AtchariyaM/LoRa-Technology-for-Environmental/us/image/15.jpg

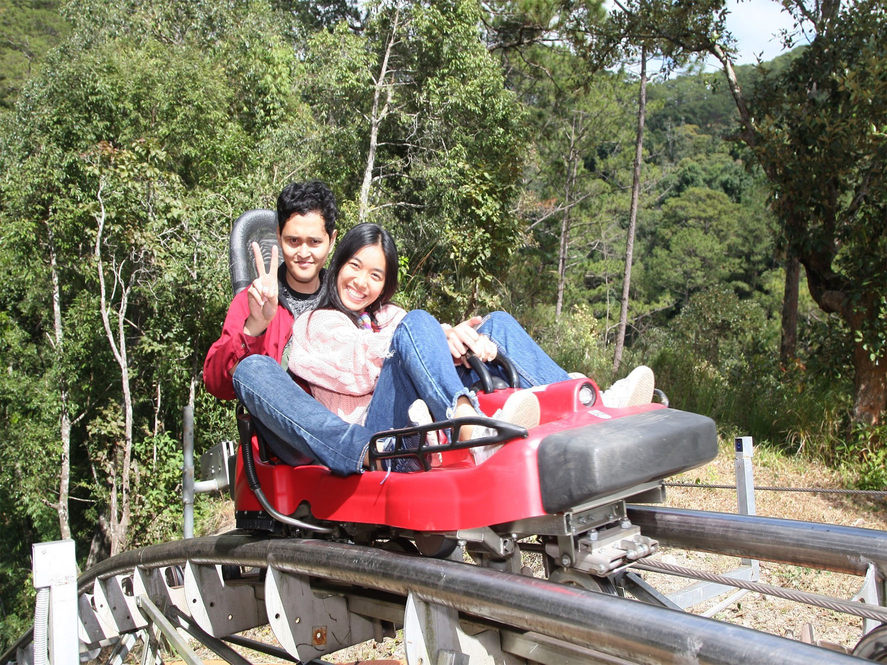
us/image/15.jpg
