AtchariyaM/LoRa-Technology-for-Environmental/us/image/17.jpg

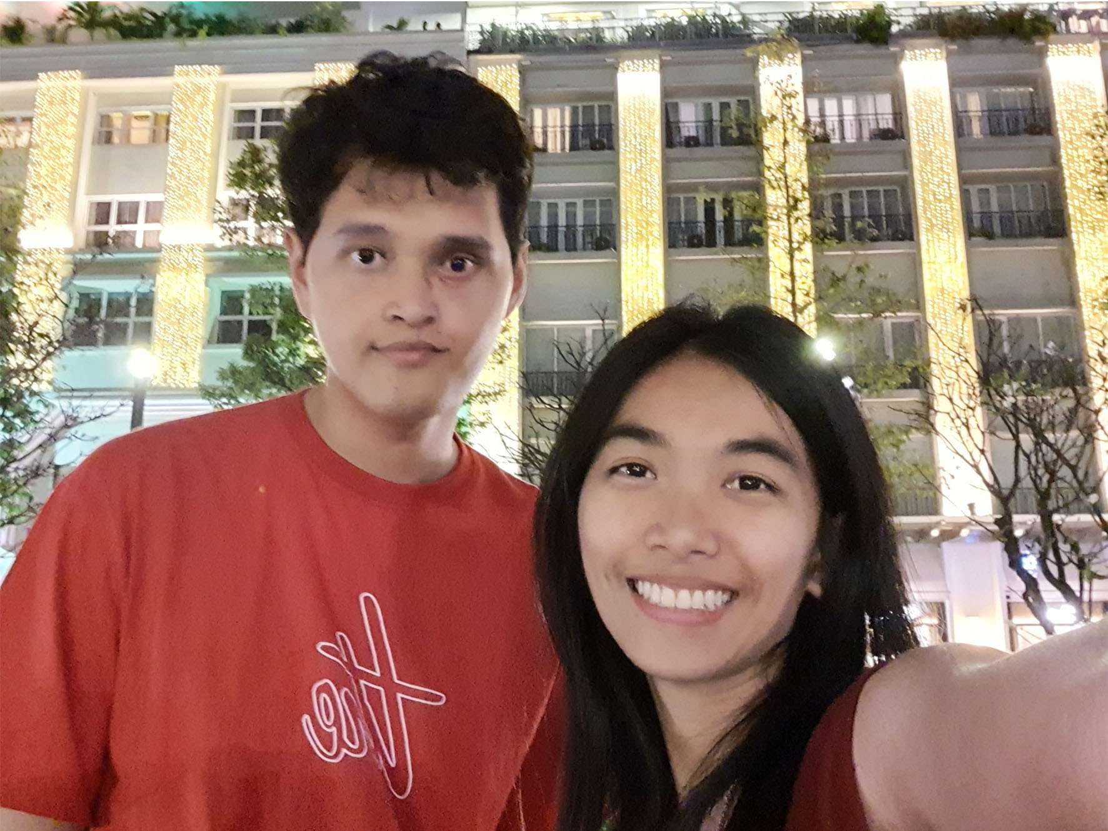
us/image/17.jpg
