AtchariyaM/LoRa-Technology-for-Environmental/lora/project-EE601-20/project-EE601-20.pdf

ระบบเซนเซอร์ทางด้านสิ่งแวดล้อมโดยใช้เทคโนโลยีลอร่าเพื่อการติดตามคุณภาพน ้า ENVIRONMENTAL SENSOR SYSTEM USING LORA TECHNOLOGY FOR WATER QUALITY MONITORING

อัจฉริยา | มะธิมะตา
พัสวี | มีสีผ่อง
รินทร์นภา | ฤทธิรงค์

ปริญญานิพนธ์นี เป็นส่วนหนึ่งของการศึกษาตามหลักสูตรวิศวกรรมศาสตรบัณฑิต ภาควิชาวิศวกรรมไฟฟ้า คณะวิศวกรรมศาสตร์ มหาวิทยาลัยบูรพา
ปีการศึกษา 2561

ระบบเซนเซอร์ทางด้านสิ่งแวดล้อมโดยใช้เทคโนโลยีลอร่าเพื่อการติดตามคุณภาพน ้า ENVIRONMENTAL SENSOR SYSTEM USING LORA TECHNOLOGY FOR WATER QUALITY MONITORING

อัจฉริยา | มะธิมะตา
พัสวี | มีสีผ่อง
รินทร์นภา | ฤทธิรงค์

ปริญญานิพนธ์นี เป็นส่วนหนึ่งของการศึกษาตามหลักสูตรวิศวกรรมศาสตรบัณฑิต ภาควิชาวิศวกรรมไฟฟ้า คณะวิศวกรรมศาสตร์ มหาวิทยาลัยบูรพา
ปีการศึกษา 2561

ENVIRONMENTAL SENSOR SYSTEM USING LORA TECHNOLOGY FOR WATER QUALITY MONITORING

ATCHARIYA MATIMATA
PASSAWEE MEESEEPONG
RINNAPA RITTHIRONG

A PROJECT SUBMITTED IN PARTIAL FULFILLMENT OF THE REQUIREMENTS FOR THE DEGREE OF BACHELOR OF ENGINEERING DEPARTMENT OF ELECTRICAL ENGINEERING BURAPHA UNIVERSITY 2018

ปริญญานิพนธ์ | ระบบเซนเซอร์ทางด้านสิ่งแวดล้อมโดยใช้เทคโนโลยีลอร่าเพื่อการติดตาม
| คุณภาพน ้า
โดย | นางสาวอัจฉริยา มะธิมะตา
| นางสาวพัสวี มีสีผ่อง
| นางสาวรินทร์นภา ฤทธิรงค์
อาจารย์ที่ปรึกษา | ดร.สัญชัย เอียดปราบ
จ้านวนหน้า | 81 หน้า
ปีการศึกษา | 2561

ภาควิชาวิศวกรรมไฟฟ้า คณะวิศวกรรมศาสตร์ มหาวิทยาลัยบูรพา อนุมัติปริญญานิพนธ์นี เป็นส่วน หนึ่งของการศึกษาตามหลักสูตรปริญญาวิศวกรรมศาสตรบัณฑิต สาขาวิชาวิศวกรรมไฟฟ้า

| ประธานกรรมการสอบปริญญานิพนธ์
(ดร.ภาณุวัฒน์ ด่านกลาง)
| กรรมการสอบปริญญานิพนธ์
(ผู้ช่วยศาสตราจารย์ดร.จันทนา ปัญญาวราภรณ์)
| กรรมการสอบปริญญานิพนธ์
(รองศาสตราจารย์วิรุฬห์ ศรีบริรักษ์)
| อาจารย์ที่ปรึกษา
(ดร.สัญชัย เอียดปราบ)
| หัวหน้าภาควิชาวิศวกรรมไฟฟ้า
(ดร.ณัฐพันธ์ ถนอมสัตย์)

บทคัดย่อ

การวัดคุณภาพน ้าโดยทั่วไปแล้วจะต้องท้าการวัดค่า ณ จุดที่ต้องการทดสอบ หากพื นที่ที่ต้องการวัด ทดสอบมีขนาดใหญ่ก็จะต้องเพิ่มจุดทดสอบหลายจุด และถ้าเป็นการวัดซ ้า ๆ เพื่อติดตามคุณภาพน ้าด้วยแล้ว ยิ่งท้าให้เกิดความยุ่งยาก และใช้เวลานาน โครงงานนี จึงเล็งเห็นความส้าคัญของปัญหาดังกล่าวข้างต้น จึงได้ ออกแบบระบบเซนเซอร์ทางด้านสิ่งแวดล้อมโดยใช้เทคโนโลยีลอร่าเฝ้าติดตามคุณภาพน ้า เป็นการวัดและเก็บ ข้อมูลคุณภาพน ้าตามพื นที่ที่ต้องการซ ้า ๆ ตามเวลาที่ก้าหนด ซึ่งค่าที่ท้าการวัดนั น ได้แก่ อุณหภูมิความเป็น กรดเป็นด่าง ปริมาณออกซิเจนที่ละลายน ้า และความสามารถในการออกซิไดซ์หลักการท้างานของระบบ เซนเซอร์คือ ข้อมูลจากเซนเซอร์จะส่งข้อมูลผ่านเทคโนโลยีลอร่าโดยมีการใช้โปรโตคอลลอร่าที่ออกแบบ แพ็กแก็ตส้าหรับในการส่งข้อมูลไปยังเกตเวย์ลอร่า ใช้เครือข่ายอินเทอร์เน็ตเป็นตัวกลางในการส่งข้อมูลมาที่ ฐานข้อมูล Firebase และแสดงผลผ่านเว็บไซต์โดยใช้ภาษา HTML JavaScript และ CSS ในการทดสอบใช้ งานพบว่าในพื นที่ที่มีสิ่งกีดขวางเทคโนโลยีลอร่าสามารถรับส่งข้อมูลถึงกันในระยะ 0-4.47 กิโลเมตร มีระดับ ความไวในการรับส่งสัญญาณอยู่ที่ -8 dBm ถึง -119 dBm เมื่อระยะทางไกลขึ นสัญญาณการรับส่งผ่าน เทคโนโลยีลอร่าเริ่มอ่อนลง คือมีระดับความไวในการรับสัญญาณอยู่ที่ -120 dBm เนื่องจากมุมอับสัญญาณ และค่าความถูกต้องของการวัดค่าคุณภาพน ้าขึ นอยู่กับค่าความคลาดเคลื่อนของอุปกรณ์เซนเซอร์ และเมื่อใช้ งานไประยะหนึ่งพบว่าอุปกรณ์บางตัวท้างานไม่เต็มประสิทธิภาพ อันเนื่องมาจากการเก็บรักษาหัววัดเป็นสิ่ง ส้าคัญ

ค้าส้าคัญ: การวัดคุณภาพน ้า ระบบเซนเซอร์ทางด้านสิ่งแวดล้อม เทคโนโลยีลอร่า

ii

Abstract

In general, the water quality measurements must be measured at the point of testing. If the area that needs to be tested is very large, there will need to add several test points. If there are repeated measurements to track the water quality, it will be complicated and it will take a long time. This project give precedence to the above problems and design the environmental sensors using LoRa technology to track the water quality. It is a measurement and data collection of water quality according to the area that requires repeated testing at the specified time. The values for the measurement are temperature, Potential of Hydrogen ion, Dissolved Oxygen and Oxidation Reduction Potential. The working principle of the sensor system is that the data from the sensor will be sent via the LoRa technology, using the LoRa protocol that designed a package for sending data to the LoRa gateway. The internet network is the medium for sending data to the Firebase database and is displayed via the website using HTML, JavaScript and CSS. In the test of usage, it was found that the areas with LoRa technological obstacles can receive and send data at a distance of 0-4.47 kilometers. The level of received signal strength indicator is will be at -8 dBm to -119 dBm. If the distance is longer, the signal of transmitting through the Laura technology will begin to weaken. The received signal strength indicator will be at -120 dBm because the airless and accuracy of the water quality measurement depends on the tolerance of the sensor device. When used for a while, it was found that some devices do not work efficiently because keeping the measure is important.

Keywords: Water quality measurement, Environmental sensor system, LoRa technology

iii

กิตติกรรมประกาศ

ปริญญานิพนธ์ฉบับนี ส้าเร็จลุล่วงไปได้ด้วยดี ด้วยความช่วยเหลืออย่างดียิ่งจาก อาจารย์ ดร. สัญชัย เอียดปราบ อาจารย์ที่ปรึกษาปริญญานิพนธ์ ที่ได้ให้ความอนุเคราะห์ คอยให้แนวคิด ค้าปรึกษาค้าแนะน้าและ ข้อคิดเห็นต่าง ๆ ในการท้าปริญญานิพนธ์มาโดยตลอด ขอขอบพระคุณคณะกรรมการสอบปริญญานิพนธ์ทุก ท่านที่กรุณาให้ค้าแนะน้าต่าง ๆ ที่เป็นประโยชน์ตลอดจนคณาจารย์ทุกท่านที่ไม่ได้กล่าวนามไว้ ณ ที่นี ผู้ด้าเนินโครงงาน ขอขอบคุณภาควิชาวิศวกรรมไฟฟ้า ที่ได้เอื อเฟื้อสถานที่ท้าการทดลอง เครื่องมือและอุปกรณ์ ในการด้าเนินโครงงาน อีกทั งขอขอบพระคุณที่สนับสนุนโครงงานในครั งนี ซึ่งท้าให้โครงงานในครั งนี ส้าเร็จลุล่วง ไปด้วยดีขอบคุณสมาชิกในกลุ่มทุกคนที่ให้ความช่วยเหลือ ตลอดจนค้าแนะน้าที่เป็นประโยชน์ในการท้า ปริญญานิพนธ์นี ท้ายที่สุด ขอกราบขอบพระคุณ คุณพ่อและคุณแม่ ผู้ปกครอง ที่ให้ค้าปรึกษาในเรื่องต่าง ๆ ให้ ความสะดวกสบาย รวมทั งเป็นผู้ให้ก้าลังใจ และให้โอกาสการศึกษาอันมีค่ายิ่ง ผู้ด้าเนินโครงงานขอขอบพระคุณ ทุกท่านอย่างสูงที่ให้ การสนับสนุน เอื อเฟื้อและให้ความอนุเคราะห์ช่วยเหลือ จนกระทั่งปริญญานิพนธ์ฉบับนี ส้าเร็จลุล่วงไปด้วยดี

iv

สารบัญ
หน้า

v

vi

vii

สารบัญรูปภาพ
หน้า

viii

สารบัญรูปภาพ (ต่อ)
หน้า

ix

สารบัญรูปภาพ (ต่อ)
หน้า

x

สารบัญตาราง
หน้า

บทที่ 1
บทน้า

### 1.1 บทน้า

การเฝ้าติดตามคุณภาพน ้าเป็นการวัด และเก็บข้อมูลคุณภาพน ้าตามพื นที่ที่ต้องการซ ้า ๆ ตามเวลาที่ ก้าหนด โดยอาจจะท้าการวัดทุกหนึ่งนาทีหรือทุกหนึ่งชั่วโมง ขึ นอยู่กับความละเอียดของข้อมูลที่น้าไปใช้ในการ วิเคราะห์ ซึ่งค่าที่ท้าการวัดนั น ได้แก่ อุณหภูมิ (Temperature) ความเป็นกรดเป็นด่าง (Potential of Hydrogen ion: pH) ปริมาณออกซิเจนที่ละลายน ้า (Dissolved Oxygen: DO) และความสามารถในการ ออกซิไดซ์ (Oxidation Reduction Potential: ORP) เพื่อน้าข้อมูลที่ได้มาวิเคราะห์สถานภาพของน ้าหรือ คาดการณ์ปัญหาที่จะเกิดขึ น และสามารถหาทางแก้ไขได้ทันเวลา แต่การวัดคุณภาพน ้าโดยทั่วไปแล้วจะได้ค่าที่ บริเวณที่ท้าการวัดเท่านั น หากพื นที่ที่ต้องการวัดทดสอบมีขนาดใหญ่ก็จะต้องเพิ่มจุดทดสอบหลายจุด และถ้า เป็นการวัดซ ้า ๆ เพื่อติดตามคุณภาพน ้าด้วยแล้วยิ่งท้าให้เกิดความยุ่งยาก และใช้เวลานาน จึงจ้าเป็นต้องใช้ ระบบเครือข่ายในการรับ-ส่ง และเก็บข้อมูลของอุปกรณ์วัดคุณภาพน ้าทั งหมด
เทคโนโลยีลอร่า (LoRa) เป็นเทคโนโลยีการส่งข้อมูลแบบไร้สายในระยะไกล ใช้พลังงานต่้า มีย่าน ความถี่ที่สามารถใช้งานได้ในย่านความถี่ 923 MHz โดยที่ไม่ต้องขออนุญาต โดยโครงงานนี ใช้อุปกรณ์พื นฐาน เป็นบอร์ด TTGO T-Beam ESP32 LoRa 923 MHz 2 ตัว เพื่อท้าหน้าที่เป็นตัวรับ-ส่งข้อมูลแบบไร้สาย ดังนั น โครงงานนี จึงน้าเสนอการน้าเทคโนโลยีลอร่ามาประยุกต์ใช้กับการเฝ้าติดตามคุณภาพน ้า โดยจะสร้างระบบ เซนเซอร์ทางด้านสิ่งแวดล้อม ทั งหมด 4 ตัว เซนเซอร์แต่ละตัวจะสามารถวัดค่าอุณหภูมิ ความเป็นกรดเป็น ด่าง ปริมาณออกซิเจนที่ละลายน ้า และความสามารถในการออกซิไดซ์ โดยระบบเซนเซอร์ที่น้ามาใช้ในการวัด คุณภาพน ้า จะถูกติดตั งไว้ที่บอร์ดฝั่งส่งข้อมูล เพื่อส่งข้อมูลไปยังฝั่งรับ แล้วท้าการรวบรวมข้อมูลที่วัดได้ส่ง ต่อไปเก็บไว้ในฐานข้อมูล เพื่อแสดงผลคุณภาพน ้าและท้าการวิเคราะห์คุณภาพน ้าแบบเวลาจริงต่อไป

### 1.2 วัตถุประสงค์

1) เพื่อศึกษาเกี่ยวกับการวัดคุณภาพน ้าโดยใช้เซนเซอร์ทางด้านสิ่งแวดล้อมทั งหมด 4 ตัว ได้แก่ เซนเซอร์วัดค่าอุณหภูมิ เซนเซอร์วัดความเป็นกรดเป็นด่าง เซนเซอร์วัดออกปริมาณออกซิเจนที่ ละลายน ้า และเซนเซอร์วัดความสามารถในการออกซิไดซ์
2) เพื่อศึกษาเกี่ยวกับการสร้างระบบเซนเซอร์ทางด้านสิ่งแวดล้อมโดยใช้เทคโนโลยีลอร่า และการ เลือกใช้โปรโตคอลในการรับ–ส่งข้อมูลให้เหมาะสม
3) เพื่อศึกษาเกี่ยวกับการระบุต้าแหน่งอุปกรณ์โดยใช้หลักการการระบุต้าแหน่งบนพื นโลก (GPS)
4) เพื่อออกแบบและสร้างระบบเซนเซอร์ทางด้านสิ่งแวดล้อมโดยใช้เทคโนโลยีลอร่า
5) เพื่อท้าการวิเคราะห์คุณภาพน ้าและแสดงผลข้อมูลแบบเวลาจริง

### 1.3 ขอบเขตการท้าโครงงาน

1) ออกแบบ และสร้างระบบเซนเซอร์ทางด้านสิ่งแวดล้อมโดยใช้เทคโนโลยีลอร่า โดยสามารถวัดค่า อุณหภูมิ ความเป็นกรดเป็นด่าง ปริมาณออกซิเจนละลายน ้า และความสามารถในการออกซิไดซ์ โดยใช้แบตเตอรี่ที่ชาร์จพลังงาน
2) ใช้บอร์ด TTGO T-Beam ESP32 LoRa 923 MHz เป็นตัวควบคุมเซนเซอร์ และส่งข้อมูลผ่าน เทคโนโลยีลอร่า
3) สร้างฐานข้อมูลโดยใช้ Firebase Realtime Database
4) สร้างหน้าเว็บส้าหรับวิเคราะห์คุณภาพน ้าและแสดงผลข้อมูลแบบเวลาจริงโดยใช้ภาษา HTML JavaScript และ CSS
5) พื นที่ในการทดสอบคือแหล่งน ้าสวนนันทนาการ มหาวิทยาลัยบูรพา

### 1.4 แผนการด้าเนินการ

1) จัดท้า และเสนอหัวข้อโครงงาน
2) ศึกษารูปแบบ และหลักการท้างานของเซนเซอร์เซนเซอร์ทางด้านสิ่งแวดล้อม
3) ศึกษาหลักการท้างานของระบบเซนเซอร์ทางด้านสิ่งแวดล้อม
4) ออกแบบ และสร้างระบบเซนเซอร์ทางด้านสิ่งแวดล้อมโดยใช้เทคโนโลยีลอร่า
5) ศึกษาการเลือกใช้โปรโตคอลในการรับ–ส่งข้อมูล
6) วิเคราะห์ปัญหา และออกแบบวิธีการแก้ปัญหา
7) ทดสอบระบบเซนเซอร์ทางด้านสิ่งแวดล้อมโดยใช้เทคโนโลยีลอร่า
8) ออกแบบ และสร้างฐานข้อมูลส้าหรับเก็บข้อมูลคุณภาพน ้า
9) ออกแบบ และสร้างหน้าเว็บไซต์ส้าหรับวิเคราะห์และแสดงผลคุณภาพน ้า
10) ประเมินผลการทดสอบและปรับปรุงแก้ไขข้อบกพร่อง
11) จัดท้าเอกสารโครงงานฉบับสมบูรณ์

ตารางที่ 1.1 แผนการด้าเนินงานของโครงงาน
ขั นตอนที่ | โครงงานวิศวกรรม 1 | โครงงานวิศวกรรม 2
ส.ค. | ก.ย. | ต.ค. | พ.ย. | ธ.ค. | ม.ค. | ก.พ. | มี.ค. | เม.ย. | พ.ค.
1 | 2 | 3 | 4 | 1 | 2 | 3 | 4 | 1 | 2 | 3 | 4 | 1 | 2 | 3 | 4 | 1 | 2 | 3 | 4 | 1 | 2 | 3 | 4 | 1 | 2 | 3 | 4 | 1 | 2 | 3 | 4 | 1 | 2 | 3 | 4 | 1 | 2 | 3 | 4
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
### 1.5 ประโยชน์ที่คาดว่าจะได้รับ

1) ได้ความรู้เกี่ยวกับการวัดคุณภาพน ้าโดยใช้เซนเซอร์
2) ได้ความรู้เกี่ยวกับการสร้างระบบเซนเซอร์ทางด้านสิ่งแวดล้อมโดยใช้เทคโนโลยีลอร่า และการ เลือกใช้โปรโตคอลในการรับ-ส่งข้อมูลให้เหมาะสม
3) สามารถออกแบบ และสร้างระบบเซนเซอร์ทางด้านสิ่งแวดล้อมโดยใช้เทคโนโลยีลอร่า
4) สามารถน้าระบบเซนเซอร์ทางด้านสิ่งแวดล้อมโดยใช้เทคโนโลยีลอร่าไปประยุกต์ใช้จริง

บทที่ 2
ทฤษฎีและงานวิจัยที่เกี่ยวข้อง

ในการท้าโครงงานสร้างระบบเซนเซอร์ทางด้านสิ่งแวดล้อมโดยใช้เทคโนโลยีลอร่า เพื่อการติดตาม คุณภาพน ้านี จ้าเป็นต้องศึกษาความรู้ทางด้านทฤษฎีที่มีความเกี่ยวข้อง โดยการศึกษาค้นคว้าจากแหล่งต่างๆ สามารถสรุปสาระส้าคัญได้ ดังนี

### 2.1 ตัวชี วัดคุณภาพน ้า

ตัวชี วัดคุณภาพน ้า เป็นตัวชี วัดบอกว่าคุณภาพน ้าดีหรือ ไม่ดีโดยขึ นอยู่กับปริมาณความเข้มข้นของ สารที่สนใจวัดค่า การวัดประเมินค่าคุณภาพนั นจะมีการเปรียบเทียบความเข้มข้นของสารที่เกิดขึ น กับสภาพ ตามธรรมชาติ สภาพอ้างอิง หรือสภาพเดิม ตามเงื่อนไขที่จะปกป้องสุขภาพของมนุษย์ หรือนิเวศวิทยาเป็นหลัก ตัวชี วัดที่มีการน้ามาใช้ในการวัดคุณภาพน ้าที่น้ามาใช้ ได้แก่
1) อุณหภูมิ(Temperature)
2) ค่าความเป็นกรดเป็นด่างด่าง (Potential of Hydrogen ion: pH)
3) ปริมาณออกซิเจนที่ละลายน ้า (Dissolved Oxygen: DO)
4) ค่าความสามารถในการออกซิไดซ์(Oxidation Reduction Potential: ORP)

### 2.1.1 อุณหภูมิ

อุณหภูมิคือการวัดค่าเฉลี่ยของพลังงานจลน์ของอนุภาค ในสสารใด ๆ เกิดขึ นจากอะตอมแต่ละตัว หรือแต่ละโมเลกุลของสสาร เมื่อใส่พลังงานความร้อนให้กับสสาร อะตอมของสสารจะเคลื่อนที่เร็วขึ น ท้าให้ อุณหภูมิสูงขึ น แต่เมื่อท้าการลดพลังงานความร้อน อะตอมของสสารจะเคลื่อนที่ช้าลง ท้าให้อุณหภูมิลดต่้าลง ซึ่งหากต้มน ้าด้วยถ้วยและหม้อบนเตาเดียวกัน จะเห็นได้ว่าน ้าในถ้วยจะมีอุณหภูมิสูงกว่า แต่จะมีพลังงานความ ร้อนน้อยกว่าในหม้อ เนื่องจากปริมาณความร้อนขึ นอยู่กับมวลทั งหมดของสสาร แต่อุณหภูมิเป็นเพียงค่าเฉลี่ย ของพลังงานในแต่ละอะตอม ซึ่งสอดคล้องกับความร้อนหรือเย็นของสสารนั น ในการศึกษาฟิสิกส์เชิงสถิติ สามารถตีความค้านิยามอุณหภูมิในอุณหพลศาสตร์ว่า เป็นการวัดพลังงานเฉลี่ยของอนุภาคในแต่ละองศาอิสระ ในระบบอุณหพลศาสตร์ โดยที่อุณหภูมินั นสามารถมองเป็นคุณสมบัติเชิงสถิติ(วิกิพีเดีย สารานุกรมเสรี, 2561) ความสัมพันธ์ของค่าความเป็นกรดเป็นด่างกับอุณหภูมิ ส้าหรับตัวเลขที่แสดงค่าความเป็นกรดเป็นด่าง ถ้าพิจารณาอย่างง่ายที่อุณหภูมิห้อง ค่าความเป็นกรดเป็นด่างของสารที่อุณหภูมิห้องเท่ากับ 7 แสดงว่าสารนั น เป็นกลางไม่มีฤทธิ์เป็นกรดหรือด่าง เช่น น ้าบริสุทธิ์ ถ้ามีค่าน้อยกว่า 7 แสดงว่าเป็นกรด และถ้ามากกว่า 7 แสดง ว่าเป็นด่าง (Chananchida Phoking, (https://www.blogger.com/profile/02398964853763434921) 2553)
ความสัมพันธ์ของปริมาณการละลายของออกซิเจนในน ้ากับอุณหภูมิ เป็นเครื่องบ่งบอกการชี บอก คุณภาพของน ้าในแหล่งนั น ถ้าหากปริมาณการละลายของออกซิเจนในน ้าน้อยผิดปกติ แสดงว่าน ้าเสีย ท้าให้ สิ่งมีชีวิตต่าง ๆ อยู่ไม่ได้ ออกซิเจนที่ละลายอยู่ในน ้า มาจากอากาศเป็นแหล่งส้าคัญ ปริมาณการละลายของ

ออกซิเจนในน ้าขึ นอยู่กับอุณหภูมิและความดันอากาศ หากอุณหภูมิของน ้าต่้า ท้าให้กาซออกซิเจนใน บรรยากาศจะสามารถละลายลงไปในน ้าได้มากขึ น ท้าให้ปริมาณการละลายของออกซิเจนในน ้ามีค่ามาก และ ในทางกลับกัน หากอุณหภูมิของน ้าสูงขึ น ท้าให้กาซออกซิเจนในบรรยากาศจะสามารถละลายลงไปในน ้าได้ น้อยลง ท้าให้ปริมาณการละลายของออกซิเจนในน ้ามีค่าน้อย แต่ถ้าความดันอากาศสูงขึ นจะละลายได้มากขึ น อยู่ที่ปริมาณธาตุอาหารมากน้อยในแหล่งน ้านั นด้วย น ้าโสโครกจากชุมชนท้าให้น ้าในแหล่งน ้าเน่าเสียเพราะสิ่ง โสโครกมักมีสารอินทรีย์ซึ่งจะมีการย่อยสลายโดยแบคทีเรียจุลชีพเหล่านั นต้องการออกซิเจนในการย่อยสลาย สารอินทรีย์ที่ปะปนอยู่ในน ้าท้าให้ปริมาณออกซิเจนลดลง มลพิษทางน ้าอาจเกิดจากน ้าทิ งของโรงงาน อุตสาหกรรม และน ้าจากเกษตรกรรมด้วย ปลาหายใจในน ้า เนื่องจากปลารับออกซิเจนจากน ้า ไม่ใช่จากอากาศ น ้าผ่านช่องปาก แล้วผ่านต่อไปเข้าช่องเหงือกเหงือกจะรับเอาออกซิเจนไว้ แล้วถ่ายคาร์บอนไดออกไซด์ให้กับ น ้าที่ผ่านเข้าไป (กฤษณา ชุติมา, 2541)
ส้าหรับการวัดอุณหภูมิของน ้านั นจะหมายถึงการวัดปริมาณพลังงานแสงอาทิตย์ที่น ้ารับไว้ รวมทั งดิน และอากาศที่อยู่บริเวณโดยรอบด้วย ถ้าน ้ารับพลังงานความร้อนจากแสงอาทิตย์ได้มากก็จะท้าให้อุณหภูมิของ น ้าสูงขึ นด้วย นอกจากนี น ้าจากโรงงานก็อาจท้าให้อุณหภูมิของแหล่งน ้าสูงขึ นได้อีกทางหนึ่ง การระเหยของน ้า ที่ผิวโลกสามารถช่วยลดอุณหภูมิของน ้าในบริเวณผิวหน้าน ้าที่ไม่ลึกนัก การวัดอุณหภูมิของน ้าท้าให้เข้าใจถึง รูปแบบของการเปลี่ยนแปลงที่เกิดขึ นในรอบปี ทั งนี เพราะอุณหภูมิของน ้าในแหล่งน ้าจะมีอิทธิพลสูงต่อปริมาณ และความหลากหลายของสิ่งมีชีวิตในแหล่งน ้านั น (สถาบันส่งเสริมการสอนวิทยาศาสตร์และเทคโนโลยี, 2561)

### 2.1.2 ความเป็นกรดเป็นด่าง

ความเป็นกรดเป็นด่าง เป็นตัววัดปริมาณไอออนไฮโดรเจนในสารละลาย หากค่าความเป็นกรดเป็นด่าง ต่้าจะมีไอออนไฮโดรเจนอิสระอยู่ในน ้าจ้านวนมากในขณะที่ ค่าความเป็นกรดเป็นด่างสูงมีไอออนไฮโดรเจน อิสระอยู่ในน ้าเพียงเล็กน้อย ในทางเทคนิคค่าความเป็นกรดเป็นด่างเป็นลอการิทึมเชิงลบของไฮโดรเจนอิสระใน สารละลาย และยังสามารถอธิบายความเป็นกรดหรือความเป็นด่างของสารละลาย หากค่ามีต่้า แสดงถึงสภาวะ ความเป็นกรดและหากมีค่าสูงแสดงถึงสภาวะความเป็นด่าง ดังนั น ความเป็นกรดเป็นด่างจึงมีความส้าคัญเป็น อย่างมากและใช้ในการตรวจสอบความปลอดภัยของสภาพน ้า สัตว์หลายชนิดไม่สามารถอาศัยอยู่ในน ้าที่มีค่า ความเป็นกรดเป็นด่าง ต่้ากว่า 5 หรือสูงกว่า 9 การเพิ่มขึ นหรือลดลงของค่าความเป็นกรดเป็นด่าง อาจบ่งบอก ถึงมลภาวะทางน ้าที่มีการปนเปื้อนของสารเคมีหรือฝนกรด
ค่าความเป็นกรดเป็นด่าง สามารถวัดได้โดยถูกวัดออกมาเป็นปริมาณค่าโดยมีค่าจาก 0 ถึง 14 โดย หากมีค่าเป็น 7 คือ ค่าที่เป็นกลาง ค่าที่ต่้ากว่า 7 เป็นกรด ค่าที่มากกว่า 7 เป็นด่าง ดังแสดงในรูปที่ 2.1 ส้าหรับ ค่าความเป็นกรดเป็นด่างที่น้อยกว่าแสดงถึงจ้านวนไอออนไฮโดรเจนที่มากกว่า และค่าความเป็นกรดเป็นด่าง แต่ละหน่วยแสดงถึงการเปลี่ยนแปลงความเข้มข้นของไอออนไฮโดรเจน 10 เท่าและปริมาณความเป็นกรด ตัวอย่างเช่น ความเป็นกรดเป็นด่าง 6 มีไอออนไฮโดรเจนอิสระมากกว่า ความเป็นกรดเป็นด่าง 7 จ้านวน 10 เท่า และมีไอออนไฮโดรเจนอิสระมากกว่า ความเป็นกรดเป็นด่าง 8 จ้านวน 100 เท่า (บริษัท จัสท์ คอนเน็ก จ้ากัด, 2561)

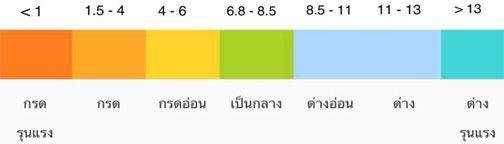
[picture p3: figure]

รูปที่ 2.1 สถานะค่าความเป็นกรดเป็นด่าง ที่มา: Warunya (2561)

### 2.1.3 ปริมาณออกซิเจนที่ละลายน ้า

สิ่งมีชีวิตชนิดต่าง ๆ ที่อาศัยอยู่ในน ้าต้องการปริมาณออกซิเจนแตกต่างกัน แต่โดยทั่วไปแล้วสิ่งมีชีวิต ในน ้าต้องการออกซิเจนที่ละลายอยู่ในน ้าอย่างน้อยที่สุด 6 mg/l เพื่อการเติบโตและการพัฒนาการของชีวิต อุณหภูมิของน ้าและระดับความสูงของพื นที่มีอิทธิพลต่อปริมาณออกซิเจนที่สามารถละลายได้ในน ้า หรือ เรียกว่า ค่าสมดุล บ่งบอกการชี บอกคุณภาพของน ้าในแหล่งนั น ถ้าหากปริมาณออกซิเจนน้อยผิดปกติ แสดงว่า น ้าเสีย ท้าให้สิ่งมีชีวิตต่าง ๆ อยู่ไม่ได้ ออกซิเจนที่ละลายอยู่ในน ้า โดยทั่วไปแล้วพบว่าน ้าที่อุ่นกว่าไม่สามารถดึง หรือละลายออกซิเจนไว้ได้มากเท่ากับน ้าที่เย็นกว่า ในท้านองเดียวกันน ้าที่พบในระดับที่มีความสูงกว่าไม่ สามารถดึงหรือละลายออกซิเจนไว้ได้มากเท่ากับน ้าที่พบในพื นที่ระดับที่ต่้ากว่า ในส่วนของปริมาณของ ออกซิเจนที่ละลายน ้าที่ตรวจวัดได้นั น อาจจะสูงกว่าหรือต่้ากว่าค่าสมดุลได้ เนื่องจากแบคทีเรียในแหล่งน ้าจะ ใช้ออกซิเจนในขณะที่ก้าลังย่อยสลายเศษซากพืช ซากสัตว์ในแหล่งน ้านั น ซึ่งอาจท้าให้ระดับของออกซิเจนที่ ละลายน ้าในแหล่งน ้านั นลดลง ในทางกลับกันพบว่าสาหร่ายในน ้าจะสร้างออกซิเจนในขณะที่ท้าการสังเคราะห์ แสง ซึ่งท้าให้ในบางครั งพบว่า ในช่วงฤดูร้อน ระดับของออกซิเจนที่ละลายน ้าจะสูงกว่าในฤดูอื่น ในการตรวจวัด ออกซิเจนละลายน ้าสามารถท้าได้โดยวิธีการไตเตรต ซึ่งอาจเก็บน ้าตัวอย่างมาตรวจวัดทันทีในห้องปฏิบัติการ หรืออาจตรวจวัดในภาคสนามโดยชุดตรวจวัดออกซิเจนที่ละลายน ้า ซึ่งจะมีคู่มือแสดงขั นตอนการตรวจวัดอย่าง ชัดเจน (สถาบันส่งเสริมการสอนวิทยาศาสตร์และเทคโนโลยี, 2561)

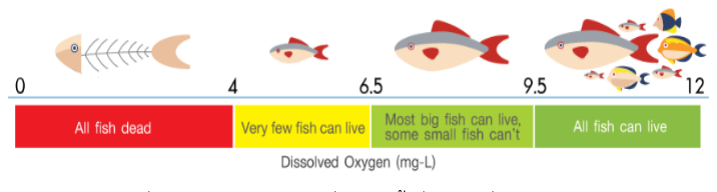
[picture p4: figure]

รูปที่ 2.2 ปริมาณออกซิเจนที่ละลายน ้าที่มีผลต่อสิ่งแวดล้อม ที่มา: บริษัท เลกะ คอร์ปอเรชั่น จ้ากัด (2559)

### 2.1.4 ความสามารถในการออกซิไดซ์

ความสามารถในการเกิดออกซิเดชัน และการเกิดรีดักชัน หากความสามารถในการรีดักชันมีค่าสูง จะ ให้ค่า ความสามารถในการออกซิไดซ์ลดลง (เป็นลบ) แต่หากความสามารถในการออกซิเดชันมีค่าสูง จะให้ค่า ความสามารถในการออกซิไดซ์สูงขึ น (เป็นบวก) โดยทั่วไปแล้ว ความสามารถในการออกซิไดซ์จะวัดในหน่วย mV ตัวชี วัดค่าความสามารถในการออกซิไดซ์จะมีความสัมพันธ์เกี่ยวข้องกับค่าความเป็นกรดเป็นด่างแสดงให้ เห็นถึงคุณภาพน ้า เช่น น ้าที่มีประจุบวก เหมาะส้าหรับฆ่าเชื อโรค (ความสามารถในการออกซิไดซ์เป็นบวก ความเป็นกรดเป็นด่างมีค่าต่้ากว่า7) น ้าดื่มที่มีอิเล็กตรอนประจุลบเหมาะส้าหรับบริโภค (ความสามารถในการ ออกซิไดซ์เป็นลบ ความเป็นกรดเป็นด่างมีค่ามากกว่า 7)
น ้าโดยทั่วไปเช่นน ้าประปา น ้าบาดาล น ้าพุ และน ้ารีเวอร์สออสโมซิส ต่างก็มีค่า ความสามารถในการ ออกซิไดซ์ที่สูงถึง 300 มิลลิโวลต์สามารถเห็นจากแผนภูมิได้ว่า น ้าประปาโดยทั่วไปแล้วจะมีค่า ความสามารถ ในการออกซิไดซ์สูงสุดที่ 354 มิลลิโวลต์เมื่อเทียบกับข้อมูลนี แล้ว อวัยวะแต่ละอวัยวะในระบบย่อยอาหาร มี ระดับค่าความสามารถในการออกซิไดซ์ที่เฉพาะเจาะจงตั งแต่ -10 มิลลิโวลต์ ถึง -250 มิลลิโวลต์และส้าหรับ น ้าดื่มควรมีค่า ความสามารถในการออกซิไดซ์เป็นลบเพื่อสุขภาพของตน แต่หากค่าความสามารถในการ ออกซิไดซ์เป็นบวกนั นเท่ากับว่าในน ้ามีตัวออกซิไดซ์อยู่เป็นจ้านวนมาก และเมื่อกล่าวถึงตัวออกซิไดซ์ตัว ออกซิไดซ์หมายถึงสาร เช่นคลอรีน ไฮโดรเจนเปอร์ออกไซด์ และโบรมีน ซึ่งเรียกสารเหล่านี ว่าสิ่งปนเปื้อน ดังนั น การดื่มน ้าที่มีค่า ความสามารถในการออกซิไดซ์เป็นลบ จึงเป็นสิ่งที่จ้าเป็นส้าหรับร่างกาย (บริษัท เลกะ คอร์ปอเรชั่น จ้ากัด)

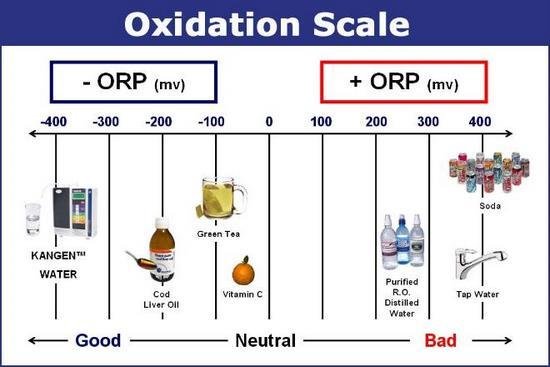
[picture p5: figure]

รูปที่ 2.3 แนวโน้มของชนิดสารเคมีเพื่อรับอิเล็กตรอนและให้อิเล็กตรอน ที่มีผลต่อสิ่งแวดล้อม ที่มา: Kangenwater (2561)

### 2.2 เทคโนโลยีลอร่า

เทคโนโลยีลอร่า คือชื่อเรียกของเทคโนโลยีการมอดูเลชั่น เพื่อเข้ารหัสข้อมูลกับสัญญาณทางไฟฟ้า ส่งออกในรูปแบบของคลื่นความถี่วิทยุค้าว่า LoRa เป็นชื่อที่เรียกย่อมาจาก Long Range Low Power Wireless Platform โดยน้าสองตัวอักษรด้านหน้าของสองค้าแรกมาใช้เป็นชื่อที่ใช้เรียกอุปกรณ์ที่มีการสื่อสาร แบบลอร่า ซึ่งสามารถสร้างการสื่อสารแบบนี ได้โดยใช้ชิฟ Semtech LoRa Chip และเทคนิคการมอดูเลชัน แบบเชิร์ปสเปรดสเปกตรัม (Chirp Spread Spectrum Modulation) โดยใช้สัญญาณเชิร์ปความชันคงที่ (Constant Ramp Chirp Signal) ในการเพิ่มประสิทธิภาพการรับสัญญาณให้มีค่าความไว ที่ดีขึ นกว่า กระบวนการมอดูเลตชนิดอื่น ๆ โดยความแตกต่างของความถี่ระหว่างตัวรับและตัวส่งของสัญญาณเชิร์ปความ ชันคงที่มีลักษณะคล้ายกับ ความแตกต่างของเวลา ซึ่งง่ายต่อการจัดการ และส่งผลให้วงจรรับและวงจรส่ง สามารถใช้อุปกรณ์ก้าเนิดความถี่ที่มีราคาไม่สูงได้ ไม่จ้าเป็นต้องใช้อุปกรณ์ก้าเนิดความถี่ที่มีความแม่นย้าสูง (Ausustin, 2559) ซึ่งค่าความถี่ที่แตกต่างกันของตัวรับและตัวส่งอาจมีความแตกต่างมากถึงร้อยละ 20 โดยค่า ความไวของการรับจาการมอดูเลตชนิดนี สามารถท้าให้รับได้ที่ระดับสัญญาณต่้ากว่า -140 dBm ซึ่งถือว่าต่้า มากเมื่อเทียบกับการมอดูเลตชนิดอื่นๆ ที่ใช้อยู่ในชิกบีและไวไฟ ที่อยู่ในระดับ -100 dBm ถึง -110 dBm เท่านั น อีกหนึ่งประสิทธิภาพที่โดดเด่นของลอร่าคือ ความสามารถในการดีมอดูเลตหลายสัญญาณที่ถูกส่งมา พร้อมกันที่ความถี่เดียวกันได้ โดยสัญญาณที่ถูกส่งมาพร้อมกันจะต้องมีอัตราเซิร์ปที่แตกต่างกันโดยใช้ค่า สเปรดแฟกเตอร์ที่แตกต่างกัน ผลของการดีมอดูเลตหลายสัญญาณพร้อมกันที่ความถี่เดียว ท้าให้ลอร่าสามารถ รองรับจ้านวนอุปกรณ์ไอโอทีได้จ้านวนมาก
จากที่กล่าวมา ลอร่าเป็นกระบวนการในชั นกายภาพ และมีการจัดเฟรมข้อมูลด้วยรูปแบบเฉพาะใน ชั นเส้นทางเชื่อมโยงข้อมูล การน้าลอร่ามาใช้งานไอโอทีจ้าเป็นต้องส่งต่อข้อมูลจากอุปกรณ์ลอร่าเข้าสู่ อินเทอร์เน็ตผ่านลอร่าเกตเวย์ไปยัง LoRa-Wan ซึ่งมีโพรโทคอลในการส่งผ่านข้อมูลเข้าสู่อินเทอร์เน็ตได้ ช่วย ให้สามารถสื่อสารข้อมูลในปริมาณน้อยหรือแบนด์วิธต่้า ได้ในระยะไกล มีความสามารถในการป้องกันสัญญาณ รบกวน และใช้พลังงานต่้า (ปรีชา ก่อเจริญ, 2560)

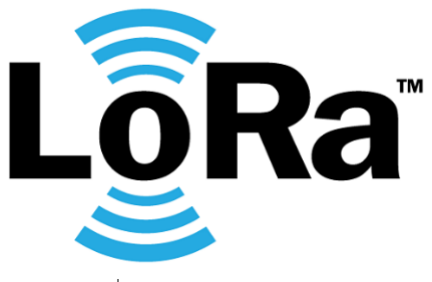
[picture p6: figure]

รูปที่ 2.4 สัญลักษณ์เทคโนโลยีลอร่า ที่มา: Maker.io (2559)

### 2.2.1 ความถี่ของลอร่า

เทคโนโลยีลอร่าใช้ความถี่ที่ไม่มีลิขสิทธิ์ ซึ่งแต่ละที่จะมีช่องความถี่ที่อนุญาตไทย ล่าสุด กสทช. ได้ อนุญาตให้ใช้งานลอร่า ในช่วงความถี่ 920-925 MHz ก้าลังส่งสูงสุดถึง 4 วัตต์(ปรีชา ก่อเจริญ, 2560) ให้ใช้ งาน แตกต่างกันออกไป 868 MHz ส้าหรับยุโรป 923 MHz ส้าหรับอเมริกาเหนือ 433 MHz ส้าหรับเอเชีย ส้าหรับในประเทศไทยสามารถใช้ได้ในช่วง 433 MHz และ 923 MHz โดยเอกสารข้อก้าหนด IoT ในประเทศ

### 2.2.2 ลอร่ากับสถาปัตยกรรมเครือข่าย

ในส่วนของลอร่าบนชั นอินเทอร์เน็ตจะอยู่ในสถาปัตยกรรมเครือข่ายแบบ LoRa-Wan (LoRa Aliance, 2558) ที่ใช้ทอพอลอจีแบบสตาร์ มีการใช้งานเกตเวย์ในการรีเลย์ข้อมูลระหว่างอุปกรณ์ไอโอทีลอร่า ปลายทางมายังเชิร์ฟเวอร์ในเครือข่ายอินเทอร์เน็ต อุปกรณ์ลอร่ามีการส่งคลื่นที่แถบความถี่และตัวประกอบการ แพร่กระจายที่แตกต่างกันได้ ลอร่าเกตเวย์จ้าเป็นต้องรองรับการส่งสัญญาณในลักษณะดังกล่าว และจากการที่ ใช้ค่าตัวประกอบการแพร่กระจายที่แตกต่างกัน ท้าให้สามารถมีปริมาณจ้านวนอุปกรณ์ไอโอทีในเครือข่ายลอร่า ได้จ้านวนมากบนความเร็วของการสื่อสารที่แตกต่างกันระหว่าง 0.3-50 kbps แปรผันตามค่าตัวประกอบการ แพร่กระจายที่ใช้ในการมอดูเลต LoRa-Wan มีกระบวนการในการจัดการพลังงานของอุปกรณ์ลอร่าแต่ละตัวให้ มีระยะเวลาการใช้งานได้นานที่สุดด้วยการปรับค่าอัตราความเร็วของการสื่อสารและค่าก้าลังส่งแบบอัตโนมัติ (ปรีชา ก่อเจริญ, 2560)
ประกอบด้วย 4 ส่วนคือ
1) Device: อุปกรณ์หรือเซนเซอร์ส่งสัญญาณแบบลอร่า
2) Gateways: อุปกรณ์รับข้อมูลแบบลอร่า
3) Network server: ส้าหรับส่งข้อมูลขึ นบน เซิร์ฟเวอร์
4) Application: ส้าหรับประมวลผลหรือแสดงผลข้อมูล

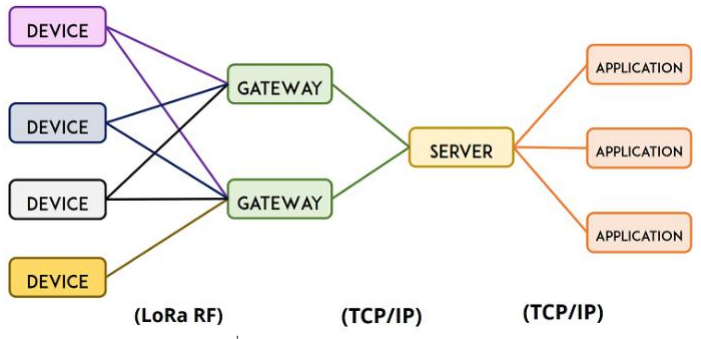
[picture p7: figure]

รูปที่ 2.5 องค์ประกอบของเครือข่ายลอร่า ที่มา: Arduinoall (2562)

### 2.2.3 ลักษณะของการสื่อสารระหว่าง LoRa-Wan และอุปกรณ์ลอร่า

ประเภทของอุปกรณ์มี 3 ประเภท โดยอุปกรณ์ทั งหมดต้องด้าเนินการอยู่บน Class A เป็นพื นฐาน ในขณะที่ Class B และ Class C เป็นส่วนขยายส้าหรับข้อก้าหนดของอุปกรณ์ Class A
- Uplink Message คือ ข้อความจากอุปกรณ์ไปที่แอปพลิเคชัน
- downlink Message คือ ข้อความจากแอปพลิเคชัน ไปที่อุปกรณ์

### 2.2.3.1 Class A (all)

ตัวอุปกรณ์จะรองรับการสื่อสารแบบสองทิศทางระหว่างอุปกรณ์กับเกตเวย์การส่งข้อความ จาก อุปกรณ์ไปที่เซิร์ฟเวอร์สามารถท้าได้ตลอดเวลาแบบสุ่ม โดยตัว อุปกรณ์จะท้าการเปิด 2 หน้าต่างรับ ข้อมูล ในเวลาที่ก้าหนด อุปกรณ์จะอยู่ในโหมดสลีป และแบตเตอรี่จะถูกเก็บไว้หมายความว่าเครือข่ายไม่ สามารถส่ง downlink ได้จนกว่าอุปกรณ์จะปลุก หลังจากส่งข้อความไปแล้ว ถ้าเซิร์ฟเวอร์ไม่มีการตอบสนอง ต่อหน้าต่างรับข้อมูลทั งสองของอุปกรณ์โอกาสต่อไปที่เซิร์ฟเวอร์จะท้าการ downlink message ลงมาได้คือ เมื่อเสร็จสิ นการส่งข้อความจากอุปกรณ์ไปที่เซิร์ฟเวอร์ครั งต่อไป เซิร์ฟเวอร์สามารถตอบสนองได้ทั งหน้าต่างรับ ข้อมูลตัวที่ 1 หรือหน้าต่างรับข้อมูลตัวที่ 2 แต่ไม่ควรใช้ทั งสองหน้าต่าง

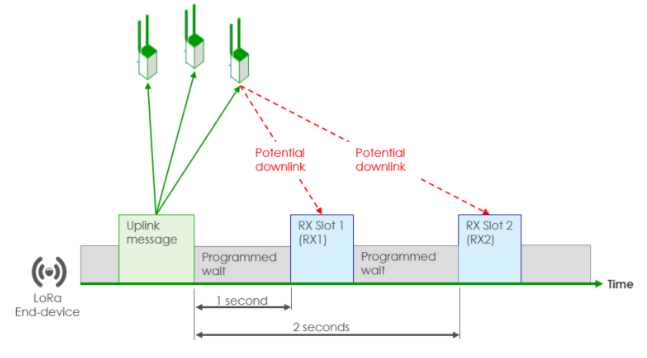
[picture p8: figure]

รูปที่ 2.6 การสื่อสารของอุปกรณ์ลอร่า Class A ที่มา: Lennart Nordin (2562)

### 2.2.3.2 Class B (beacon)

อุปกรณ์ของ Class B เป็นอุปกรณ์ที่ต้องมีการรับส่งข้อมูลเป็นเวลาจะขยายเพิ่มเติมจาก Class A ตรงจะมีหน้าต่างรับข้อมูลที่ถูกก้าหนดไว้แล้วเพิ่มขึ นมาจาก Class A เพื่อรับข้อความจากเซิร์ฟเวอร์มี รูปแบบการส่งแบบ beacons ซึ่งให้จังหวะเวลาทั งสองทางที่ติดต่อกันจากเกตเวย์และตัวอุปกรณ์จะท้าการ เปิดหน้าต่างรับข้อมูลเป็นระยะ

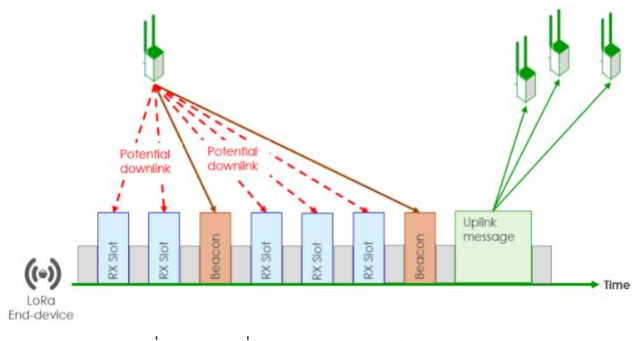
[picture p9: figure]

รูปที่ 2.7 การสื่อสารของอุปกรณ์ลอร่า Class B ที่มา: Lennart Nordin (2562)

### 2.2.3.3 Class C (continuous)

อุปกรณ์ Class C เป็นอุปกรณ์ที่ต้องมีการรับส่งข้อมูลแบบเวลาจริง จะเพิ่มเติมจาก Class A ตรงที่หน้าต่างรับข้อมูล จะเปิดค้างไว้จนกว่าตัว อุปกรณ์จะท้าการส่งข้อมูลอีกครั ง ซึ่งช่วยท้าให้การสื่อสารมี ความหน่วงต่้า แต่จะใช้พลังงานมากกว่าอุปกรณ์ Class A โดยการสื่อสารของอุปกรณ์ลอร่าท้างานใน Class C เนื่องจากอุปกรณ์ Class C เป็นอุปกรณ์ที่ต้องมีการรับส่งข้อมูลแบบเวลาจริง จะเพิ่มเติมจาก Class A ตรงที่ หน้าต่างรับ จะเปิดค้างไว้จนกว่าตัว อุปกรณ์จะท้าการส่งข้อมูลอีกครั ง ซึ่งช่วยท้าให้การสื่อสารมีความหน่วงต่้า แต่จะใช้พลังงานมากกว่า อุปกรณ์Class A โดยมีความสัมพันธ์กันกับ QOS คือ การจัดการบริหารแบนด์วิธ หรือช่องทางของระบบเครือข่าย ระบบ QOS มีวัตถุประสงค์ส้าหรับการจัดสรรเส้นทางแบนด์วิธในระบบ เครือข่ายที่มีอยู่อย่างจ้ากัด การตั งค่า QOS จึงได้เข้ามามีบทบาทในเรื่องของการลดความเร็วของผู้ที่ใช้งาน หรือ จะปิดกั นการใช้งานในช่องทางที่ถูกก้าหนดไว้โดยในการตั งค่าระบบ QoS จะสามารถก้าหนดช่วงของไอพี ของเครื่องคอมพิวเตอร์ที่มีการจ้ากัดตัว QoS โดยจะมีการตั งค่าความเร็วในการดาวน์โหลด และอัพโหลดข้อมูล (Micro4you, (http://www.micro4you.com/) 2560)

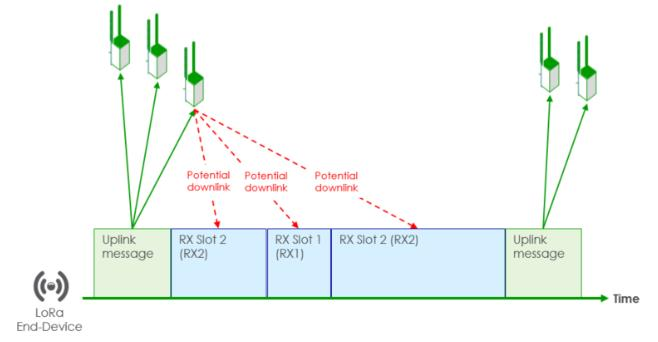
[picture p10: figure]

รูปที่ 2.8 การสื่อสารของอุปกรณ์ลอร่า Class C ที่มา: Lennart Nordin (2562)

### 2.2.4 ค่าความไวในการรับสัญญาณ

ค่าความไวในการรับสัญญาณ หรือ RSSI ยอมาจาก Receive Signal Strength Indicator เป็นคาที่ ใชบอกความแรงของสัญญาณวิทยุที่ได้รับในเทอมของพลังงาน โดยคา RSSI จะแปรผันกับความแรงของ สัญญาณ นั่นคือถ้าค่า RSSI มีค่ามากแสดงว่าสัญญาณที่ได้รับมีความแรงสูง นั่นคือตัวสง และตัวรับอยู่ใกลกัน และในทางกลับกันหากคา RSSI มีค่าน้อยแสดงวาสัญญาณที่ได้รับ มีความแรงต่้า ตัวส่งและตัวรับอยู่ไกลกัน (วารสารวิทยาศาสตร์ประยุกต์, 2558) โดยที่ระดับความแรงของสัญญาณวิทยุจะมีหน่วยที่ใช้กันส่วนใหญ่คือ dBm แต่ใช้งานอ้างอิงกันที่ระดับ มิลลิวัตต์ตัวอย่างเช่น 0 dBm จะมีค่าเท่ากับ 1 มิลลิวัตต์ซึ่งค้านวณได้จาก สูตรดังสมการที่ 2.1 และ 2.2 (Krok, 2561)

=

P
x 10log10
1mW

(2.1)

= •

x
10 P 1mW 10
(2.2)

โดยที่ x คือระดับ RSSI มีหน่วยเป็น dBm และ P คือก้าลัง มีหน่วยเป็นวัตต์

### 2.2.5 ข้อดีของเทคโนโลยีลอร่า

ข้อดีของเทคโนโลยีลอร่า โดยทั่วไปแล้วแอพพลิเคชันไอโอทีประกอบด้วย ต้นทุนโหนด ต้นทุนของ เครือข่าย ระยะเวลาการใช้งานแบตเตอร์รี่อัตราการรับส่งข้อมูล เวลาแฝง การเคลื่อนที่ได้ง่าย ระยะทางในการ สื่อสาร การครอบคลุม และรูปแบบการน้าไปใช้งาน ยังไม่มีเทคโนโลยีอันไหนที่จะสามารถแก้ปัญหาตัวประกอบ ทั งหมดตามที่กล่าวมาได้ในเวลาเดียวกัน ทั งนี เทคโนโลยีลอร่ามีคุณสมบัติด้านเทคนิคและด้านธุรกิจที่ต่างกัน ที่ จะให้บริการเช่นเดียวกับ Wi-Fi กับบลูทูธ ลอร่าใช้ความถี่ที่ไม่ต้องมีใบอนุญาตที่ย่านความถี่ต่้ากว่า 1 GHz และ ในประเทศไทยใช้ย่านความถี่ 920-925 MHz ในขณะที่ NB-IoT และการสื่อสารเซลลูล่าร์ใช้ย่านความถี่ที่ต้องมี ใบอนุญาต ในย่านความถี่ที่ต่้ากว่า 1 GHz เพราะฉะนั นในแถบความถี่ที่ต่้ากว่า 1 GHz ระหว่าง 500 MHz ถึง 1 GHz เหมาะสมส้าหรับการสื่อสารระยะไกล และมีประสิทธิภาพด้านเทคนิคสายอากาศ และ LoRa-Wan ใช้ สเปคตรัมแบบที่ไม่ต้องขออนุญาตและใช้โปรโตคอลเป็นแบบอะซิงโครนัส ซึ่งเหมาะสมที่สุดในด้านระยะเวลา การใช้งานแบตเตอร์รี่ และด้านต้นทุน โปรโตคอลของลอร่าและ LoRa-Wan ถูกออกแบบให้รองรับการใช้งานที่ มีการซ้อนทับของคลื่น การทับซ้อนของเครือข่าย และมีความสามารถในการเพิ่มลดได้ในปริมาณที่สูงมาก ซึ่ง จากการที่มี QoS และมีต้นทุน สเปคตรัมที่สูง แอพพลิเคชันที่มีค่าสูงที่ต้องการรับประกันในเรื่อง QoS จึง เหมาะกับเซลลูลาร์ในขณะที่หากต้องการต้นทุนต่้าจะเหมาะกับลอร่า (อดิศร ขาวสังข์, 2559)

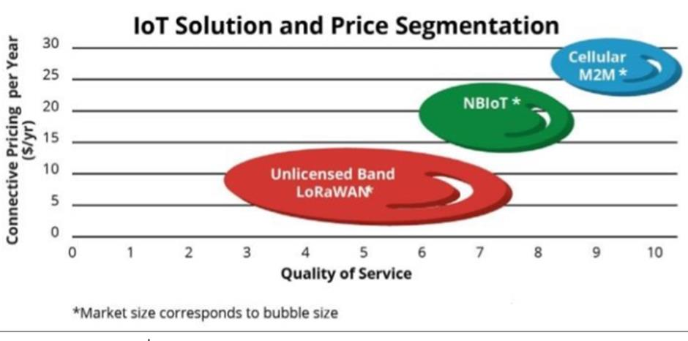
[picture p11: figure]

รูปที่ 2.9 IoT Pricing Vs. Quality of Service (QoS) ที่มา: อดิศร ขาวสังข์(2559)

สองลักษณะที่ส้าคัญในการพิจารณาเรื่องของระยะเวลาการใช้งานแบตเตอร์รี่คือ การใช้กระแสของ end-device และการช่วยเหลือของโปรโตคอลโดยลอร่าแวน เป็นอะซิงโครนัสที่ใช้โปรโตคอล ALOHA-based ซึ่งมีวิธีการที่ end-device สามารถพักในระยะเวลาสั นหรือยาวได้ตามความต้องการ ในขณะที่ระบบที่เป็น อะซิงโครนัสที่ใช้โปรโตคอล cellular-based เป็นอุปกรณ์ end-device จะต้องมีการซิงโครนัสกับเครือข่ายทุก ช่วงเวลา ซึ่งโทรศัพท์มือถือปัจจุบันนี เฉลี่ยแล้วจะมีการซิงโครนัสกับเครือข่ายทุกๆ 1.5 วินาที การซิงโครนัสของ ระบบ NB-IoT เกิดขึ นไม่บ่อยนักแต่ก็มีเป็นประจ้า ท้าให้ยังต้องใช้พลังงานจากแบตเตอรี่อยู่ ในส่วนของการ มอดูเลชั่นที่ระบบเซลลูลาร์ใช้นั น มีประสิทธิภาพที่สุดต่อการใช้สเปคตรัม แต่ไม่มีประสิทธิภาพในมุมมองจาก end-device โดยการมอดูเลชันในระบบเซลลูลาร์ที่เป็น OFDM หรือ FDMA ต้องการเครื่องส่งแบบ linear ใน การสร้างมอดูเลชัน ซึ่งเครื่องส่งแบบ linear ต้องการขนาดของกระแสสูงสุดมากกว่าการมอดูเลชันแบบ non-linear ที่ LoRa ใช้กระแสสูงสุดดังกล่าวนี ไหลออกจากแบตเตอรี่เร็วกว่าและต้องสิ นเปลืองแบบเตอรี่ที่ ต้องมาสนับสนุน ดังนั นแอปพลิเคชันที่ต้องการในเรื่องของระยะเวลาการใช้งานแบตเตอร์รี่ ลอร่าถือเป็น ทางเลือกที่ดีกว่า (อดิศร ขาวสังข์, 2559)
โดยรวมแล้วลอร่าเป็นมาตรฐานการสื่อสารสารแบบไร้สายแบบหนึ่ง โดยการสื่อสารแบบ LoRa-Wan สามารถที่จะท้าให้อุปกรณ์ในระบบของ NB-IoT สามารถที่จะสื่อสารกันได้ด้วยระยะทางไกลและใช้พลังงาน ไฟฟ้าน้อย และมีคุณสมบัติพื นฐานดังนี (kaebmoo, 2561)
1) ใช้ได้ระยะทางไกล (> 5 กิโลเมตร, > 10 กิโลเมตร, > 80 กิโลเมตร)
2) ประหยัดพลังงาน (แบตเตอรี่ อาจใช้ได้มากถึง 1 ปีหรือมากกว่า)
3) ราคาไม่สูง
4) อัตราการส่งข้อมูลต่้า (< 50 กิโลบิตต่อวินาที)
5) ใช้ย่านความถี่ ที่ไม่ต้องขออนุญาต
6) ส่งและรับข้อมูลได้

ข้อเสียของเทคโนโลยีลอร่า
1) ไม่เหมาะส้าหรับความต้องการส่งข้อมูลจ้านวนมาก
2) มีการส่งข้อมูลบ่อย ๆ
3) เชื่อมต่อกับเครือข่ายสื่อสารจ้านวนมาก

### 2.2.6 รูปแบบการใช้งานเทคโนโลยีลอร่า

การสื่อสารแบบเครือข่ายลอร่าจะใช้ LoRa-Wan เป็นโปรโตคอลที่มีข้อก้าหนดด้านเครือข่ายพลังงาน ต่้าที่ได้จากเทคโนโลยีลอร่าที่ได้รับการรับรองโดย LoRa Alliance แต่หากส้าหรับการสื่อสารแบบระหว่างจุด ของเทคโนโลยีลอร่านั นดังแสดงในรูปที่ 2.9 จะสามารถส่งข้อมูลได้ไกลกว่า Wi-Fi หรือ บลูทูธ การส่งข้อมูลผ่าน Wi-Fi โดยทั่วไปได้ระยะประมาณ 100-200 เมตร ในขณะที่ลอร่าสามารถส่งข้อมูลได้มากกว่า 30 กิโลเมตร ดัง แสดงในรูปที่ 2.10

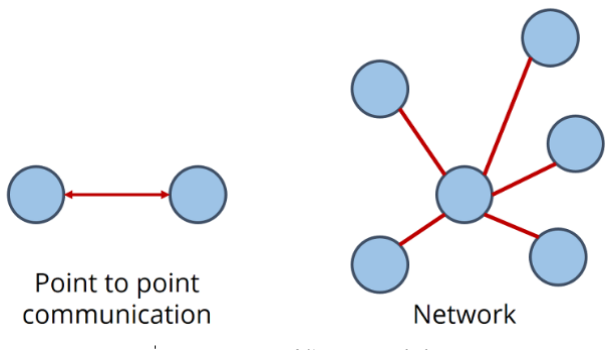
[picture p12: figure]

รูปที่ 2.10 รูปแบบการใช้งานของเทคโนโลยีลอร่า ที่มา: Arduinoall (2562)

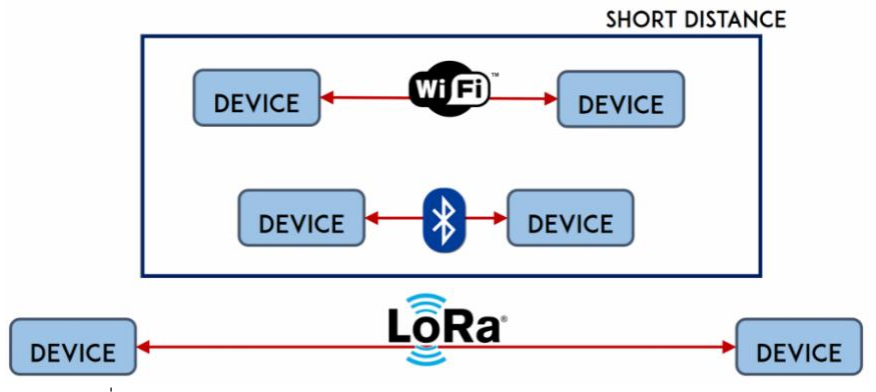
[picture p13: figure]

รูปที่ 2.11 เปรียบเทียบการส่งข้อมูลของ WiFi บลูทูธ และลอร่า แบบระหว่างจุด ที่มา: Arduinoall (2562)

### 2.3 เทคโนโลยีการระบุต้าแหน่ง

เทคโนโลยีการระบุต้าแหน่ง หรือ GPS คือระบบระบุต้าแหน่งบนพื นโลก ย่อมาจากค้าว่า Global Positioning System ซึ่งระบบ GPS ประกอบไปด้วย 3 ส่วนหลัก คือ
1) ส่วนอวกาศ ประกอบด้วยเครือข่ายดาวเทียมหลัก 3 ค่าย คือ อเมริกา รัสเซีย ยุโรป
2) ส่วนควบคุม ประกอบด้วยสถานีภาคพื นดิน สถานีใหญ่อยู่ที่ Falcon Air Force Base ประเทศ อเมริกา และศูนย์ควบคุมย่อยอีก 5 จุด กระจายไปยังภูมิภาคต่าง ๆ ทั่วโลก
3) ส่วนผู้ใช้งาน ส่วนผู้ใช้งาน ผู้ใช้งานต้องมีเครื่องรับสัญญาณที่สามารถรับคลื่นและแปรรหัสจาก ดาวเทียมเพื่อน้ามาประมวลผลให้เหมาะสมกับการใช้งานในรูปแบบต่าง ๆ (Global5 Co., Ltd., 2561)

### 2.3.1 การท้างานของ GPS

ดาวเทียม GPS ประกอบด้วยดาวเทียม 24 ดวง โดยแบ่งเป็น 6 รอบวงโคจร การจรจะเอียงท้ามุม เอียง 55 องศากับเส้นศูนย์สูตร ในลักษณะสานกันคล้าย ลูกตะกร้อแต่ละวงโคจรมีดาวเทียม 4 ดวง รัศมี วงโคจรจากพื นโลก 20,162.81 กิโลเมตร หรือ 12,600 ไมล์ ดาวเทียมแต่ละดวงใช้ เวลาในการโคจรรอบโลก 12 ชั่วโมง GPS ท้างานโดยการรับสัญญาณจากดาวเทียมแต่ละดวง โดยสัญญาณดาวเทียมนี ประกอบไปด้วย ข้อมูลที่ระบุต้าแหน่งและเวลาขณะส่งสัญญาณ ตัวเครื่องรับสัญญาณ GPS จะต้องประมวลผลความแตกต่าง ของเวลาในการรับสัญญาณเทียบกับเวลาจริง ณ ปัจจุบันเพื่อแปรเป็นระยะทางระหว่างเครื่องรับสัญญาณกับ ดาวเทียมแต่ละดวง ซึ่งได้ระบุมีต้าแหน่งของมันมากับสัญญาณดังกล่าวข้างต้น เพื่อให้เกิดความแม่นย้าในการ ค้นหาต้าแหน่งด้วยดาวเทียม ต้องมีดาวเทียมอย่างน้อย 4 ดวง เพื่อบอกต้าแหน่งบนผิวโลก ซึ่งระยะห่างจาก ดาวเทียมทั ง 3 กับเครื่อง GPS (ที่จุดสีแดง) จะสามารถระบุต้าแหน่งบนผิวโลกได้ หากพื นโลกอยู่ในแนวระนาบ แต่ในความเป็นจริงพื นโลกมีความโค้งเนื่องจากสัณฐานของโลกมีลักษณะกลม ดังนั นดาวเทียมดวงที่ 4 จะท้าให้ สามารถค้านวณเรื่องความสูงเพื่อท้าให้ได้ต้าแหน่งที่ถูกต้องมากขึ น นอกจากนี ความแม่นย้าของการระบุ ต้าแหน่งนั นขึ นอยู่กับต้าแหน่งของดาวเทียมแต่ละดวง กล่าวคือถ้าระยะห่างระหว่างดาวเทียมที่ใช้งานอยู่ห่าง กันย่อมให้ค่าที่แม่นย้ากว่าที่อยู่ใกล้กัน และยิ่งมีจ้านวนดาวเทียมที่รับสัญญาณได้มากก็ยิ่งให้ความแม่นย้ามาก ขึ น ความแปรปรวนของชั นบรรยากาศชั นบรรยากาศประกอบด้วยประจุไฟฟ้า ความชื น อุณหภูมิ และความ หนาแน่นที่แปรปรวนตลอดเวลา เมื่อคลื่นตกกระทบกับวัตถุต่าง ๆ จะเกิดการหักเหท้าให้สัญญาณที่ได้อ่อนลง และสิ่งแวดล้อมในบริเวณรับสัญญาณ จะมีผลต่อค่าความถูกต้องของความแม่นย้า เนื่องจากถ้าสัญญาณจาก ดาวเทียมมีการหักเหก็จะท้าให้ค่าที่ค้านวณได้จากเครื่องรับสัญญาณเพี ยนไป สุดท้ายก็คือประสิทธิภาพของ เครื่องรับสัญญาณว่ามีความไวในการรับสัญญาณแค่ไหน และความเร็วในการประมวลผลด้วย องค์ประกอบ สุดท้ายก็คือต้าแหน่งของดาวเทียมแต่ละดวงในขณะที่ส่งสัญญาณมาว่าอยู่ที่ใด มายังเครื่องรับ GPS โดยวงโคจร ของดาวเทียมได้ถูกก้าหนดไว้ล่วงหน้าแล้วเมื่อถูกส่งขึ นสู่อวกาศ สถานีควบคุมจะคอยตรวจสอบการโคจรของ ดาวเทียมอยู่ตลอดเวลาเพื่อทวนสอบความถูกต้อง (Global5 Co., Ltd., 2561)

### 2.4 พื นฐาน ESP32

ESP32 เป็นชื่อของไอซีไมโครคอนโทรลเลอร์ที่รองรับการเชื่อมต่อ WiFi และ บลูทูธ 4.2 BLE ในตัว ผลิตโดยบริษัท Espressif จากประเทศจีน โดยตัวไอซีESP32 มีสเปคโดยละเอียด ดังนี (IOXhop, 2561)
1) ซีพียูใช้สถาปัตยกรรม Tensilica LX6 แบบ 2 แกนสมอง สัญญาณนาฬิกา 240 MHz มีแรม ในตัว 512 KB
2) รองรับการเชื่อมต่อรอมภายนอกสูงสุด 16 MB
3) มี WiFi มาตรฐาน 802.11 b/g/n รองรับการใช้งานทั งในโหมด Station softAP และ Wi-Fi direct
4) มีบลูทูธในตัว รองรับการใช้งานในโหมด 2.0 และโหมด 4.0 BLE
5) ใช้แรงดันไฟฟ้าในการท้างาน 2.6 โวลต์ถึง 3 โวลต์
6) ท้างานได้ที่อุณหภูมิ -40 องเซลเซียส ถึง 125 องเซลเซียส นอกจากนี ESP32 ยังมีเซนเซอร์ต่าง ๆ ดังนี
1) วงจรกรองสัญญาณรบกวนในวงจรขยายสัญญาณ
2) เซนเซอร์แม่เหล็ก
3) เซนเซอร์สัมผัส (Capacitive touch) รองรับ 10 ช่อง
4) รองรับการเชื่อมต่อคลิสตอล 32.768 kHz ส้าหรับใช้กับส่วนวงจรนับเวลาโดยเฉพาะ
5) ขาใช้งานต่าง ๆ ของ ESP32 โดยมีGPIO จ้านวน 32 ช่อง รองรับการเชื่อมต่อบัสต่าง ๆ ดังนี
- รองรับ UART จ้านวน 3 ช่อง
- รองรับ SPI จ้านวน 3 ช่อง
- รองรับ I2C จ้านวน 2 ช่อง
- รองรับ ADC จ้านวน 12 ช่อง
- รองรับ DAC จ้านวน 2 ช่อง
- รองรับ I2S จ้านวน 2 ช่อง
- รองรับ PWM / Timer ทุกช่อง
- รองรับการเชื่อมต่อกับ SD-Card
นอกจากนี ESP32 ยังรองรับฟังก์ชันเกี่ยวกับความปลอดภัยต่าง ๆ ดังนี
1) รองรับการเข้ารหัส WiFi แบบ WEP และ WPA/WPA2 PSK/Enterprise
2) มีวงจรเข้ารหัส AES/SHA2/Elliptical Curve Cryptograph/RSA-4096 ในด้านประสิทธิ์ภาพการใช้งาน ตัว ESP32 สามารถท้างานได้ดีโดย
1) รับ – ส่ง ข้อมูลได้ความเร็วสูงสุดที่ 150 Mbps เมื่อเชื่อมต่อแบบ 11n HT40 ได้ความเร็วสูงสุด 72 Mbps เมื่อเชื่อมต่อแบบ 11n HT20 ได้ความเร็วสูงสุดที่ 54 Mbps เมื่อเชื่อมต่อแบบ 11g และได้ความเร็วสูงสุดที่ 11Mbps เมื่อเชื่อมต่อแบบ 11b
2) เมื่อใช้การเชื่อมต่อผ่านโปรโตคอล UDP จะสามารถรับ – ส่งข้อมูลได้ที่ความเร็ว 135 Mbps

3) ในโหมด Sleep ใช้กระแสไฟฟ้าเพียง 2.5 uA

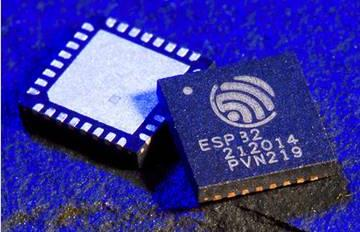
[picture p14: figure]

รูปที่ 2.12 ชิปไอซี ESP32 ในรูปตัวถัง QFN-32 ที่มา: IOXhop (2561)

### 2.4.1 บอร์ดพัฒนา ESP32 จากค่าย TTGO 2.4.1.1 TTGO V8

TTGO V8 มีจุดเด่น คืออ่าน SD Card ได้ ท้าให้สามารถจะอ่านเขียนไฟล์ใหญ่ๆ ได้มี เสาอากาศแบบ 3D มีวงจรชาร์จในตัว และต่อเสานอกได้

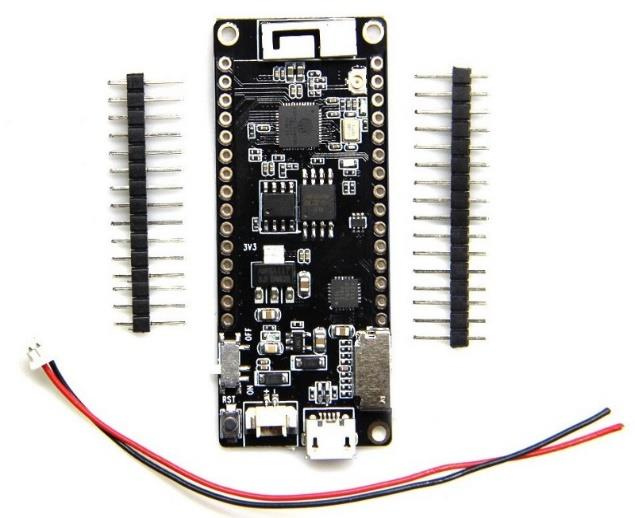
[picture p15: figure]

รูปที่ 2.13 บอร์ด TTGO V8
ที่มา: IOXhop (2561)

### 2.4.1.2 TTGO T-Beam

TTGO T-Beam มีคุณสมบัติ คือมี PSRAM เพิ่มมาให้อีก 4 MB มีเสาอากาศแบบ 3D มี ลอร่า มาให้ในตัว พร้อมเสา (มีให้เลือกความถี่ได้ 433, 868, 923 แต่ละบอร์ด) มี GPS มีเสาแบบเซรามิกแยก อีกตัวนึงและใส่ถ่าน 18650 ได้ข้างหลัง

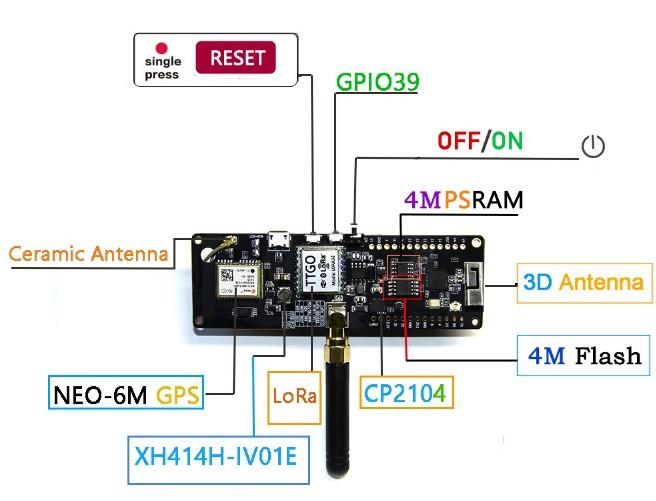
[picture p16: figure]

รูปที่ 2.14 บอร์ดTTGO T-Beam ที่มา: IOXhop (2561)

### 2.4.1.3 TTGO WiFi

TTGO WiFi มีคุณสมบัติพิเศษ คือมี PSRAM เพิ่มมาให้อีก 4 MB มีเสาอากาศแบบ 3D ต่อ SD Card ได้มีปุ่มให้ใช้งาน มี OLED ในตัว และมีถ่าน 18650 ด้านหลัง

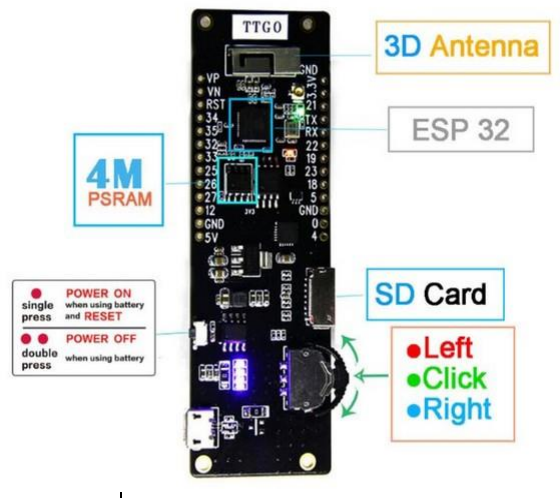
[picture p17: figure]

รูปที่ 2.15 บอร์ด TTGO WiFi ที่มา: IOXhop (2561)

### 2.4.2 การเลือกใช้ชุดซอฟแวร์พัฒนา

การเลือกใช้ แนะน้าให้เลือกใช้ชุดพัฒนา Arduino core ส้าหรับ ESP32 WiFi chip จะดีกว่า เนื่องจากการเขียนโปรแกรมแบบ Arduino มีฟังก์ชันการใช้งานต่าง ๆ ที่ค่อนข้างง่าย และมีเว็บ arduino.cc เป็นเว็บรวมตัวอย่างโค้ดต่าง ๆ และเอกสารการใช้งานแต่ละฟังก์ชันอยู่มาก รวมทั งเว็บไซต์ส่วน

ใหญ่ที่รวมวิธีการประยุกต์ใช้ESP32 ยังนิยมใช้โค้ดโปรแกรมส้าหรับชุดพัฒนา Arduino core ส้าหรับ ESP32 WiFi chip อีกด้วย (IOXhop, 2561)

### 2.5 ฐานข้อมูล

ฐานข้อมูล คือ กลุ่มของข้อมูลที่ถูกเก็บรวบรวมไว้ โดยมีความสัมพันธ์ซึ่งกันและกัน โดยไม่ได้บังคับว่า ข้อมูลทั งหมดนี จะต้องเก็บไว้ในแฟ้มข้อมูลเดียวกันหรือแยกเก็บหลาย ๆ แฟ้มข้อมูล ระบบฐานข้อมูล คือ ระบบ ที่รวบรวมข้อมูลต่าง ๆ ที่เกี่ยวข้องกันเข้าไว้ด้วยกันอย่างมีระบบมีความสัมพันธ์ระหว่างข้อมูลต่าง ๆ ที่ชัดเจน ในระบบฐานข้อมูลจะประกอบด้วยแฟ้มข้อมูลหลายแฟ้มที่มีข้อมูล เกี่ยวข้องสัมพันธ์กันเข้าไว้ด้วยกันอย่างเป็น ระบบและเปิดโอกาสให้ผู้ใช้สามารถใช้งานและดูแลรักษาป้องกันข้อมูลเหล่านี ได้อย่างมีประสิทธิภาพ โดยมี ซอฟต์แวร์ที่เปรียบเสมือนสื่อกลางระหว่างผู้ใช้และโปรแกรมต่าง ๆ ที่เกี่ยวข้องกับการใช้ฐานข้อมูล เรียกว่า ระบบจัดการฐานข้อมูล หรือ DBMS (Data Base Management System) มีหน้าที่ช่วยให้ผู้ใช้เข้าถึงข้อมูลได้ ง่ายสะดวกและมีประสิทธิภาพ การเข้าถึงข้อมูลของผู้ใช้อาจเป็นการสร้างฐานข้อมูล การแก้ไขฐานข้อมูล หรือ การตั งค้าถามเพื่อให้ได้ข้อมูลมา โดยผู้ใช้ไม่จ้าเป็นต้องรับรู้เกี่ยวกับรายละเอียดภายในโครงสร้างของฐานข้อมูล (วรินดา นวนกัน, 2561)

### 2.5.1 พื นฐาน Google Firebase

Firebase คือ บริการ backend และแพลตฟอร์ม ครบวงจร Firebase เป็นฐานข้อมูลเวลาจริงซึ่งมี API ที่ช่วยให้นักพัฒนาในการจัดเก็บ และซิงค์ข้อมูล โดย Google Firebase 2.0 มีการพัฒนาให้สามารถ จาก บริการ backend เก็บข้อมูลอย่างเดียว มาเป็น แพลตฟอร์ม ครบวงจรส้าหรับนักพัฒนา รองรับบริการแทบทุก อย่างที่ต้องการใช้งาน

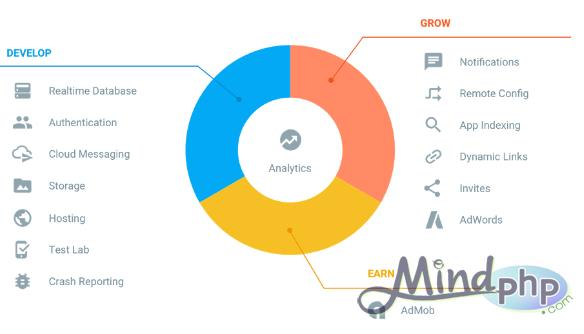
[picture p18: figure]

รูปที่ 2.16 การพัฒนามาเป็น Google Firebase 2.0 ที่มา: Firebase คืออะไร (2560)

### 2.5.2 การให้บริการ

1) Firebase Analytics บริการวิเคราะห์ข้อมูล ดึงเทคโนโลยีมาจาก Google Analytics แถมยัง เปิดให้ใช้ฟรีแบบไม่จ้ากัดปริมาณข้อมูลใด ๆ
2) ระบบส่งข้อความแจ้งเตือน Google Cloud Messaging (GCM) เปลี่ยนชื่อมาเป็น Firebase Cloud Messaging (FCM) ใช้งานฟรีไม่จ้ากัดปริมาณข้อความ ตอนนี FCM ให้บริการข้อความ แจ้งเตือน 1.7 แสนล้านข้อความต่อวัน
3) Firebase Storage บริการพื นที่เก็บข้อมูล เอาไว้เก็บภาพ วิดีโอ หรือไฟล์ขนาดใหญ่จากแอพของ ผู้ใช้ สร้างอยู่บน Google Cloud Storage
4) Firebase Remote Config ตัวช่วยอัพเดตการแก้ไขของแอพ ส้าหรับปรับแต่งค่าต่าง ๆ ใน แอพจากระยะไกล เช่น เกมที่อยากปรับสมดุลของเกมตลอดเวลา สามารถใช้ร่วมกับ Firebase Analytics เพื่อก้าหนดผู้ใช้งานแยกเป็นกลุ่ม ๆ ได้
5) Firebase Crash Reporting ตัวรายงานการแครชของแอพ รองรับทั ง iOS และ Android บริการทดสอบแอพบนฮาร์ดแวร์จริง Cloud Test Lab เปลี่ยนชื่อมาเป็น Firebase Test Lab for Android
6) Firebase Notifications เป็นคอนโซลส้าหรับนักพัฒนา เพื่อยิงข้อความผ่าน FCM ไปยังผู้ใช้ ส้าหรับโปรโมทหรือกระตุ้นให้ผู้ใช้กลับมาใช้งาน
7) Firebase Dynamic Links บริการ URL กลางที่สามารถชี ทางไปยังเพจต่าง ๆ แปรผันตาม อุปกรณ์หรือคุณสมบัติของผู้ใช้
8) Firebase Invites ระบบเชิญเพื่อนมาใช้แอพ มีฟีเจอร์ referral คนชวนได้สิทธิประโยชน์
9) Firebase App Indexing เปลี่ยนชื่อมาจาก Google App Indexing ที่ช่วยให้ Google Search ค้นเจอเนื อหาภายในแอพ (Firebase, 2560)

### 2.6 เว็บเพจ

เว็บเพจ (Web page) หมายถึง เอกสารที่สร้างขึ นโดยในรูปแบบของ HTML หรือโปรแกรมการสร้าง เว็บโดยเฉพาะ จะแสดงผลได้เฉพาะโปรแกรมบราวเซอร์ และต้องติดตั งในเว็บเซอร์เวอร์เพื่อเข้าไปอ่านข้อมูลได้ โดยผ่านระบบอินเทอร์เน็ต เว็บเพจจะมี 2 ลักษณะใหญ่คือ
1) เว็บเพจแบบหน้าเดียว (Single page) หรือแบบสั น (Short page) หมายถึง เว็บเพจที่แสดงผล ข้อมูลหรือเนื อหาเพียงหน้าเดียวมีขนาดเท่ากับหน้าจอคอมพิวเตอร์พอดี หรือมีแถบเลื่อนลงมา ด้านล่างสั น ๆ หรือมีรูปแบบเป็นกรอบพอดีหน้าจอภาพ
2) เว็บเพจแบบแถบเลื่อน (Scroll page) หรือแบบยาว (Long page) หมายถึง เว็บเพจที่แสดงผล ข้อมูลหรือเนื อหาเป็นแนวยาวจากด้านบนลงมายังด้านล่างของหน้าจอภาพ โดยมีแถบเลื่อนอยู่ ด้านข้างส้าหรับเลื่อนหน้าจอภาพ เพื่อดูข้อมูลที่แสดงผลหน้าจอภาพ (จิรัฎฐ์ พงษ์ทองเมือง, 2552)

### 2.6.1 ภาษาที่ใช้ในการสร้างเว็บ 2.6.1.1 HTML (ย่อมาจาก Hyper Text Markup Language)

เป็นภาษาที่ใช้ส้าหรับสร้างเว็บเพจ มีโครงสร้างประกอบไปด้วย tag และ attribute ต่าง ๆ ที่ใช้ในการควบคุมการแสดงผลของข้อความ รูปภาพ หรือวัตถุอื่น ๆ ภาษา HTML นั นเป็นภาษาประเภท Markup ไม่จัดเป็นภาษาประเภท Programming สามารถที่จะเรียนรู้ได้ง่าย โดยโครงสร้างพื นฐานของ HTML จะประกอบไปด้วยส่วนของค้าสั่ง 2 ส่วน คือ ส่วนที่เป็น ส่วนหัว (Head) และส่วนที่เป็นเนื อหา (Body) โดยมี รูปแบบค้าสั่งดังแสดงในรูปที่ 2.17

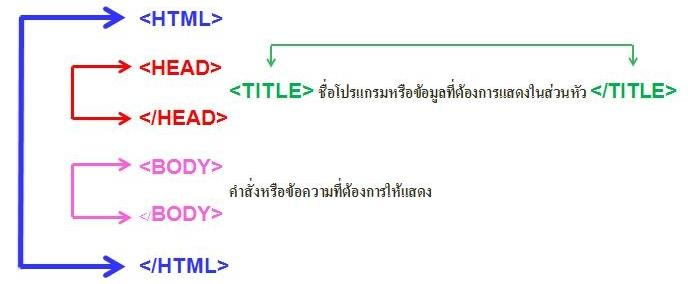
[picture p19: figure]

รูปที่ 2.17 โครงสร้างภาษา HTML ที่มา: อนงค์ หลอดแก้ว (2561)

การจัดโครงสร้างแฟ้มเอกสารในความง่ายของภาษา HTML นั นเพราะภาษานี ไม่มีโครงสร้าง ใด ๆ มาก้าหนดนอก จากโครงสร้างพื นฐานเท่านั น หรือ แม้แต่จะไม่มีโครงสร้าง พื นฐานอยู่ โปรแกรมที่เขียน ขึ นมานั นก็สามารถท้างานได้เสมือนมี โครงสร้างทั่งนี เป็นเพราะ ว่าตัวโปรแกรม เว็บเบราว์เซอร์จะมองเห็นทุก สิ่งทุกอย่างในโปรแกรม HTML เป็นส่วนเนื อหาทั งสิ น ยกเว้นใน ส่วนหัว ที่ต้อง มีการก้าหนด แยกออกไปให้ เห็นชัดเท่านั น จะเขียน ค้าสั่ง หรือ ข้อความที่ ต้องการ ให้แสดง อย่างไรก็ได้ เป็นเสมือนพิมพ์งานเอกสารทั่ว ๆ ไป เพียงแต่ท้าต้าแหน่งใดมีการท้าต้าแหน่งพิเศษขึ นมา เว็บเบราว์เซอร์ถึงจะแสดงผลออกมาตามที่ถูกก้าหนด โดยใช้ค้าสั่งให้ตรงกับ รหัสที่ก้าหนดเท่านั น หลังจากมีการพิมพ์โปรแกรมนี เสร็จเรียบร้อยแล้ว ให้บันทึกเป็น ไฟล์ที่มีนามสกุล .htm หรือ .html จากนั นให้เรียกโปรแกรมเว็บเบราว์เซอร์ขึ นมาท้าการทดสอบ ข้อมูลที่สร้าง จะถูก น้ามาที่ออกมาแสดงที่จอภาพ ถ้าไม่เขียนอะไรผิด บนจอภาพก็จะแสดงผลตามนั น ถ้ามีการปรับปรุง แก้ไขข้อมูลในโปรแกรมเดิม ให้อยู่ในรูปของ โปรแกรมใหม่ ก็จ้า เป็นต้องโหลดโปรแกรมขึ นมาใหม่ เพียงแต่ เลื่อนเมาส์ไปคลิกที่ปุ่ม Refresh โปรแกรมก็จะท้าการ ประมวลผลและแสดงผลออกมาใหม่ ในค้าสั่ง HTML ส่วนใหญ่ใช้ตัวเปิด เป็นเครื่องหมายน้อยกว่า ตามด้วยค้าสั่ง และปิดท้ายด้วยเครื่องหมายมากกว่า และมีตัวปิด ที่มีรูปแบบเหมือนตัวเปิดเสมอ เพียงแต่จะมีเครื่อง หมาย / อยู่หน้าค้าสั่งนั น ๆ เมื่อใดที่ผู้เขียนลืมหรือพิมพ์ ค้าสั่งผิด จะส่งผลให้การท้างานของโปรแกรมผิดพลาดทันที (klumtee10, 2562)

### 2.6.1.2 CSS (ย่อมาจาก Cascading Style Sheets)

เป็นภาษาที่มีรูปแบบการเขียน Syntax ที่เฉพาะ ถูกก้าหนดขึ นเพื่อใช้เสริมภาษา HTML ให้ สามารถจัดรูปแบบการแสดงผลให้กับเอกสาร HTML ได้สมบูรณ์แบบมากขึ น ประโยชน์ของ CSS มีดังนี
1) CSS ช่วยในการจัดรูปแบบการแสดงผล และการตกแต่งเอกสารเว็บเพจ ช่วยลดการใช้ HTML ให้เหลือเพียงส่วนเนื อหาท้าให้เข้าใจง่ายขึ น และการแก้ไขเอกสารท้าได้สะดวก รวดเร็ว
2) สามารถโหลดแฟ้ม HTMLได้เร็วขึ น เนื่องจากแฟ้มมีขนาดเล็กลงเพราะ attribute ที่ใช้ ก้าหนดรูปร่างหน้าตา ถูกแยกไปเก็บแยกต่างหากในแฟ้ม CSS
3) สามารถปรับปรุงหรือแก้ไขได้ง่าย เนื่องจากการก้าหนดรูปแบบการแสดงผล ควบคุม โดยค้าสั่ง style sheet ชุดเดียวกัน การแก้ไขท้าที่แฟ้ม CSS เพียงแฟ้มเดียว แต่จะมีผล กับเอกสาร HTML ทุกหน้า โดยไม่ต้องตามแก้ที่แท็ก HTML ทั งเว็บไซต์
4) สามารถควบคุมการแสดงผลในเว็บเบราว์เซอร์ของทุก ๆ ค่าย ให้มีลักษณะเหมือน หรือ ใกล้เคียงกันได้
5) สามารถก้าหนดรูปแบบการแสดงผลให้เหมาะกับอุปกรณ์ทุกชนิด ไม่ว่าจะเป็นการ แสดงผลบนหน้าจอคอมพิวเตอร์ บนมือถือ หรือบน PDA
6) ท้าให้เว็บไซต์มีมาตรฐาน สามารถท้างานร่วมกับเว็บเบราว์เซอร์บนอุปกรณ์ต่าง ๆ ใน อนาคตได้(Enjoyday. (http://www.enjoyday.net/) 2550)

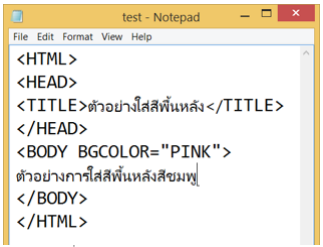
[picture p20: figure]

รูปที่ 2.18 ตัวอย่างการใช้ CSS ตกแต่งเอกสารเว็บเพจ ที่มา: Adul (2561)

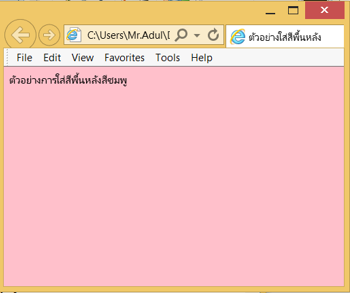
[picture p21: figure]

รูปที่ 2.19 การแสดงผลบนเอกสารเว็บเพจ ที่มา: Adul (2561)

### 2.6.1.3 JavaScript

JavaScript เป็นภาษายุคใหม่ส้าหรับการเขียนโปรแกรมบนระบบอินเทอร์เน็ตที่ก้าลังได้รับ ความนิยมอย่างสูง สามารถเขียน โปรแกรม JavaScript เพิ่มเข้าปในเว็ปเพจเพื่อใช้ประโยชน์ส้าหรับงานด้าน ต่าง ๆ ทั งการค้านวณ การแสดงผล การรับส่งข้อมูล และที่ส้าคัญคือ สามารถโต้ตอบกับผู้ใช้ได้อย่างทันทีทันใด นอกจากนี ยังมีความสามารถด้านอื่น ๆ อีกหลายประการที่ช่วยสร้างความน่าสนใจให้ กับเว็บเพจของได้ดี JavaScript เป็นภาษาสคริปต์เชิงวัตถุ หรือเรียกว่า อ็อบเจ็กโอเรียลเต็ด (Object Oriented Programming) ที่มีเป้าหมายในการ ออกแบบและพัฒนาโปรแกรมในระบบอินเทอร์เน็ต ส้าหรับผู้เขียนเอาสาร ด้วยภาษา HTML สามารถท้างานข้ามแพลตฟอร์มได้ท้างานร่วมกับ ภาษา HTML และภาษาจาวาได้ทั งทางฝั่ง ไคลเอนต์ (Client) และ ทางฝั่งเซิร์ฟเวอร์ (Server) โดยมีลักษณะการท้างานดังนี
1) Navigator JavaScript เป็น Client-Side JavaScript ซึ่งหมายถึง JavaScript ที่ถูกแปลทางฝั่ง ไคลเอนต์ (หมายถึงฝั่งเครื่อง คอมพิวเตอร์ของผู้ใช้ ไม่ว่าจะเป็นเครื่องพีซี เครื่องแมคอินทอช หรือ อื่น ๆ จึงมีความเหมาะสมต่อการใช้งานของผู้ใช้ทั่วไปเป็นส่วนใหญ่
2) LiveWire JavaScript เป็น Server-Side JavaScript ซึ่งหมายถึง JavaScript ที่ถูกแปลทางฝั่ง เซิร์ฟเวอร์ (หมายถึงฝั่งเครื่องคอมพิวเตอร์ของผู้ให้บริการเว็บเพจ) สามารถใช้ได้เฉพาะกับ LIveWire ของเน็ตสเคป (เป็นเว็บเบราว์เซอร์ของค่าย AOL) โดยตรง

การเขียน JavaScript อาจเขียนรวมอยู่ในไฟล์เดียวกันกับ HTML ได้ ซึ่งแตกต่างจากการเขียน โปรแกรมภาษา Java ที่ต้อง เขียนแยกออกเป็นไฟล์ต่างหาก ไม่สามารถเขียนรวมอยู่ในไฟล์เดียวกับ HTML ได้ วิธีการเขียน JavaScript เพื่อสั่งให้เว็ปเพจท้างาน มีอยู่ด้วยกัน 2 วิธี ดังนี เขียนด้วยชุดค้าสั่งและฟังก์ชันของ JavaScript เอง หรือเขียนตามเหตุการณ์ที่เกิดขึ นตามการใช้งานจากชุดค้าสั่งของ HTML เมื่อเริ่มใช้งาน โปรแกรมบราวเซอร์ จะอ่านข้อมูลจากส่วนบนของเพจ HTML และท้างานไปตามล้าดับจาก บนลงล่าง โดยเริ่มที่ส่วน < HEAD >...< /HEAD > ก่อนจากนั นจึงท้างานในส่วน < BODY >...< /BODY > เป็นล้าดับ ต่อมา การท้างานของ JavaScript ดูไม่แตกต่างไปจาก HTML เท่าใดนัก แต่ HTML จะวางเลย์เอาต์โครงสร้าง ของอ็อบเจ็กต์ภายใน และส่วนเชื่อมโยงกับเว็บเพจเท่านั น ในขณะที่ JavaScript สามารถเพิ่มเติมส่วนของการ เขียนโปรแกรมและลอจิกเข้าไป (สุนทร นิศากร, 2562)

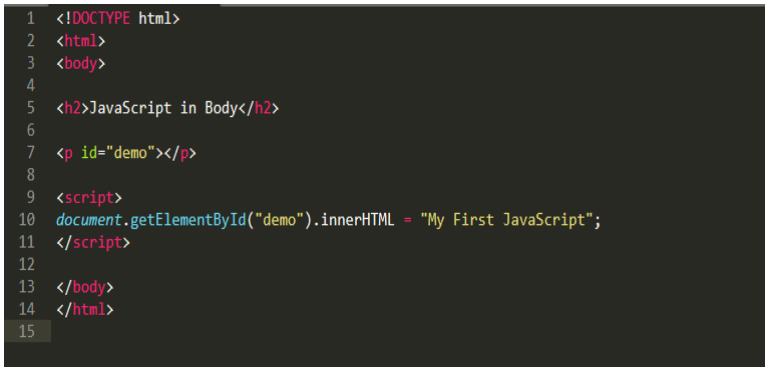
[picture p22: figure]

รูปที่ 2.20 การใช้งาน JavaScript

### 2.7 XAMPP

XAMPP คือโปรแกรมส้าหรับจ้าลองเครื่องคอมพิวเตอร์ ให้ท้างานในลักษณะของเว็บเซิร์ฟเวอร์นั่นคือ เครื่องคอมพิวเตอร์จะสามารถเปิดตัวเองให้เป็นอินทอร์เน็ตในการเปิดเว็บไซต์ที่ถูกจัดท้าขึ นมาในเครื่อง คอมพิวเตอร์นี โดยที่ไม่ต้องเชื่อมต่อกับอินเทอร์เน็ตภายนอก ก็สามารถทดสอบเว็บไซต์ที่สร้างขึ น ได้ ซึ่ง ปัจจุบันได้รับความนิยมจากผู้ใช้ CMS ในการสร้างเว็บไซต์โดย XAMPP ประกอบด้วย Apache, PHP, MySQL, PHP MyAdmin, Perl ซึ่งเป็นโปรแกรมพื นฐานที่รองรับการท้างาน การท้าเว็บไซต์ไม่ว่าจะในรูปแบบ ที่เป็น HTML ธรรมดา หรือแบบที่เป็น Database รวมถึงการเลือกใช้ CMS (Content Management System) เป็นระบบที่น้ามาช่วยในการสร้างและบริหารเว็บไซต์แบบส้าเร็จรูป ซึ่งเป็นชุดโปรแกรม ส้าหรับ ออกแบบเว็บไซต์ที่ได้รับความนิยม เช่น Joomla, WordPress เป็นต้น และ XAMPP ยังเป็นโปรแกรมที่ต้อง เรียกใช้งาน ซึ่งจะมี Control Panel ในการเรียกใช้งาน หลังจากเปิดใช้งานแล้ว คอมพิวเตอร์ถึงจะสามารถ

เรียกหน้าเว็บไซต์ที่สร้างขึ นผ่าน URL ที่ขึ นต้นด้วย localhost หรือ ที่เป็น IP ก็คือ 127.0.0.1 (ณัฐพงศ์ สุวรรณ รัตน์, 2560)

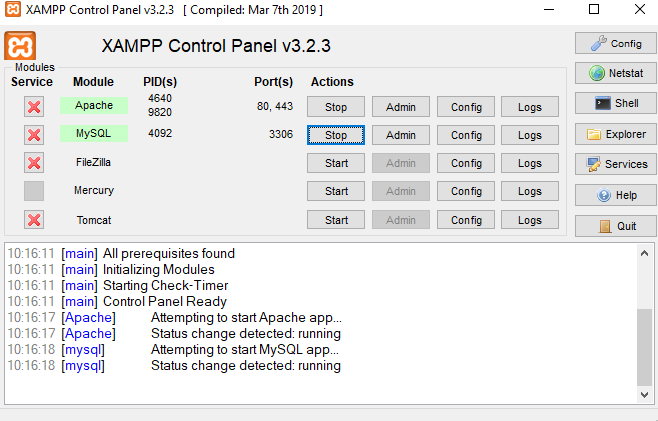
[picture p23: figure]

รูปที่ 2.21 โปรแกรม XAMPP

### 2.8 Sublime Text

โปรแกรม Sublime Text เป็นโปรแกรมแก้ไขข้อความ และ เขียนโค้ด ส้าหรับโปรแกรมเมอร์ และ นักพัฒนา ที่มีขนาดเล็ก เพียงแค่ 7MB เท่านั น แต่ยังคงประสิทธิภาพและฟังก์ชันไว้มากมาย ใช้งานง่ายและ ท้างานได้อย่างรวดเร็ว รองรับการใช้งานหลากหลายภาษา ไม่ว่าจะเป็น ภาษาหลักๆ อย่าง C, C++, C# เขียน เว็บไซต์ HTML, PHP โค้ด CSS เขียนภาษา JAVA, Python หรืออื่น ๆ อีกมากมาย ด้วยหน้าตาที่ใช้งานเขียน ส่วนโค้ดแบ่งแต่ละส่วนอย่างชัดเจน สามารถแก้ไขข้อความหลาย ๆ บรรทัดพร้อมกันได้ ค้นหา Text แต่ละส่วน ได้ อีกทั งยังมีแถบ แสดงโค้ดทั งหมด ดังแสดงในรูปที่ 2.22
ส้าหรับ โปรแกรมเขียนโค้ด Sublime Text เป็นโปรแกรมเขียน แก้ไขโค้ด ที่มีประสิทธิภาพสูง ด้วย ประสิทธิภาพจาก Python API ที่ช่วยให้สามารถติดตั งปลั๊กอินเสริมต่าง ๆ และ Package ให้โปรแกรมมี ประสิทธิภาพในการท้างานมากยิ่งขึ น ช่วยให้งานเขียนโค้ดท้าได้อย่างรวดเร็วและประหยัดเวลา สามารถสลับ การท้างานบน Project ที่ท้าอยู่ได้อย่างรวดเร็ว โปรแกรมนี รองรับการใช้งานบนระบบปฏิบัติการ Windows Linux และ macOS ได้เป็นอย่างดี (thaiware, 2560)
คุณสมบัติและความสามารถของโปรแกรม
1) เขียนโค้ด แก้ไขข้อความ Code Markup ต่าง ๆ ได้อย่างง่ายดาย

2) โปรแกรมมีขนาดเล็ก เพียงแค่ 7 MB แต่คงประสิทธิภาพไว้มากมาย
3) หน้าตาออกแบบมาให้ใช้งานง่าย เขียนและค้นหาข้อมูล ได้เร็ว
4) สามารถสลับการท้างานแต่ละ Project ได้เร็วเหมือนเปิดใหม่ๆ
5) รองรับการท้างาน เขียนโค้ด ได้หลายภาษา
6) รองรับระบบปฏิบัติการ Windows/Mac OS/Linux
7) พร้อมฟังก์ชันพิเศษอื่นๆ ให้เลือกใช้งานมากมาย

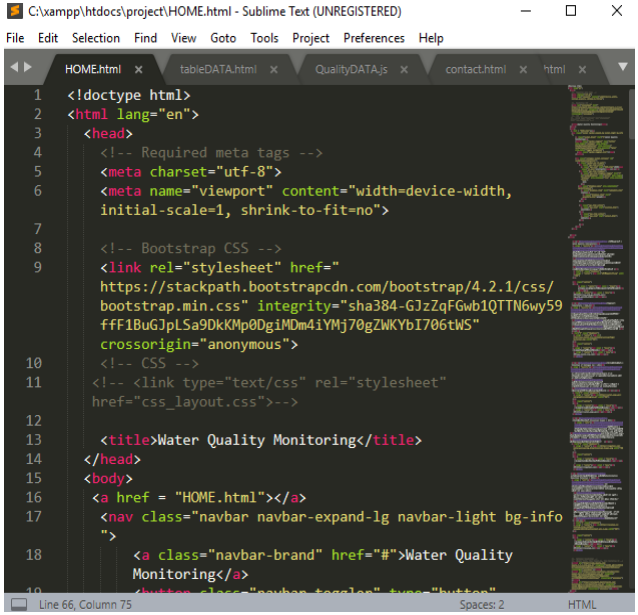
[picture p24: figure]

รูปที่ 2.22 โปรแกรม Sublime Text

บทที่ 3
แนวคิดและการออกแบบ

ระบบเซนเซอร์ทางด้านสิ่งแวดล้อมเป็นการออกแบบโดยใช้เทคโนโลยีลอร่าเป็นตัวกลางในการส่ง ข้อมูล ประกอบไปด้วยเซนเซอร์4 ตัว อันได้แก่ เซนเซอร์ส้าหรับวัดอุณหภูมิของน ้า เซนเซอร์ส้าหรับวัดความ เป็นกรดเป็นด่าง เซนเซอร์ส้าหรับวัดค่าออกซิเจนที่ละลายน ้า และเซนเซอร์ส้าหรับวัดความสามารถในการ ออกซิไดซ์ โดยเซนเซอร์แต่ละตัวจะมีโมดูลต่อเข้ากับบอร์ดที่ท้าหน้าที่เป็นตัวส่งข้อมูล ซึ่งมีการใช้บอร์ด 2 ตัวที่ มีความถี่923 MHz เดียวกันในการรับส่งข้อมูล ซึ่งข้อมูลจากเซนเซอร์ทั ง 4 ตัว จะมีการส่งข้อมูลผ่านเทคโนโลยี ลอร่าโดยมีการใช้โปรโตคอลลอร่าแบบสร้างแพ็กเก็ตเองในการส่งข้อมูลไปยังลอร่าเกตเวย์ และใช้เครือข่าย อินเทอร์เน็ตเป็นตัวกลางในการส่งข้อมูลมาที่ฐานข้อมูล และแสดงผลผ่านเว็บไซต์ ดังแสดงในรูปที่ 3.1

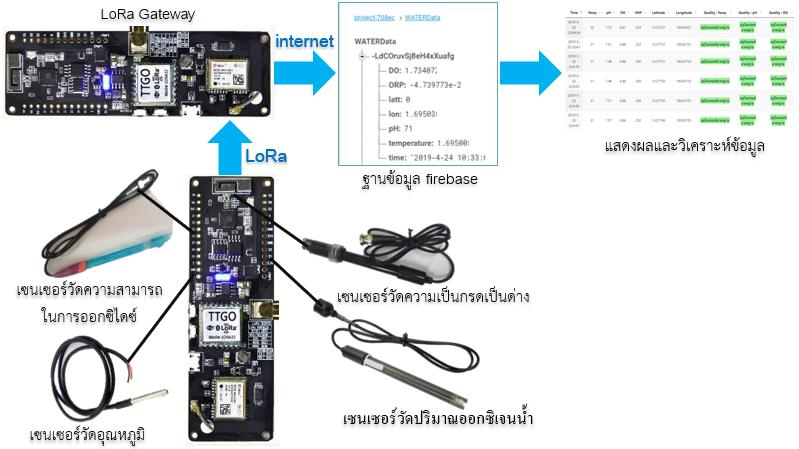
[picture p25: figure]

รูปที่ 3.1 แบบจ้าลองระบบเซนเซอร์ทางด้านสิ่งแวดล้อมโดยใช้เทคโนโลยีลอร่า

### 3.1 การเลือกใช้เซนเซอร์ส้าหรับวัดคุณภาพน ้า

เซนเซอร์วัดค่าที่ใช้งานทางด้านสิ่งแวดล้อม จ้านวน 4 ตัว ได้แก่ โพรบเซนเซอร์ส้าหรับวัดอุณหภูมิเป็น การรับรู้หรือตรวจจับระดับอุณหภูมิโพรบเซนเซอร์ส้าหรับวัดความเป็นกรดเป็นด่างเป็นการวัดสภาพความเป็น กรดหรือเป็นด่างของสารละลายที่มีน ้าเป็นตัวท้าลาย โพรบเซนเซอร์ส้าหรับวัดความสามารถในการออกซิไดซ์ เป็นการวัดแนวโน้มของชนิดสารเคมีเพื่อรับอิเล็กตรอน (ตัวออกซิไดซ์) และให้อิเล็กตรอน (ตัวรีดิวซ์) โพรบ

เซนเซอร์ส้าหรับวัดออกซิเจนที่ละลายน ้า ใช้งานคู่กับบอร์ดส้าหรับแปลงสัญญาณเป็นการวัดปริมาณออกซิเจน ที่ละลายน ้า

### 3.1.1 อุปกรณ์ส้าหรับวัดอุณหภูมิ

การเลือกใช้โพรบเซนเซอร์ส้าหรับวัดอุณหภูมิเนื่องจากอุณหภูมิของน ้าในแหล่งน ้าจะมีอิทธิพลสูงต่อ ปริมาณและความหลากหลายของสิ่งมีชีวิตในแหล่งน ้านั น โดยโพรบเซนเซอร์ส้าหรับวัดอุณหภูมิที่เลือกวัด อุณหภูมิจะมีมอดูลที่ใช้งานร่วมกันกับโพรบวัดอุณหภูมิสามารถวัดค่าอุณหภูมิได้ตั งแต่ -55 องศาเซลเซียส จนถึง 125 องศาเซลเซียส หรือ -67 องศาฟาเรนไฮต์ ถึง 257 องศาฟาเรนไฮต์ ใช้แรงดันไฟฟ้าที่ 3 โวลต์ถึง 5.5 โวลต์

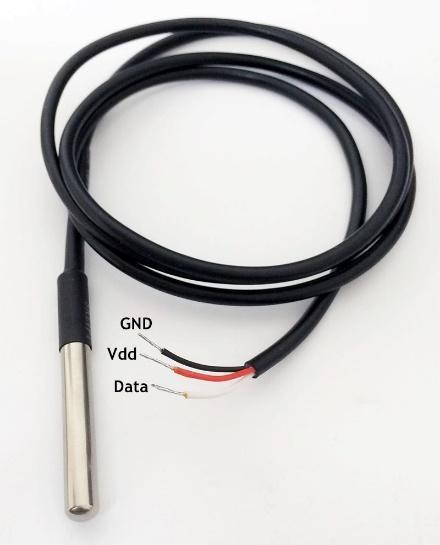
[picture p26: figure]

รูปที่ 3.2 โพรบเซนเซอร์ส้าหรับวัดอุณหภูมิ

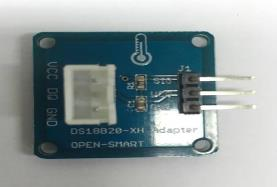
[picture p27: figure]

รูปที่ 3.3 มอดูลที่ใช้งานคู่กับโพรบวัดอุณหภูมิ

### 3.1.2 อุปกรณ์ส้าหรับวัดความเป็นกรดเป็นด่าง

การเลือกใช้โพรบเซนเซอร์ส้าหรับวัดความเป็นกรดเป็นด่างเนื่องจากค่าความเป็นกรดเป็นด่างมี ความส้าคัญเป็นอย่างมากต่อแหล่งน ้าและจ้าเป็นต่อการตรวจสอบความปลอดภัยของสภาพน ้า สัตว์หลายชนิด ไม่สามารถอาศัยอยู่ในน ้าที่มีค่าความเป็นกรดเป็นด่าง ต่้ากว่า 5 หรือสูงกว่า 9 การเพิ่มขึ นหรือลดลงของค่า จากช่วงค่าปกติของน ้าอาจบ่งบอกถึงมลภาวะทางน ้าที่มีการปนเปื้อนของสารเคมีหรือฝนกรด โดยโพรบ เซนเซอร์ส้าหรับวัดความเป็นกรดเป็นด่างที่เลือก จะมีมอดูลที่ใช้งานร่วมกันกับโพรบวัดความเป็นกรดเป็นด่าง ส้าหรับการตรวจสอบค่าความเป็นกรดเป็นด่าง สามารถวัดค่าความเป็นกรดเป็นด่างได้ตั งแต่ 0 จนถึง 14 ใช้ แรงดันไฟฟ้าที่ 5 โวลต์

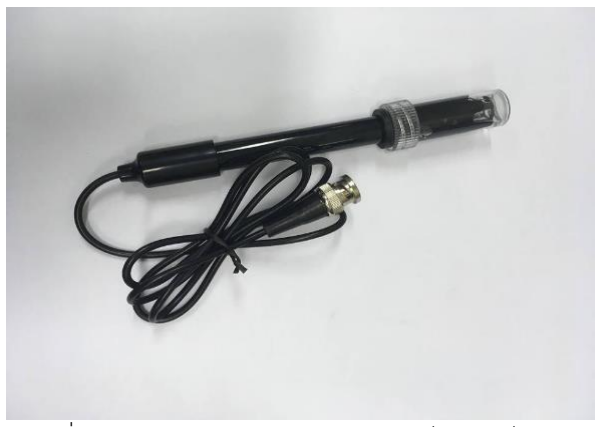
[picture p28: figure]

รูปที่ 3.4 โพรบเซนเซอร์ส้าหรับวัดความเป็นกรดเป็นด่าง

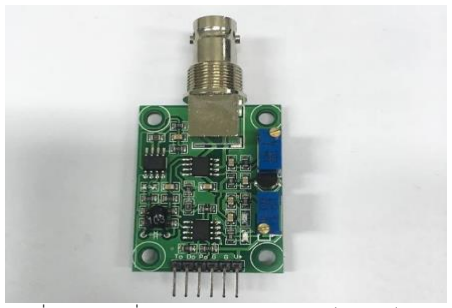
[picture p29: figure]

รูปที่ 3.5 มอดูลที่ใช้งานคู่กับโพรบวัดความเป็นกรดเป็นด่าง

เนื่องจากค่าที่อ่านของโพรบเซนเซอร์ส้าหรับวัดความเป็นกรดเป็นด่างจะอยู่ในรูปของแรงดันสัญญาณ แอนะล็อกจึงจ้าเป็นต้องมีการสอบเทียบอุปกรณ์เพื่อท้าให้ผลการวัดที่เกิดขึ นเป็นที่เชื่อถือได้ คือการใช้เครื่องมือ วัด ที่มีความถูกต้องและแม่นย้าดังขั นตอนต่อไปนี

1. เตรียมน ้ากลั่นขนาด 250 ml
2. ผสมสารสอบเทียบมาตราฐาน ดังแสดงในรูปที่ 3.6 กับน ้ากลั่น (สาร 1 ค่า ต่อน ้า 250 ml) ให้เข้า กัน

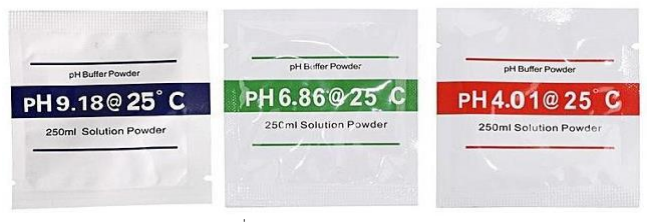
[picture p30: figure]

รูปที่ 3.6 สารสอบเทียบมาตราฐาน

3. น้าสารละลายความเข้มข้น 250 ml ที่ได้ท้าการเตรียมไว้ข้างต้น ไปใช้ในการเปรียบเทียบ หรือ สอบเทียบค่าได้
4. ต่อโพรบเซนเซอร์ส้าหรับวัดความเป็นกรดเป็นด่างกับโมดูลที่ใช้งานคู่กับโพรบวัดความเป็นกรด เป็นด่าง และจอแสดงผล ดังแสดงตามรูปที่ 3.7

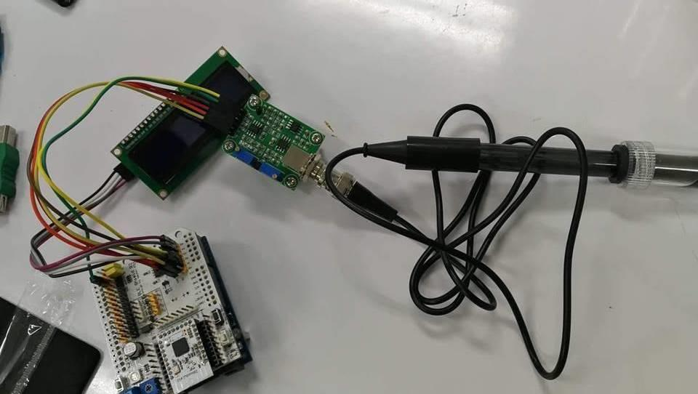
[picture p31: figure]

รูปที่ 3.7 การต่อโพรบเซนเซอร์ส้าหรับวัดความเป็นกรดเป็นด่างกับโมดูลและจอแสดงผล

5. ท้าการสอบเทียบค่าโดยใช้โพรบเซนเซอร์ส้าหรับวัดความเป็นกรดเป็นด่าง จุ่มลงไปในสารละลาย ความเข้มข้น 250 ml ดังแสดงในรูปที่ 3.8 สอบเทียบตามค่าที่เตรียมไว้ จ้านวน 3 ค่า ได้แก่ 9.18 6.86 และ 4.01

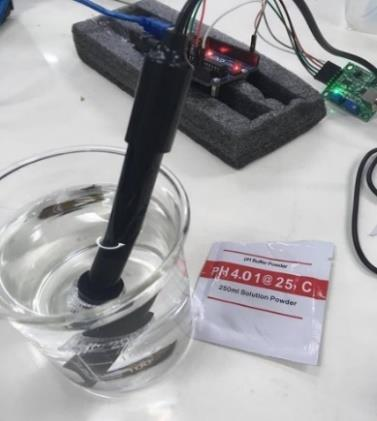
[picture p32: figure]

รูปที่ 3.8 การต่อโพรบเซนเซอร์ส้าหรับวัดความเป็นกรดเป็นด่างกับโมดูลและจอแสดงผล

6. ท้าซ ้าเก็บข้อมูลค่าที่ได้เพื่อหาค่าเฉลี่ยของข้อมูลในแต่ละค่า

### 3.1.3 อุปกรณ์ส้าหรับวัดความสามารถในการออกซิไดซ์

การเลือกใช้โพรบเซนเซอร์ส้าหรับวัดความสามารถในการออกซิไดซ์ใช้งานคู่กับโมดูลมอดูลที่ใช้งาน คู่กับโพรบวัดความสามารถในการออกซิไดซ์สามารถวัดค่าความสามารถในการออกซิไดซ์ ได้ตั งแต่ -2000 มิลลิโวลต์ถึง 2000 มิลลิโวลต์ใช้แรงดันไฟฟ้าที่ 5 โวลต์

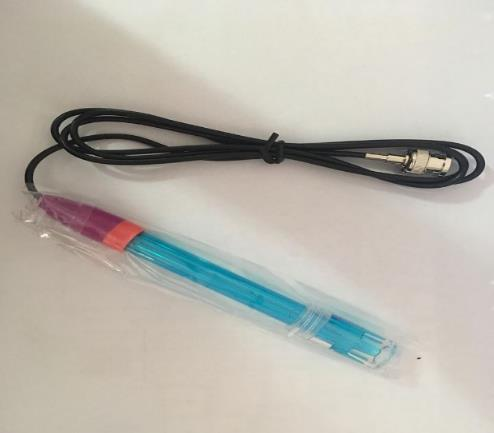
[picture p33: figure]

รูปที่ 3.9 โพรบเซนเซอร์ส้าหรับวัดความสามารถในการออกซิไดซ์

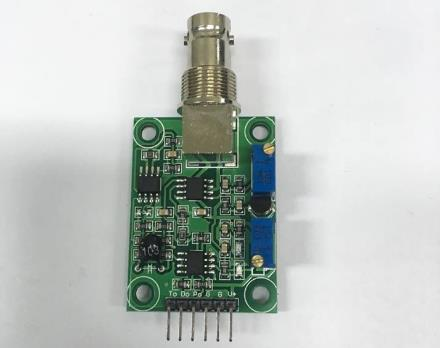
[picture p34: figure]

รูปที่ 3.10 มอดูลที่ใช้งานคู่กับโพรบวัดความสามารถในการออกซิไดซ์

หมายเหตุ เนื่องจากค่าที่อ่านได้จากโพรบเซนเซอร์ส้าหรับวัดความสามารถในการออกซิไดซ์ จะอยู่ใน รูปของแรงดันสัญญาณแอนะล็อกจึงจ้าเป็นต้องมีการแปลงแรงดันก่อนเสมอ

### 3.1.4 อุปกรณ์ส้าหรับวัดออกซิเจนที่ละลายน ้า

การเลือกใช้โพรบเซนเซอร์ส้าหรับวัดออกซิเจนที่ละลายน ้าเนื่องจากสิ่งมีชีวิตชนิดต่าง ๆ ที่อาศัยอยู่ใน น ้าต้องการปริมาณออกซิเจนแตกต่างกัน แต่โดยทั่วไปแล้วสิ่งมีชีวิตในน ้าต้องการออกซิเจนที่ละลายอยู่ในน ้า อย่างน้อยที่สุด 6 mg/l เพื่อการเติบโต และการพัฒนาการของชีวิต โดยโพรบเซนเซอร์ส้าหรับวัดออกซิเจนที่ ละลายน ้าที่เลือกใช้งานคู่กับบอร์ดส้าหรับแปลงสัญญาณ สามารถวัดค่าออกซิเจนที่ละลายในน ้า ได้ตั งแต่ 0 mg/l ถึง 20 mg/l ใช้แรงดันไฟฟ้าที่ 3.3 โวลต์ถึง 5.5 โวลต์

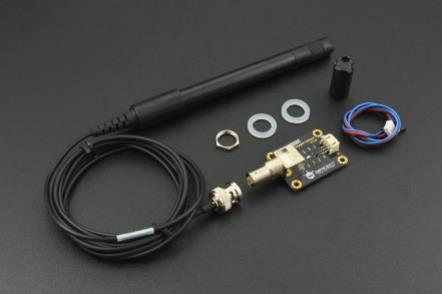
[picture p35: figure]

รูปที่ 3.11 โพรบเซนเซอร์ส้าหรับวัดออกซิเจนที่ละลายน ้า

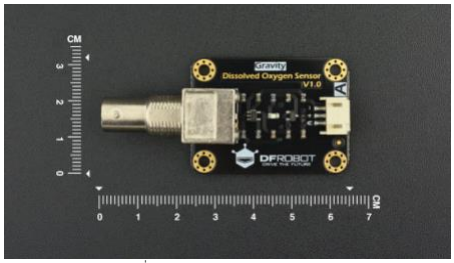
[picture p36: figure]

รูปที่ 3.12 บอร์ดส้าหรับแปลงสัญญาณ

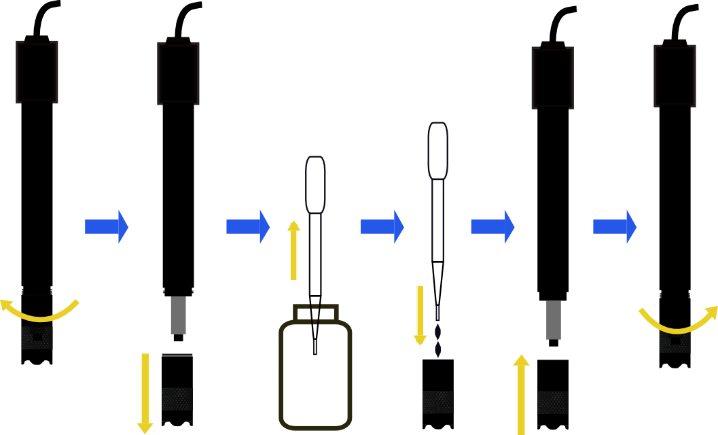
[picture p37: figure]

รูปที่ 3.13 ขั นตอนการใช้สารละลายโซดาไฟ 0.5 mol/l กับโพรบเซนเซอร์ ส้าหรับวัดออกซิเจนที่ละลายน ้า

จากรูปที่ 3.13 แสดงถึงขั นตอนการใช้สารละลาย โซดาไฟ ขนาด 0.5 mol/l กับโพรบเซนเซอร์ ส้าหรับวัดออกซิเจนที่ละลายน ้า โดยขั นตอนการสอบเทียบโพรบเซนเซอร์ส้าหรับวัดออกซิเจนที่ละลายน ้าให้ พร้อมใช้งานมีดังนี
1. ติดตั งค้าสั่งส้าหรับสอบเทียบ
2. หมุนฝาบริเวณหัวโพรบเซนเซอร์ออก
3. น้าสารละลายโซดาไฟ 0.5 mol/l หยดลงในฝาหัวเซนเซอร์จ้านวน 2 ใน 3 ส่วนของฝา
4. หมุนปิดฝาโพรบเซนเซอร์ให้สนิท
5. ท้าการติดตั งโพรบเซนเซอร์ส้าหรับวัดออกซิเจนที่ละลายน ้าเข้ากับบอร์ดส้าหรับแปลง สัญญาณ ดังแสดงในรูปที่ 3.14

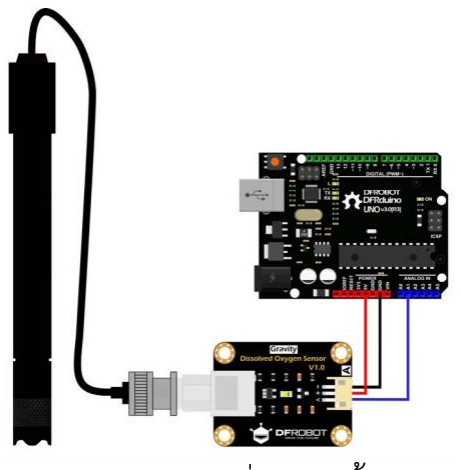
[picture p38: figure]

รูปที่ 3.14 การต่อเซนเซอร์ส้าหรับวัดออกซิเจนที่ละลายน ้าเข้ากับบอร์ดส้าหรับแปลงสัญญาณ

6. ท้าการสอบเทียบค่ากับค้าสั่งที่ตั งไว้โดยเริ่มต้นท้าการติดตั งค้าสั่งส้าหรับสอบเทียบ
7. เรียกใช้งานค้าสั่ง โดยพิมพ์ค้าว่า Calibration จอมอนิเตอร์จะแสดงค่าของอุณหภูมิและค่า ออกซิเจนที่ละลายน ้า ดังแสดงในรูป 3.15

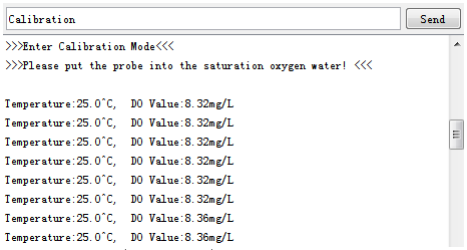
[picture p39: figure]

รูปที่ 3.15 แสดงผลที่ได้จากการพิมพ์ Calibration

8. เมื่อจอมอนิเตอร์แสดงค้าว่า Saturation Calibration Finish ให้พิมพ์ค้าว่า SATCAL จอมอนิเตอร์จะแสดงค่าของอุณหภูมิและค่าออกซิเจนที่ละลายน ้า ดังแสดงในรูปที่ 3.16

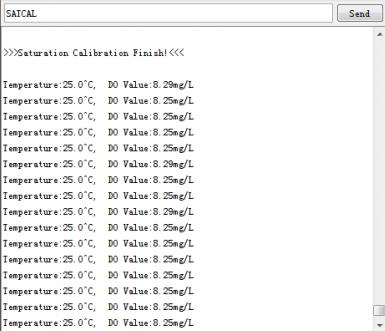
[picture p40: figure]

รูปที่ 3.16 ผลที่ได้จากการพิมพ์ SATCAL

9. เมื่อจอมอนิเตอร์แสดงค้าว่า Calibration Successful Exit Calibration Mode ให้พิมพ์ค้า ว่า EXIT เพื่อเป็นการออกจากขั นตอนการสอบเทียบ จอมอนิเตอร์จะแสดงค่าของอุณหภูมิ และค่าออกซิเจนที่ละลายน ้า ถือเป็นการสิ นสุดการสอบเทียบ ดังแสดงในรูปที่ 3.17

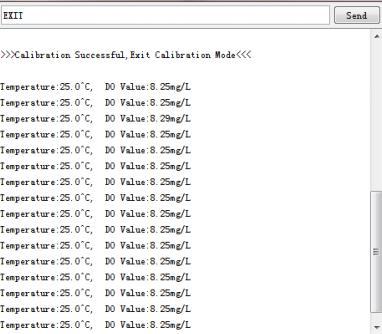
[picture p41: figure]

รูปที่ 3.17 ผลที่ได้จากการพิมพ์ EXIT

### 3.2 การออกแบบวงจรส้าหรับการส่งข้อมูลผ่านเทคโนโลยีลอร่า

ท้าการออกแบบการรับ-ส่งเทคโนโลยีลอร่าเลือกใช้TTGO ESP32 LoRa 923 MHz จ้านวน 2 ตัว และตัวส่งข้อมูลมีการต่อร่วมกับโมดูลในแต่ละตัวของโพรบเซนเซอร์โดยบอร์ด TTGO ESP32 LoRa ถูกต่อกับ ขาของเซนเซอร์วัดอุณหภูมิ และเซนเซอร์วัดปริมาณออกซิเจนละลายน ้า หรือ GPIO4 และ GPIO35 ตามล้าดับ และขา VCC ของเซนเซอร์ทั งสองต่อเข้ากับไฟลี ยงที่เป็นถ่าน 3.3 โวลต์และขา GND ของเซนเซอร์กับบอร์ด ESP32 ต่อกับ GND ร่วมกับไฟเลี ยง 3.3 โวลต์ ขาลบ ส่วนขาแอนะล็อกของเซนเซอร์วัดความเป็นกรดเป็นด่าง และเซนเซอร์วัดความสามารถในการออกซิไดซ์ ต่อขา A0 และ A1 ตามล้าดับ ของโมดูล ADS 1115 ซึ่งโมดูล ADS1115 ส้าหรับรับ และแปลงสัญญาณอนาล็อกเป็นดิจิตอลความละเอียด 16 บิต สั่งงานผ่านบัส I2C เปลี่ยน แอดเดรสเชื่อมต่อกันได้สูงสุด 4 โมดูลในบัสเดียว จึงเหมาะส้าหรับบอร์ดที่ใช้งานขาไม่เพียงพอ หรือในกรณีขา ของบอร์ดมีปัญหา นอกจากนี ยังปรับอัตราการขยายได้สูงสุดถึง 16 เท่า รองรับแรงดันถึง 5 โวลต์ เหมาะ ส้าหรับไมโครคอนโทรลเลอร์ที่ไม่มี ADC หรือต้องการ ADC ความละเอียดสูงขึ น และเนื่องจากบอร์ด ESP32 เป็นการใช้งานแบบ ADC ส้าหรับบอร์ด ESP32 มีระดับแรงดันสูงสุดเพียง 3.3 โวลต์แต่อุปกรณ์เซนเซอร์ ต้องการไฟเลี ยง 5 โวลต์ จึงไม่เพียงพอต่อการใช้งานจึงต้องใช้งานโมดูล ADS1115 เพื่อเพิ่มขาที่มีแรงดัน 5 โวลต์ในการใช้งาน ส่วนขา VCC GND SCL SDA และADDR ต่อเข้ากับไฟเลี ยง 5 โวลต์ GND ของไฟเลี ยง 5 โวลต์ ขา GPIO22 และ GPIO21 ของบอร์ด ESP32 และGND ร่วมของไฟเลี ยง 5 โวลต์ ตามล้าดับ ดังแสดงในรูปที่ 3.18

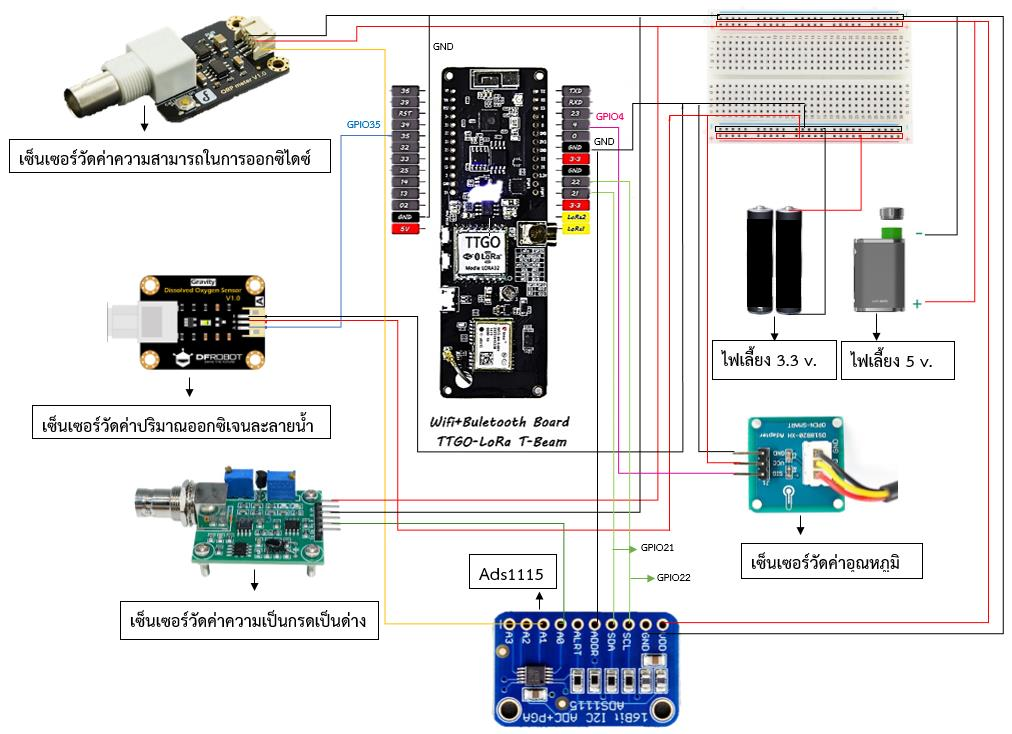
[picture p42: figure]

รูปที่ 3.18 การต่อวงจรส้าหรับการส่งข้อมูลด้วย TTGO ESP32 LoRa 923 MHz

ตารางที่ 3.1 การเชื่อมต่อขา GPIO

GPIO | การเชื่อมต่อ ส้าหรับบอร์ด TTGO ESP32 LoRa
GND 3.3 v. | กราวนด์อ้างอิงด์ร่วมกับบอร์ด ESP32 ส้าหรับไฟเลี ยง 3.3 โวลต์
GND 5 v. | กราวนด์อ้างอิงด์ร่วมกับบอร์ด ESP32 ส้าหรับไฟเลี ยง 5 โวลต์
GPIO21 | ขา SDA ของโมดูล ADS1115
GPIO22 | ขา SCL ของโมดูล ADS1115
GPIO4 | เซนเซอร์วัดอุณหภูมิ
GPIO35 | เซนเซอร์วัดปริมาณออกซิเจนละลายน ้า
ส้าหรับโมดูล ADS1115
VCC 5 v. | ไฟเลี ยง 5 โวลต์ ขาบวก
GND | ไฟเลี ยง 5 โวลต์ ขาลบ
ADDR | กราวนด์ร่วมของไฟเลี ยงขาลบ 5 โวลต์
A0 | เซนเซอร์วัดความเป็นกรดเป็นด่าง
A1 | เซนเซอร์วัดความสามารถในการออกซิไดซ์
SDA | GPIO21 ของบอร์ด TTGO ESP32 LoRa
SCL | GPIO22 ของบอร์ด TTGO ESP32 LoRa

หมายเหตุ ไฟเลี ยง 3.3 โวลต์ ใช้ต่อร่วมกับขา VCC ของเซนเซอร์วัดอุณหภูมิเซนเซอร์วัดปริมาณ ออกซิเจนละลายน ้า และไฟเลี ยง 5 โวลต์ ใช้ต่อร่วมกับขา VCC ของเซนเซอร์วัดความเป็นกรดเป็นด่าง และ เซนเซอร์วัดความสามารถในการออกซิไดซ์

### 3.3 การออกแบบการส่งข้อมูลผ่านเทคโนโลยีลอร่า

ท้าการออกแบบการรับ-ส่งเทคโนโลยีลอร่าเลือกใช้TTGO ESP32 LoRa 923 MHz จ้านวน 2 ตัว และตัวส่งข้อมูลมีการต่อร่วมกับโมดูลในแต่ละตัวของโพรบเซนเซอร์หลังจากได้ท้าการวัดค่าต่าง ๆ เป็นที่ เรียบร้อยแล้ว จะท้าการส่งข้อมูลจากเซนเซอร์มาที่ TTGO ESP32 LoRa โดยท้าหน้าที่เป็นตัวส่ง โดยผ่าน GPIO ที่ก้าหนดดังตารางที่ 3.1 และข้อมูลที่ได้จาก TTGO ESP32 LoRa ฝั่งส่ง จะส่งข้อมูลผ่านเทคโนโลยี ลอร่า ไปที่ TTGO ESP32 LoRa ซึ่งท้าหน้าที่เป็นเกตเวย์ส้าหรับการส่งข้อมูลผ่านเทคโนโลยีในครั งนี เป็นการ ส่งข้อมูลแบบเวลาจริง ท้าให้การสื่อสารของอุปกรณ์ลอร่าท้างานใน Class C เนื่องจากอุปกรณ์ Class C เป็น อุปกรณ์ที่ต้องมีการรับส่งข้อมูลแบบเวลาจริง โดยขั นตอนการท้างานของเทคโนโลยีลอร่าส้าหรับภาคส่ง ดัง แสดงในรูปที่ 3.19

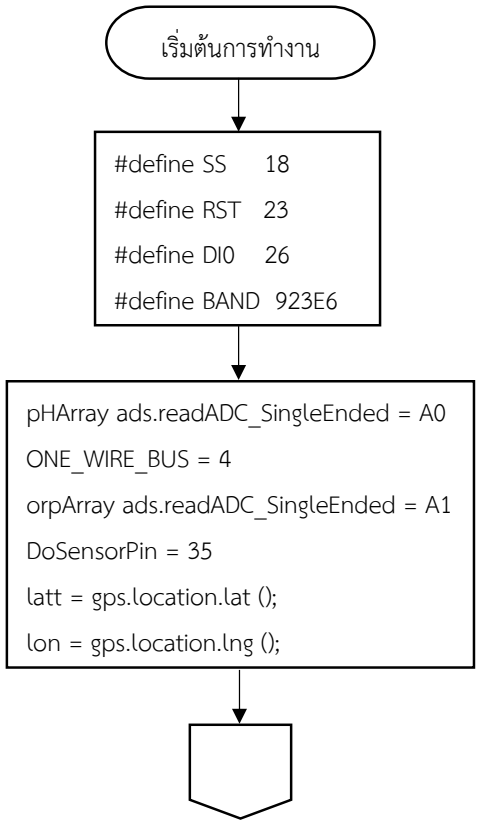
[picture p43: figure]
เริ่มต้นการท้างาน; #define SS 18 #define RST 23 #define DI0 26 #define BAND 923E6; pHArray ads.readADC_SingleEnded = A0 ONE_WIRE_BUS = 4 orpArray ads.readADC_SingleEnded = A1 DoSensorPin = 35 latt = gps.location.lat (); lon = gps.location.lng ();

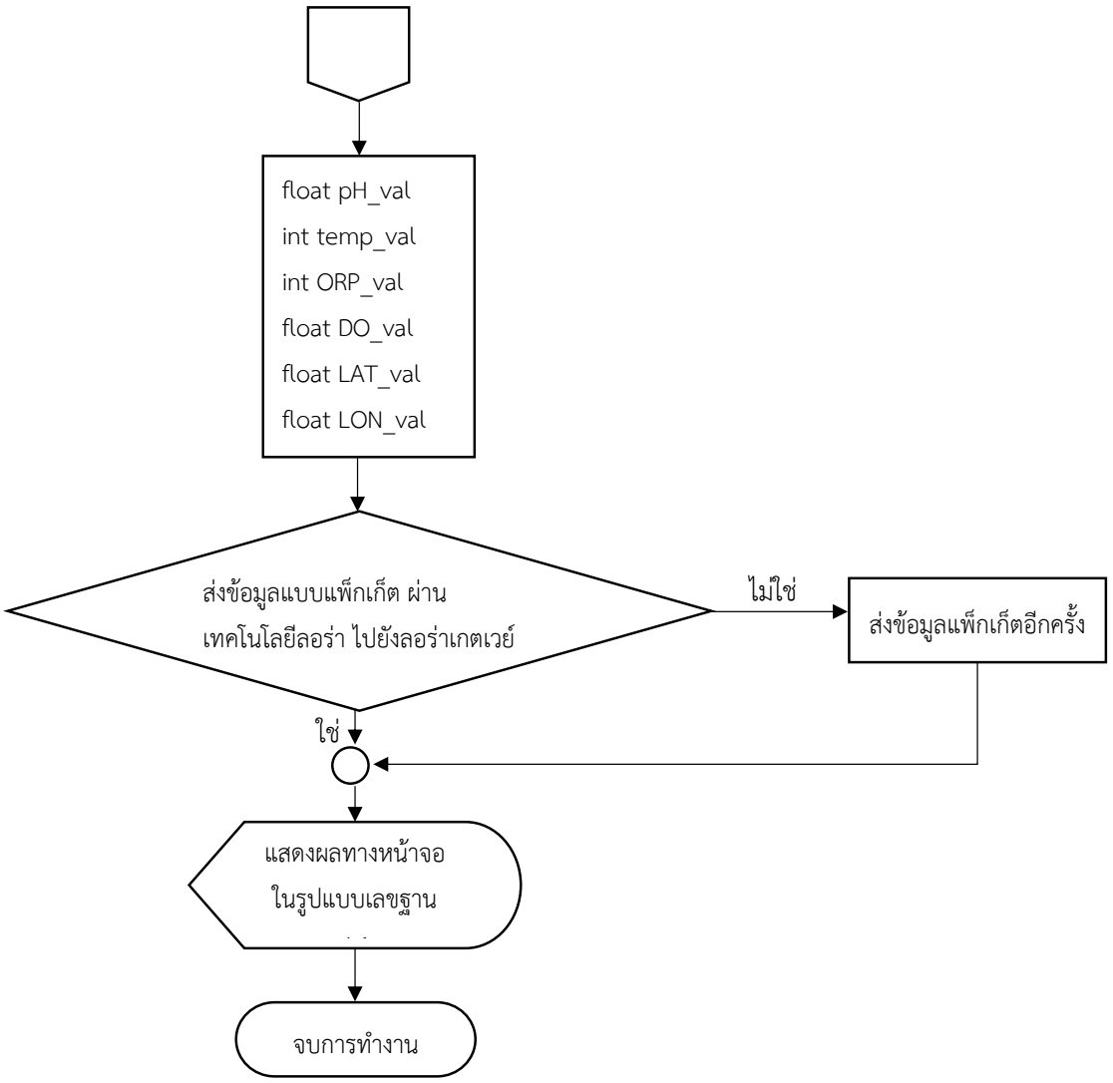
[picture p44: figure]
float pH_val int temp_val int ORP_val float DO_val float LAT_val float LON_val; จบการท้างาน; แสดงผลทางหน้าจอ ในรูปแบบเลขฐาน; ส่งข้อมูลแบบแพ็กเก็ต ผ่าน; เทคโนโลยีลอร่า ไปยังลอร่าเกตเวย์; ส่งข้อมูลแพ็กเก็ตอีกครั ง

รูปที่ 3.19 การท้างานของเทคโนโลยีลอร่าส้าหรับภาคส่ง

จากรูปที่ 3.19 มีรายละเอียดดังต่อไปนี ตัวแปร SS ใช้ขา 18 RST ใช้ขา 23 DI0 ใช้ขา 26 และBAND ใช้ความถี่ 923E6 เป็นการก้าหนดขาในส่วนของลอร่า และความถี่ที่ใช้งานในบอร์ด TTGO EPS32 LoRa 923 MHz ตัวแปร ONE_WIRE_BUS 4 เป็นการก้าหนดขาของเซนเซอร์ส้าหรับวัดอุณหภูมิโดยใช้ขา 4 ตัวแปร pHArray ads.readADC_SingleEnded (0) เป็นการก้าหนดขาของเซนเซอร์ส้าหรับวัดค่าความเป็นกรดเป็น ด่างโดยใช้ขา A0 ตัวแปร orpArray ads.readADC_SingleEnded (1) เป็นการก้าหนดขาของเซนเซอร์ส้าหรับ วัดความสามารถในการออกซิไดซ์โดยใช้ขา A1 และตัวแปร DoSensorPin 35 เป็นการก้าหนดขาของเซนเซอร์ วัดค่าปริมาณออกซิเจนละลายน ้าโดยใช้ขา 35 ตัวแปร latt = gps.location.lat (); ส้าหรับพิกัดระบุต้าแหน่ง ละติจูด และ latt = gps.location.lng (); ส้าหรับการระบุต้าแหน่งลองจิจูด ส่วน ตัวแปร float pH_val

ตัวแปร int temp val ตัวแปร int ORP_val ตัวแปร float DO_val ตัวแปร float LAT_val และตัวแปร float LON_val ใช้ในการเข้ารหัสแบบแปลงเลขฐาน จากเลขฐาน 10 เป็นเลขฐาน 16 เพื่อความปลอดภัยของข้อมูล โดยท้าการก้าหนดจ้านวนไบต์ของข้อมูลวัดคุณภาพน ้า
การท้างานของเทคโนโลยีลอร่าส้าหรับภาคส่ง โดยมีขั นตอนดังนี
1. ท้าการติดตั ง Library of TTGO-T-Beam ESP32 923 MHz จาก https://github.com/LilyGO/TTGO-T-Beam ในโปรแกรม Arduino
2. ดาวน์โหลดไลบรารี่ส้าหรับการใช้งานลอร่า และออกแบบให้ใช้งานแบบ Class C การท้างาน สองทิศทาง เพื่อให้รับส่งข้อมูลกันแบบเวลาจริง ดังแสดงในรูปที่ 3.20

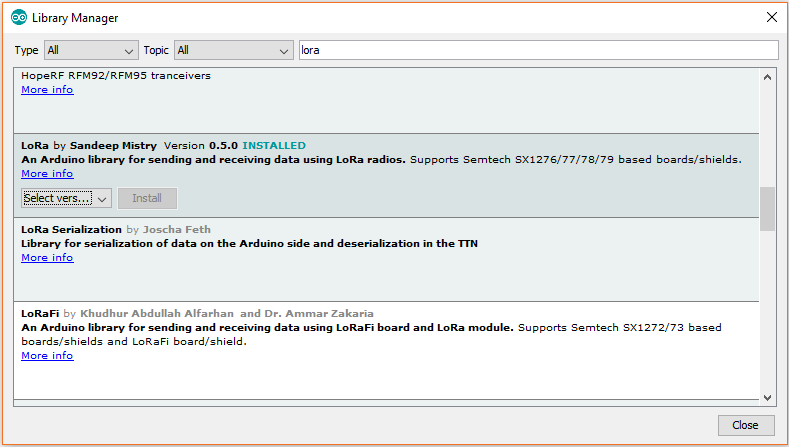
[picture p45: figure]

รูปที่ 3.20 หน้าต่างไลบรารี่ส้าหรับการใช้งานลอร่า

3. เปิดไฟล์ LoRaSender.ino ส้าหรับให้บอร์ด TTGO-T-Beam ESP32 923 MHz ท้าหน้าที่เป็น ตัวส่ง ดังแสดงในรูปที่ 3.21

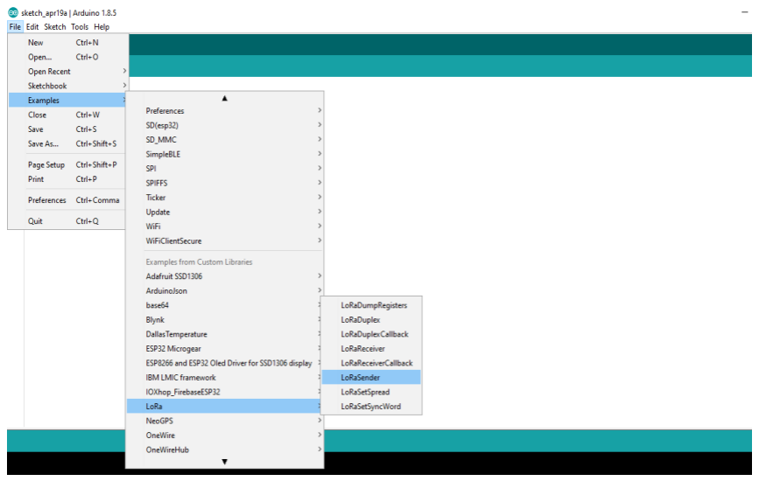
[picture p46: figure]

รูปที่ 3.21 ขั นตอนการเปิดไฟล์ LoRaSender.ino

4. ท้าการเพิ่มค้าสั่ง และก้าหนดขาในส่วนของลอร่า และเซนเซอร์ส้าหรับวัดอุณหภูมิ เซนเซอร์ ส้าหรับวัดค่าความเป็นกรดเป็นด่าง เซนเซอร์ส้าหรับวัดความสามารถในการออกซิไดซ์เซนเซอร์ วัดค่าปริมาณออกซิเจนละลายน ้า และพิกัดระบุต้าแหน่งจากดาวเทียม
5. ออกแบบการส่งข้อมูลแบบแพ็กเก็ต ส้าหรับส่งข้อมูลที่เป็นข้อมูลจ้านวนมาก ๆ
6. ใช้ค้าสั่งในการส่งข้อมูลผ่านเทคโนโลยีลอร่า
โดยใช้ค้าสั่ง LoRa.Beginpacket() เพื่อเริ่มต้นส่งข้อมูลในความถี่เดียวกันไปพร้อมกัน และเมื่อเชื่อม กับลอร่าได้แล้วจะใช้ฟังก์ชัน LoRa.print(packet) ในการส่งข้อมูล และแสดงผลข้อมูลแพ็กเก็ตเพื่อเป็นการ ตรวจสอบข้อมูล เมื่อส่งข้อมูลได้เรียบร้อยแล้วหากข้อมูลใน 1 packet ส่งครบทุกตัวโดยไม่มีข้อผิดพลาดแล้วจะ ใช้ค้าสั่ง LoRa.endpacket () เพื่อจบการส่งข้อมูลนั นแล้วท้าการส่งข้อมูลในแพ็กเก็ตใหม่ต่อไป

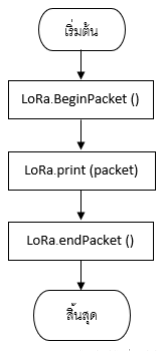
[picture p47: figure]

รูปที่ 3.22 การออกแบบการส่งข้อมูลโดยใช้ค้าสั่งเทคโนโลยีลอร่า

7. ท้าการส่งข้อมูลแบบแพ็กเก็ต ผ่านเทคโนโลยีลอร่า ไปยังตัวรับโดยท้าการเข้ารหัสแบบแปลงเลข ฐาน จากเลขฐานสิบ เป็นเลขฐานสิบหก เพื่อความปลอดภัยของข้อมูลโดยท้าการก้าหนดจ้านวน ไบต์ของข้อมูลวัดคุณภาพน ้า ดังแสดงในรูปที่ 3.22 และท้าการแกะข้อมูลแบบแปลงเลขฐานกลับ จากเลขฐานสิบหก เป็นเลขฐานสิบ ที่ตัวรับ ดังแสดงในรูปที่ 3.23

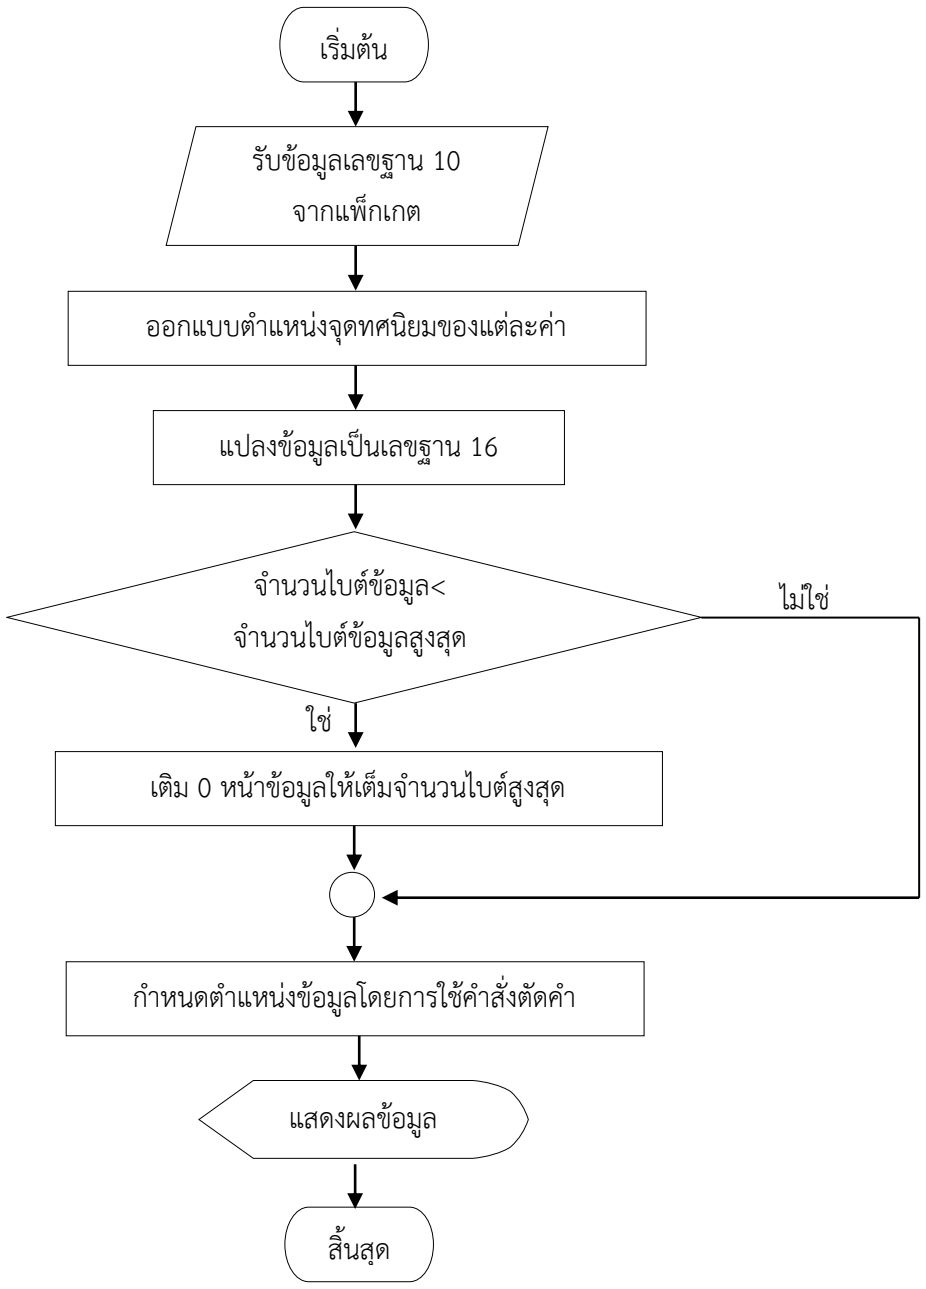
[picture p48: figure]
ออกแบบต้าแหน่งจุดทศนิยมของแต่ละค่า; แปลงข้อมูลเป็นเลขฐาน 16; เติม 0 หน้าข้อมูลให้เต็มจ้านวนไบต์สูงสุด; จ้านวนไบต์ข้อมูล< จ้านวนไบต์ข้อมูลสูงสุด; รับข้อมูลเลขฐาน 10 จากแพ็กเกต; ก้าหนดต้าแหน่งข้อมูลโดยการใช้ค้าสั่งตัดค้า; แสดงผลข้อมูล

รูปที่ 3.23 การส่งข้อมูลแบบแพ็กเก็ต

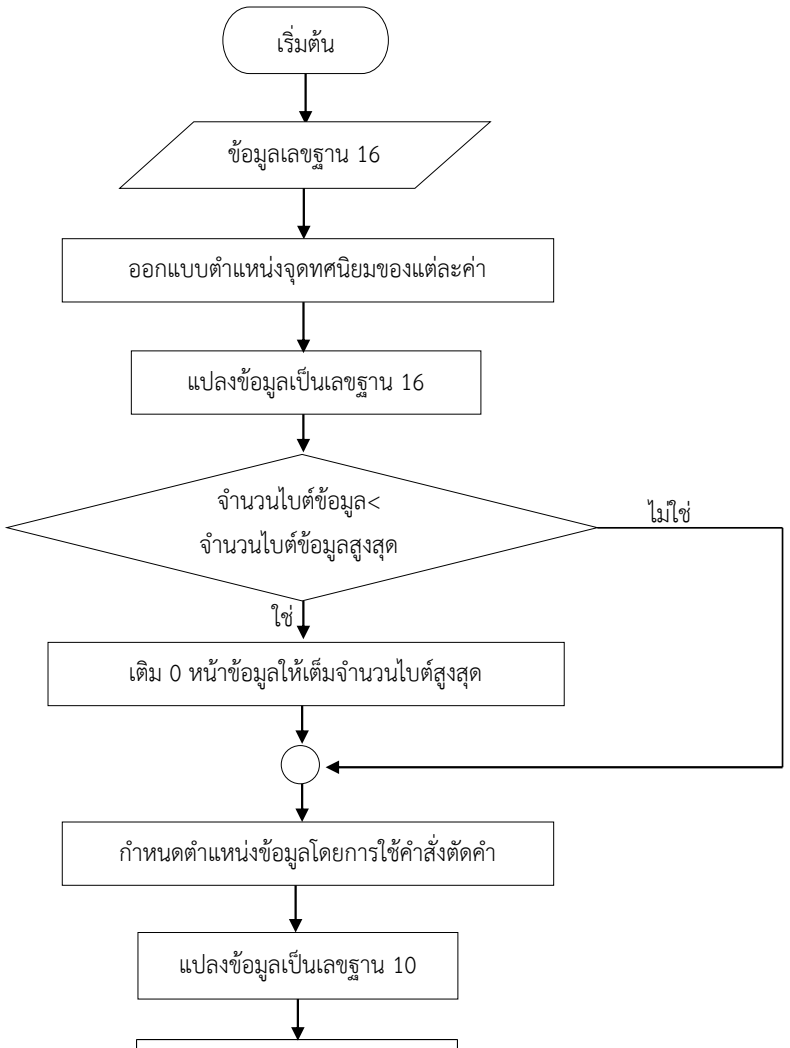
[picture p49: figure]
ข้อมูลเลขฐาน 16; ออกแบบต้าแหน่งจุดทศนิยมของแต่ละค่า; แปลงข้อมูลเป็นเลขฐาน 16; เติม 0 หน้าข้อมูลให้เต็มจ้านวนไบต์สูงสุด; จ้านวนไบต์ข้อมูล< จ้านวนไบต์ข้อมูลสูงสุด; แปลงข้อมูลเป็นเลขฐาน 10; ก้าหนดต้าแหน่งข้อมูลโดยการใช้ค้าสั่งตัดค้า

รูปที่ 3.24 การรับข้อมูลแบบแพ็กเก็ต

### 3.4 การออกแบบข้อมูลแบบแพ็กเก็ต

Packet คือ หน่วยย่อยของข้อมูล ซึ่งเป็นการแบ่งข้อมูลออกเป็นส่วนย่อย ๆ ช่วยให้การแลกเปลี่ยน ข้อมูลผ่านระบบอินเทอร์เน็ตนั นเร็วขึ น เพราะการแบ่งข้อมูลเป็นส่วนย่อยนี แต่ละส่วนย่อยจะถูกส่งไปยัง

แสดงผลข้อมูล

สิ นสุด

จุดหมายพร้อมๆกัน ซึ่งแต่ละอันจะจ่าหน้าถึงผู้รับเดียวกัน แทนการส่งแบบที่ส่งข้อมูลไปทั งหมดทั งก้อนซึ่งท้า ให้ส่งได้ช้า โดยการส่งข้อมูลผ่านเทคโนโลยีลอร่า
- เซนเซอร์วัดค่าความเป็นกรดเป็นด่างมีค่ามาตรฐานตั งแต่ 0.00 ถึง 14.00 ก้าหนดให้เป็นข้อมูลขนาด 3 ไบต์
- เซนเซอร์วัดอุณหภูมิมีค่ามาตรฐานตั งแต่ 0 ถึง 50 องศาเซลเซียส ก้าหนดให้เป็นข้อมูลขนาด 2 ไบต์
- เซนเซอร์วัดความสามารถในการออกซิไดซ์มีค่ามาตรฐานตั งแต่ -1999 ถึง 1999 มิลลิโวลต์ก้าหนดให้ เป็นข้อมูลขนาด 4 ไบต์
- เซนเซอร์วัดปริมาณออกซิเจนละลายน ้ามีค่ามาตรฐานตั งแต่ 0.00 ถึง 20.00 ก้าหนดให้เป็นข้อมูล ขนาด 4 ไบต์
- การระบุต้าแหน่งทางดาวเทียม ก้าหนดให้ Latitude มีค่ามาตรฐานตั งแต่ 0.00000 ถึง 90.00000 ก้าหนดให้เป็นข้อมูลขนาด 4 ไบต์ และ Longitude มีค่ามาตรฐานตั งแต่ 0.00000 ถึง 180.00000 ก้าหนดให้เป็นข้อมูลขนาด 4 ไบต์ มีข้อมูลขนาด 6 ไบต์

รูปที่ 3.25 การออกแบบข้อมูลแบบแพ็กเก็ต

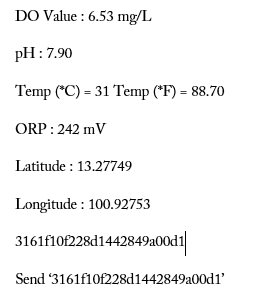
[picture p50: figure]

รูปที่ 3.26 ตัวอย่างการส่งข้อมูลแบบแพ็กเก็ต

จากรูปที่ 3.26 เป็นตัวอย่างการส่งข้อมูลแบบแพ็กเกตข้อมูลที่น้ามาแปลงจะไม่สนใจจุดทศนิยม ท้า การแปลงเป็นเลขฐานสิบหกเพื่อเป็นการเข้ารหัสฐานข้อมูล และส่งข้อมูลออกมาในรูปแบบแพ็กเกต ดังต่อไปนี
- ค่าความเป็นกรดเป็นด่าง ข้อมูลที่น้ามาแปลงคือ 790 แปลงเป็นเลขฐานสิบหก ได้เป็น 316
- ค่าอุณหภูมิ ข้อมูลที่น้ามาแปลงคือ 31 แปลงเป็นเลขฐานสิบหก ได้เป็น 1f
- ค่าความสามารถในการออกซิไดซ์ ข้อมูลที่น้ามาแปลงคือ 242 แปลงเป็นเลขฐานสิบหก ได้เป็น 10f2
- ค่าปริมาณออกซิเจนละลายน ้า ข้อมูลที่น้ามาแปลงคือ 653 แปลงเป็นเลขฐานสิบหก ได้เป็น 28d
- การระบุต้าแหน่งทางดาวเทียม Latitude ข้อมูลที่น้ามาแปลงคือ 1327749 แปลงเป็นเลขฐานสิบหก ได้เป็น 144284
- การระบุต้าแหน่งทางดาวเทียม Longitude ข้อมูลที่น้ามาแปลงคือ 1327749 แปลงเป็นเลขฐานสิบ หก ได้เป็น 9a00d1
จะได้ว่าข้อมูลที่ท้าการส่งออกมาในข้อมูลแบบแพ็กเก็ตคือ 3161f10f228d1442849a00d1

### 3.5 ออกแบบฐานข้อมูลส้าหรับเก็บข้อมูลแบบเวลาจริง

ส้าหรับฐานข้อมูลที่เลือกใช้ในการเก็บข้อมูลคือ Firebase Realtime Database เนื่องจากฐานข้อมูล แบบ NoSQL cloud database ที่เก็บข้อมูลในรูปแบบของ JSON และมีการซิงค์ข้อมูลแบบเวลาจริงกับทุก อุปกรณ์ที่เชื่อมต่อแบบอัตโนมัติในเวลาเพียงไม่กี่วินาที รองรับการท้างานเมื่อท้างานแบบออฟไลน์ รวมถึง สามารถออกแบบเงื่อนไขการเข้าถึงข้อมูลทั งการอ่านข้อมูลเพียงอย่างเดียว และการเขียนได้ โดยมีขั นตอนการ ใช้งานดังต่อไปนี
1. ท้าการลงทะเบียนใช้งาน Google Firebase
2. เริ่มต้นใช้งาน Firebase โดยไปที่ Gat started ดังแสดงในรูปที่ 3.27

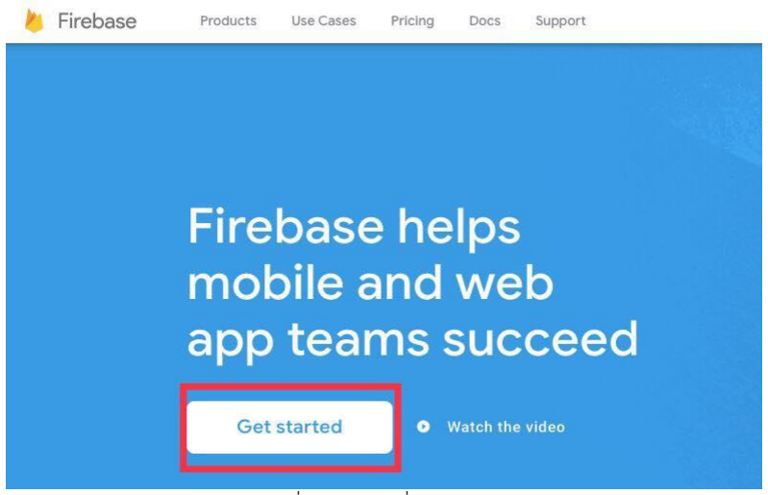
[picture p51: figure]

รูปที่ 3.27 การเริ่มต้นใช้งาน

3. ท้าการเพิ่มโครงการ โดยไปที่ Add project ดังแสดงในรูปที่ 3.28 และท้าการสร้างโครงการ โดย กรอกชื่อโครงการ และสถานที่ จากนั นท้าการอ่านและยอมรับเงื่อนไข กด Create project ถือ เป็นการเสร็จสิ นการสร้างโครงการ ดังแสดงในรูป 3.29

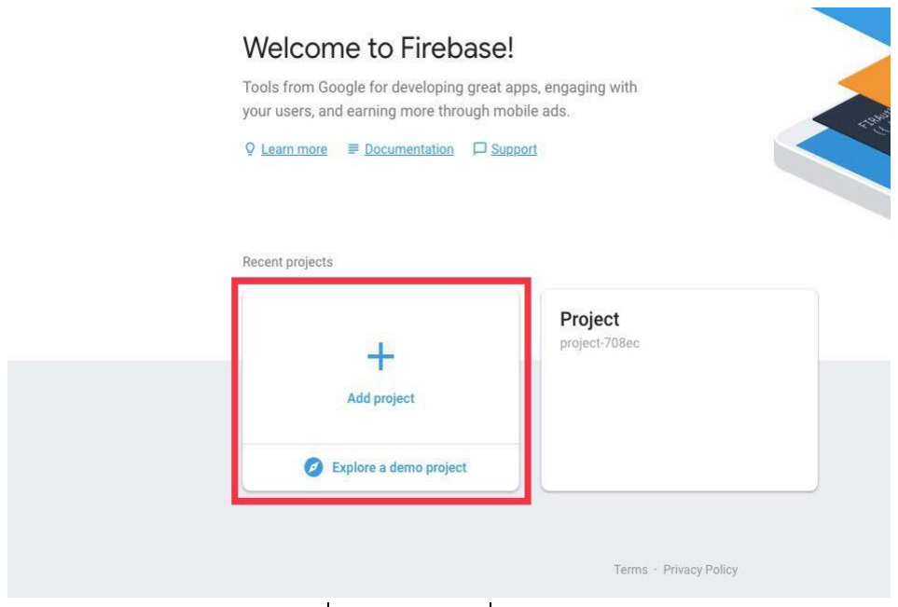
[picture p52: figure]

รูปที่ 3.28 การเพิ่มโครงการ

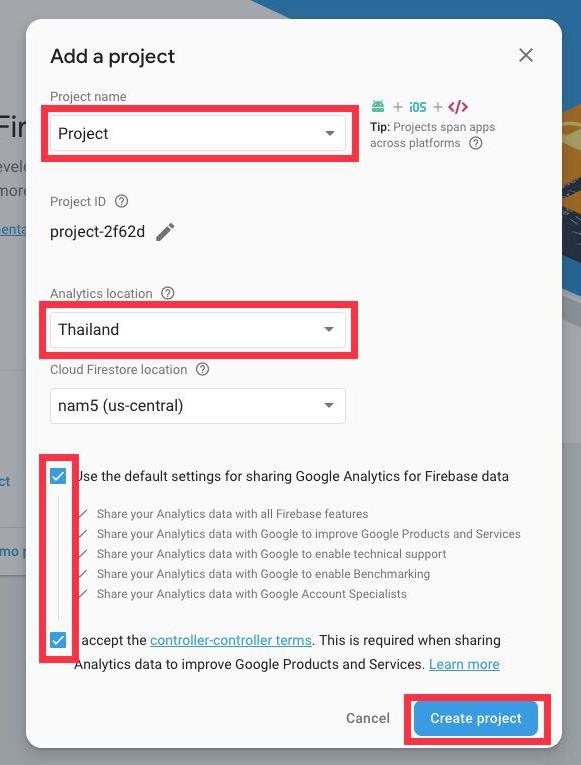
[picture p53: figure]

รูปที่ 3.29 การสร้างโครงการ

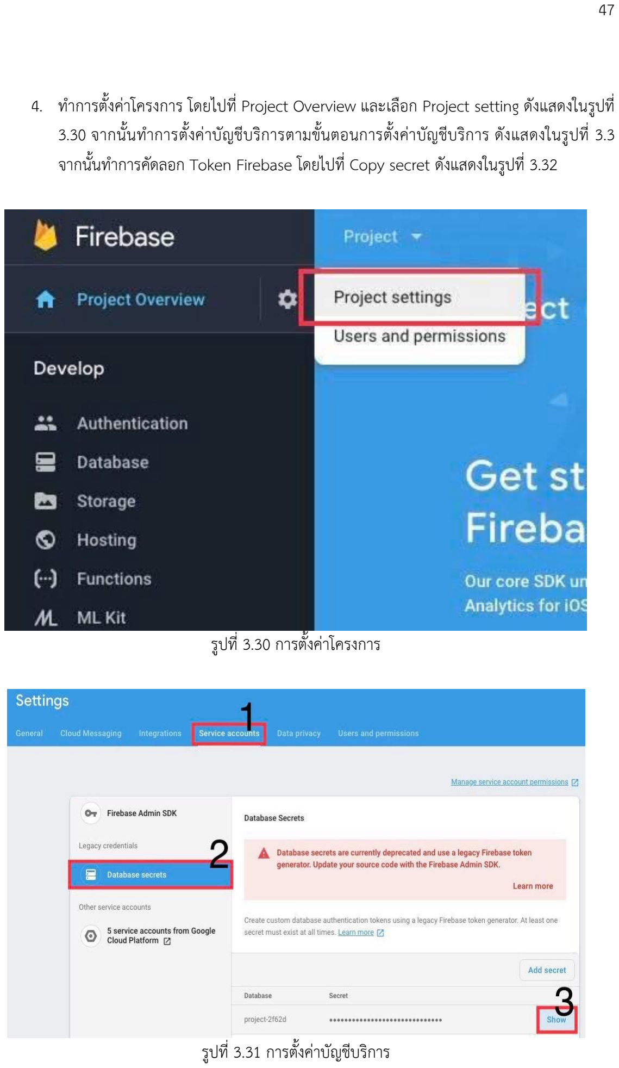
[picture p54: page 61]

4. ท้าการตั งค่าโครงการ โดยไปที่ Project Overview และเลือก Project setting ดังแสดงในรูปที่ 3.30 จากนั นท้าการตั งค่าบัญชีบริการตามขั นตอนการตั งค่าบัญชีบริการ ดังแสดงในรูปที่ 3.3 จากนั นท้าการคัดลอก Token Firebase โดยไปที่ Copy secret ดังแสดงในรูปที่ 3.32

รูปที่ 3.30 การตั งค่าโครงการ

รูปที่ 3.31 การตั งค่าบัญชีบริการ

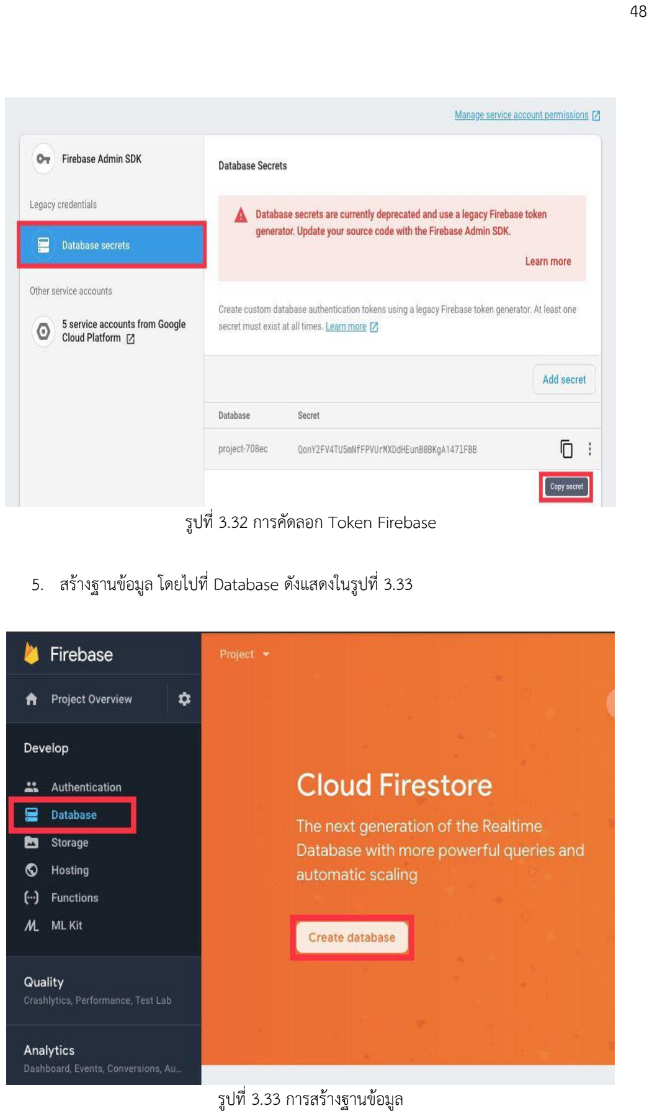
[picture p55: page 62]

รูปที่ 3.32 การคัดลอก Token Firebase

5. สร้างฐานข้อมูล โดยไปที่ Database ดังแสดงในรูปที่ 3.33

รูปที่ 3.33 การสร้างฐานข้อมูล

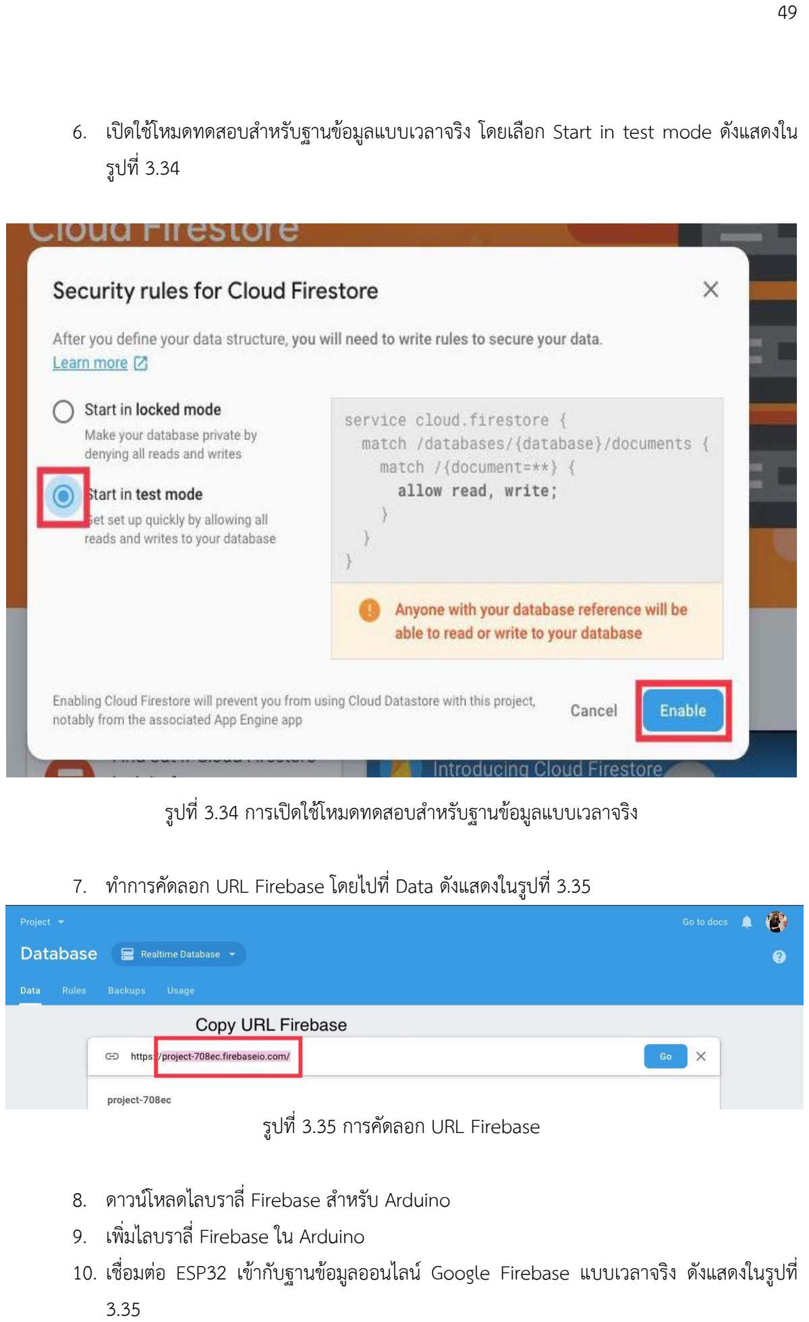
[picture p56: page 63]

6. เปิดใช้โหมดทดสอบส้าหรับฐานข้อมูลแบบเวลาจริง โดยเลือก Start in test mode ดังแสดงใน รูปที่ 3.34

รูปที่ 3.34 การเปิดใช้โหมดทดสอบส้าหรับฐานข้อมูลแบบเวลาจริง

7. ท้าการคัดลอก URL Firebase โดยไปที่ Data ดังแสดงในรูปที่ 3.35

รูปที่ 3.35 การคัดลอก URL Firebase

8. ดาวน์โหลดไลบราลี่ Firebase ส้าหรับ Arduino
9. เพิ่มไลบราลี่ Firebase ใน Arduino
10. เชื่อมต่อ ESP32 เข้ากับฐานข้อมูลออนไลน์ Google Firebase แบบเวลาจริง ดังแสดงในรูปที่ 3.35

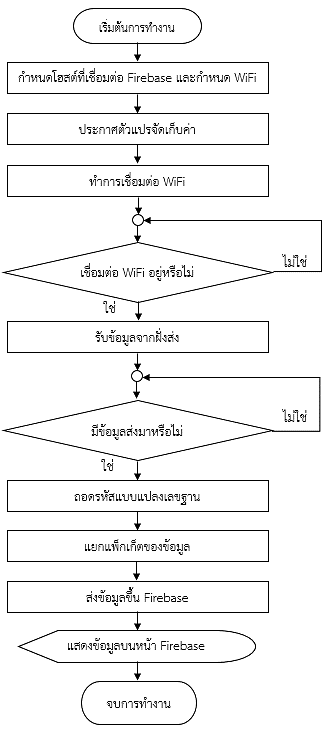
[picture p57: figure]

รูปที่ 3.36 การเชื่อมต่อฐานข้อมูลส้าหรับเก็บข้อมูลแบบเวลาจริง

จากรูปที่ 3.36 เป็นการเชื่อมต่อฐานข้อมูลส้าหรับเก็บข้อมูลแบบเวลาจริง โดยการก้าหนดโฮสต์ที่ เชื่อมต่อกับ Firebase และเลือก WiFi ที่จะใช้เชื่อมต่อ เมื่อได้รับข้อมูลจากฝั่งส่งจะท้าการถอดรหัส และแยก แพ็กเก็ตของข้อมูล จากนั นข้อมูลที่ได้จะแสดงผลบนหน้า Firebase

### 3.6 ออกแบบเว็บไซต์ส้าหรับการแสดงผลแบบเวลาจริง

ท้าการออกแบบเว็บไซต์โดยข้อมูลที่ต้องการแสดงได้แก่ค่า เวลาอุณหภูมิ ค่าความเป็นกรดเป็นด่าง ค่า ความสามารถในการออกซิไดซ์ ต้าแหน่งละติจูด และต้าแหน่งลองจิจูด โดยท้ากรแสดงให้อยู่ในรูปแบบตาราง แสดงผล และกราฟแสดงผล โดยมีขั นตอนการท้างานดังต่อไปนี
1. วางแผนจัดท้าเว็บไซต์
2. การก้าหนดโครงสร้างของเว็บ
3. ออกแบบหน้าเว็บเพจแต่ละหน้า หน้าเว็บเพจที่ท้าการออกแบบได้แก่ HOME DATA LOCATION และ CONTACT ดังแสดงในรูปที่ 3.37-3.41

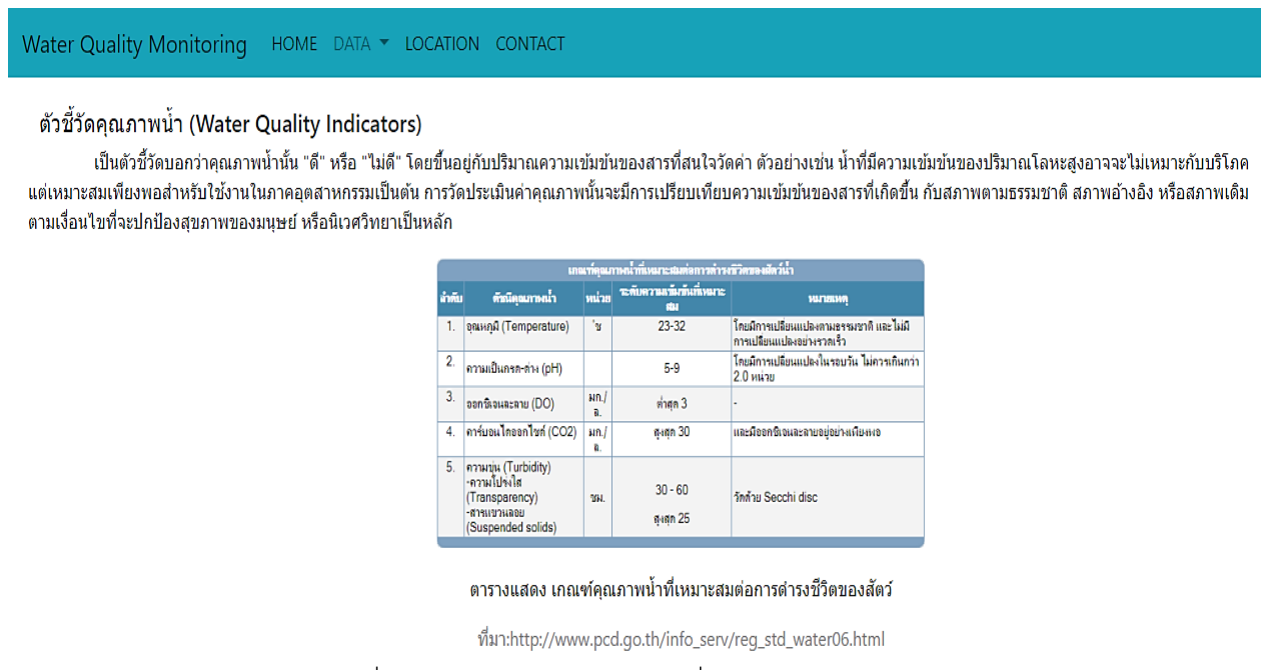
[picture p58: figure]

รูปที่ 3.37 เว็บเพจหน้า HOME ที่ได้ท้าการออกแบบ

จากรูปที่ 3.37 แสดงถึงเว็บเพจหน้า HOME โดยข้อมูลที่แสดงในหน้านี จะกล่าวถึงความหมายของ ตัวชี วัดคุณภาพน ้า ได้แก่ ค่าอุณหภูมิ ค่าความเป็นกรดเป็นด่าง ปริมาณออกซิเจนที่ละลายน ้า และ ความสามารถในการออกซิไดซ์

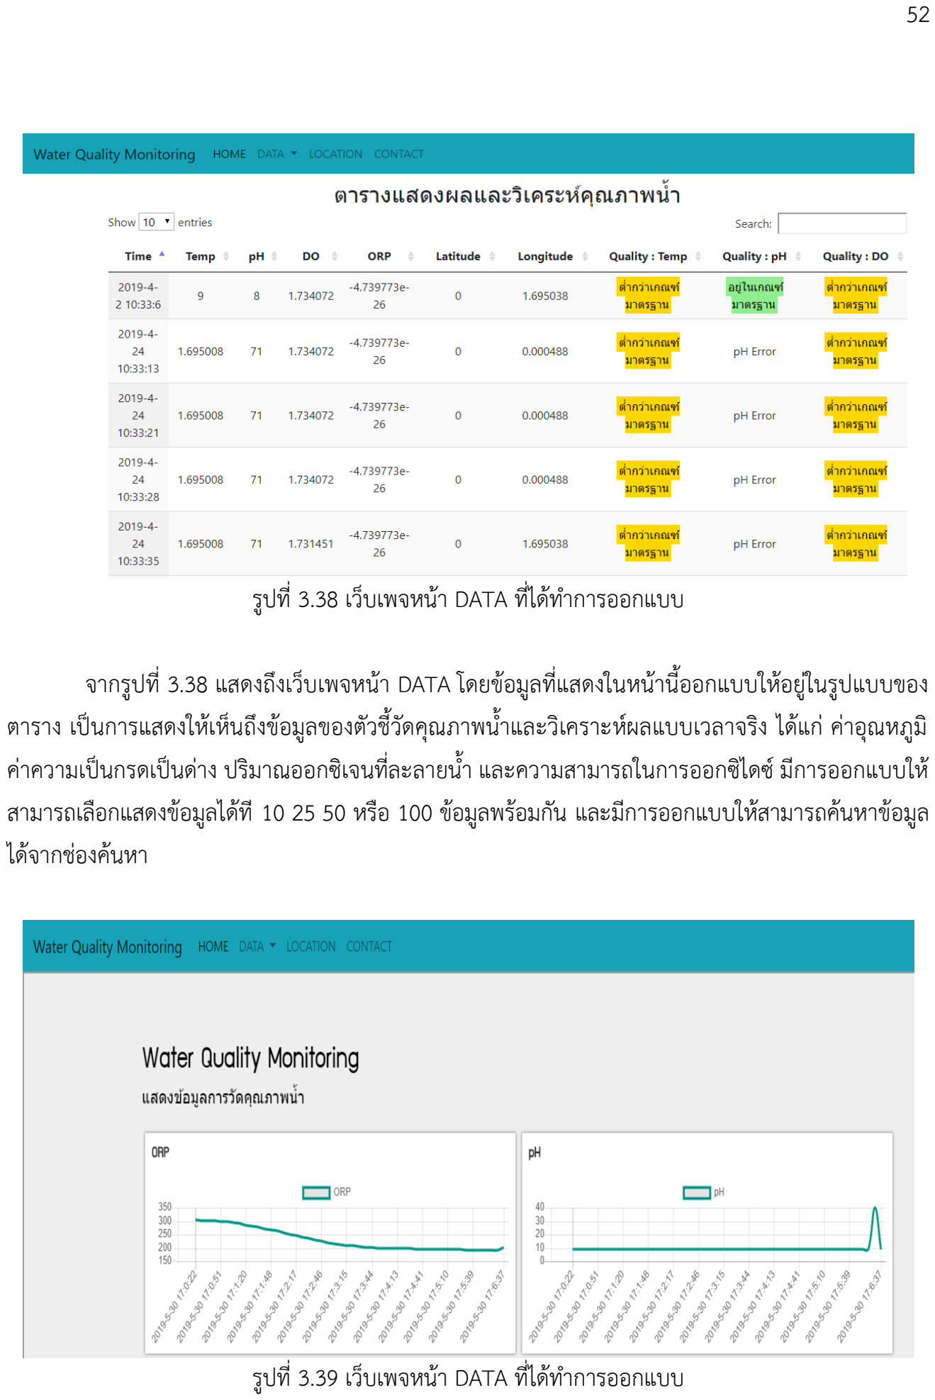
[picture p59: page 66]

รูปที่ 3.38 เว็บเพจหน้า DATA ที่ได้ท้าการออกแบบ

จากรูปที่ 3.38 แสดงถึงเว็บเพจหน้า DATA โดยข้อมูลที่แสดงในหน้านี ออกแบบให้อยู่ในรูปแบบของ ตาราง เป็นการแสดงให้เห็นถึงข้อมูลของตัวชี วัดคุณภาพน ้าและวิเคราะห์ผลแบบเวลาจริง ได้แก่ ค่าอุณหภูมิ ค่าความเป็นกรดเป็นด่าง ปริมาณออกซิเจนที่ละลายน ้า และความสามารถในการออกซิไดซ์ มีการออกแบบให้ สามารถเลือกแสดงข้อมูลได้ที 10 25 50 หรือ 100 ข้อมูลพร้อมกัน และมีการออกแบบให้สามารถค้นหาข้อมูล ได้จากช่องค้นหา

รูปที่ 3.39 เว็บเพจหน้า DATA ที่ได้ท้าการออกแบบ

จากรูปที่ 3.39 แสดงถึงเว็บเพจหน้า DATA โดยข้อมูลที่แสดงในหน้านี ออกแบบให้ในรูปแบบของ กราฟ เป็นการแสดงให้เห็นถึงข้อมูลของตัวชี วัดคุณภาพน ้าแบบเวลาจริง ได้แก่ ค่าอุณหภูมิ ค่าความเป็นกรด เป็นด่าง ปริมาณออกซิเจนที่ละลายน ้า และความสามารถในการออกซิไดซ์

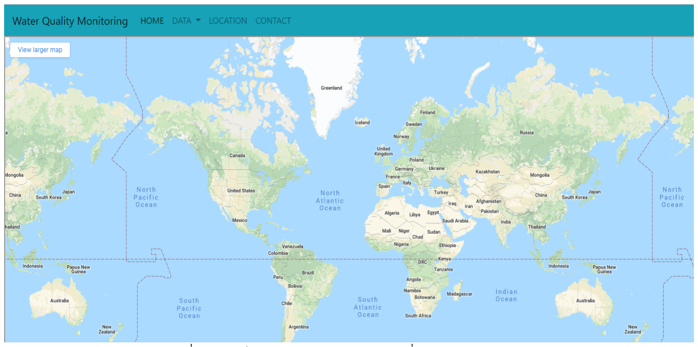
[picture p60: figure]

รูปที่ 3.40 เว็บเพจหน้า LOCATION ที่ได้ท้าการออกแบบ

จากรูปที่ 3.40 แสดงถึงเว็บเพจหน้า LOCATION ซึ่งเป็นการเรียกไฟล์จาก Google Maps มาไว้ที่ หน้าเพจนี เพื่อน้าข้อมูลละติจูด ลองจิจูด ที่ทราบมาค้นหาต้าแหน่งพิกัด

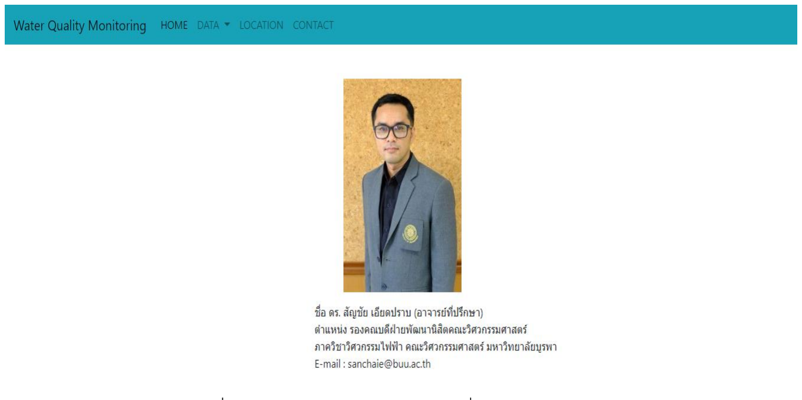
[picture p61: figure]

รูปที่ 3.41 เว็บเพจหน้า CONTACT ที่ได้ท้าการออกแบบ

จากรูปที่ 3.41 แสดงถึงเว็บเพจหน้า CONTACT โดยข้อมูลที่แสดงในหน้านี จะกล่าวถึงประวัติส่วนตัว ของอาจารย์ที่ปรึกษา และประวัติส่วนตัวของผู้จัดท้าปริญญานิพนธ์นี โดยข้อมูลส่วนตัวที่กล่าวถึงได้แก่ ชื่อ นามสกุล ต้าแหน่ง และช่องทางการติดต่อ
4. ก้าหนดการเชื่อมระหว่างเพจ
5. สร้างเว็บเพจในแต่ละหน้าตามที่ออกแบบไว้ด้วยโปรแกรม sublime text 3 ใช้ชุดค้าสั่ง HTML และ CSS ในการเขียน
6. ดึงข้อมูลจากฐานข้อมูล fire base มาที่เว็บไซต์ ใช้ชุดค้าสั่ง JavaScript และเนื่องจากข้อมูลที่ เก็บไว้ใน fire base อยู่ในตัวแปรที่ชื่อว่า childSnapshot ซึ่งตัวแปรนี เป็นข้อมูลที่เก็บไว้ในตัว แปรอื่นอีกที จึงจ้าเป็นต้องท้าการประการตัวทีละขั นเพื่อเข้าถึงข้อมูลใน childSnapshot ตัวแปร ที่ต้องเข้าถึงได้แก่ WATERData key และchildSnapshot ตามล้าดับ ดังแสดงในรูปที่ 3.42

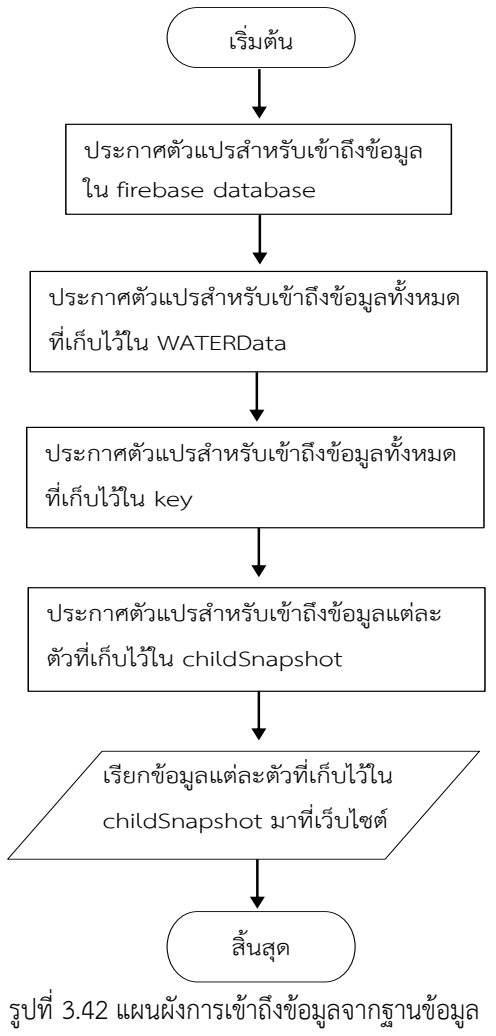
[picture p62: figure]
รูปที่ 3.42 แผนผังการเข้าถึงข้อมูลจากฐานข้อมูล; เรียกข้อมูลแต่ละตัวที่เก็บไว้ใน childSnapshot มาที่เว็บไซต์; ประกาศตัวแปรส้าหรับเข้าถึงข้อมูล ใน firebase database; ประกาศตัวแปรส้าหรับเข้าถึงข้อมูลทั งหมด ที่เก็บไว้ใน WATERData; ประกาศตัวแปรส้าหรับเข้าถึงข้อมูลทั งหมด ที่เก็บไว้ใน key; ประกาศตัวแปรส้าหรับเข้าถึงข้อมูลแต่ละ ตัวที่เก็บไว้ใน childSnapshot

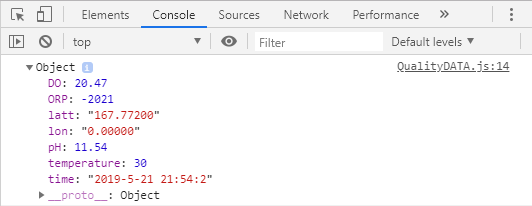
[picture p63: figure]

รูปที่ 3.43 ข้อมูลที่ได้ท้าการเข้าถึงจากฐานข้อมูล

จาก รูปที่ 3.43 แสดงให้เห็นถึงข้อมูลที่ได้เข้าถึงในส่วนของ childSnapshot ซึ่งเป็นข้อมูลทั งหมดที่ เก็บไว้ในฐานข้อมูล firebase โดยจะน้ามาข้อมูลตรงนี มาแสดงผลให้อยู่ในรูปแบบตารางในขั นตอนต่อไป

7. เขียนค้าสั่งจัดแจงข้อมูลใส่ตารางโดยแสดงผลแบบตารางข้อมูลโดยแสดงการท้างานดังรูปที่ 3.44

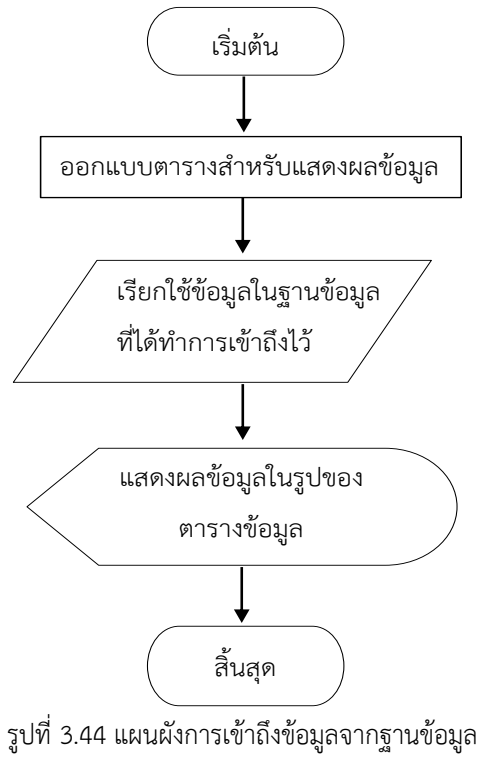
[picture p64: figure]
รูปที่ 3.44 แผนผังการเข้าถึงข้อมูลจากฐานข้อมูล; เรียกใช้ข้อมูลในฐานข้อมูล ที่ได้ท้าการเข้าถึงไว้; ออกแบบตารางส้าหรับแสดงผลข้อมูล; แสดงผลข้อมูลในรูปของ ตารางข้อมูล

8. เขียนค้าสั่งส้าหรับการวิเคราะห์คุณภาพน ้าเพื่อใช้ในการแสดงผลให้เห็นถึงสถานะของคุณภาพน ้า โดยข้อมูลที่น ้ามาวิเคราะห์คือค่าของอุณหภูมิ ค่าความเป็นกรดเป็นด่าง ค่าออกซิเจนที่ละลายน ้า โดยอิงข้อมูลตามเกณฑ์คุณภาพน ้าที่เหมาะสมต่อการด้ารงชีวิตของสัตว์ดังแสดง ดังรูปที่ 3.45– 3.47

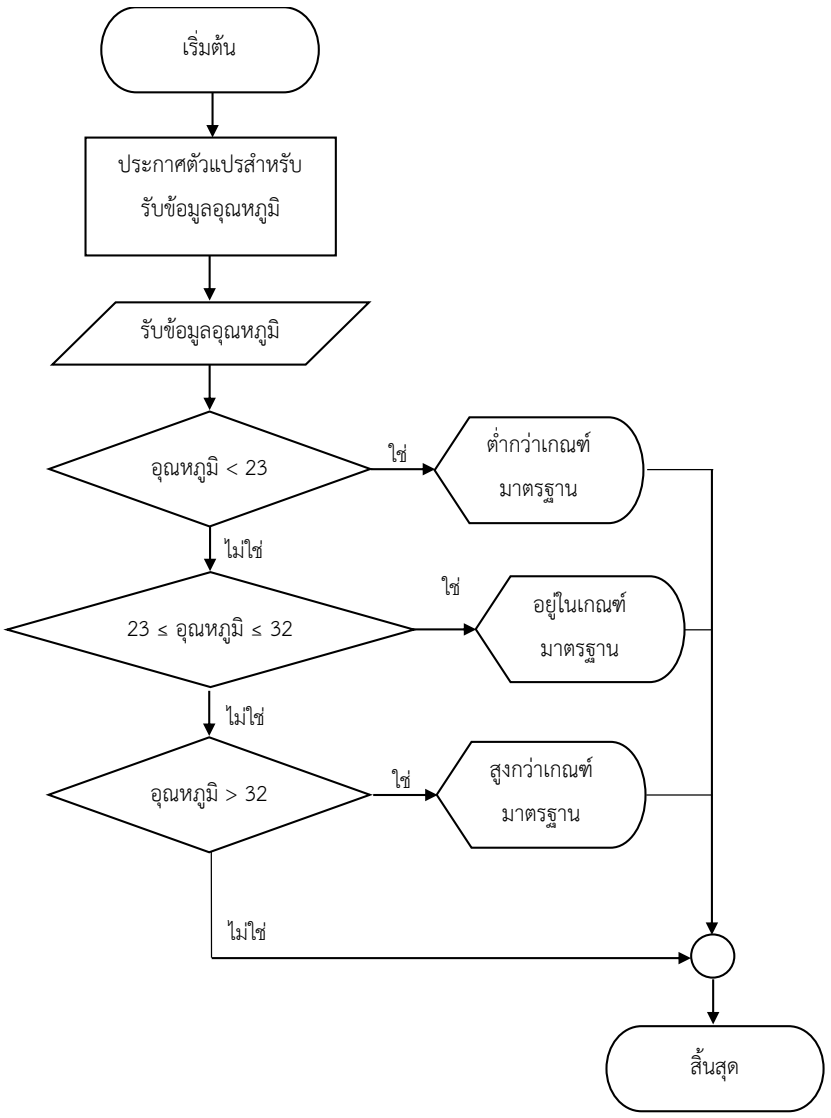
[picture p65: figure]
ประกาศตัวแปรส้าหรับ รับข้อมูลอุณหภูมิ; รับข้อมูลอุณหภูมิ; อุณหภูมิ < 23; 23 ≤ อุณหภูมิ 32; ต่้ากว่าเกณฑ์ มาตรฐาน; อยู่ในเกณฑ์ มาตรฐาน; อุณหภูมิ > 32; สูงกว่าเกณฑ์ มาตรฐาน

รูปที่ 3.45 แผนผังการวิเคราะข้อมูลของอุณหภูมิ

จากรูปที่ 3.45 จะเป็นการวิเคราะข้อมูลของอุณหภูมิ เมื่ออุณหภูมิมีค่าน้อยกว่า 23 องศาเซลเซียล หน้าจอจะแสดงผลว่าต่้ากว่ามาตรฐาน อุณหภูมิมีค่าอยู่ในช่วง 23-32 องศาเซลเซียล หน้าจอจะแสดงผลว่าอยู่ ในมาตรฐาน และถ้าหากอุณหภูมิมีค่ามากกว่า 32 องศาเซลเซียล หน้าจอจะแสดงผลว่าสูงกว่ามาตรฐาน

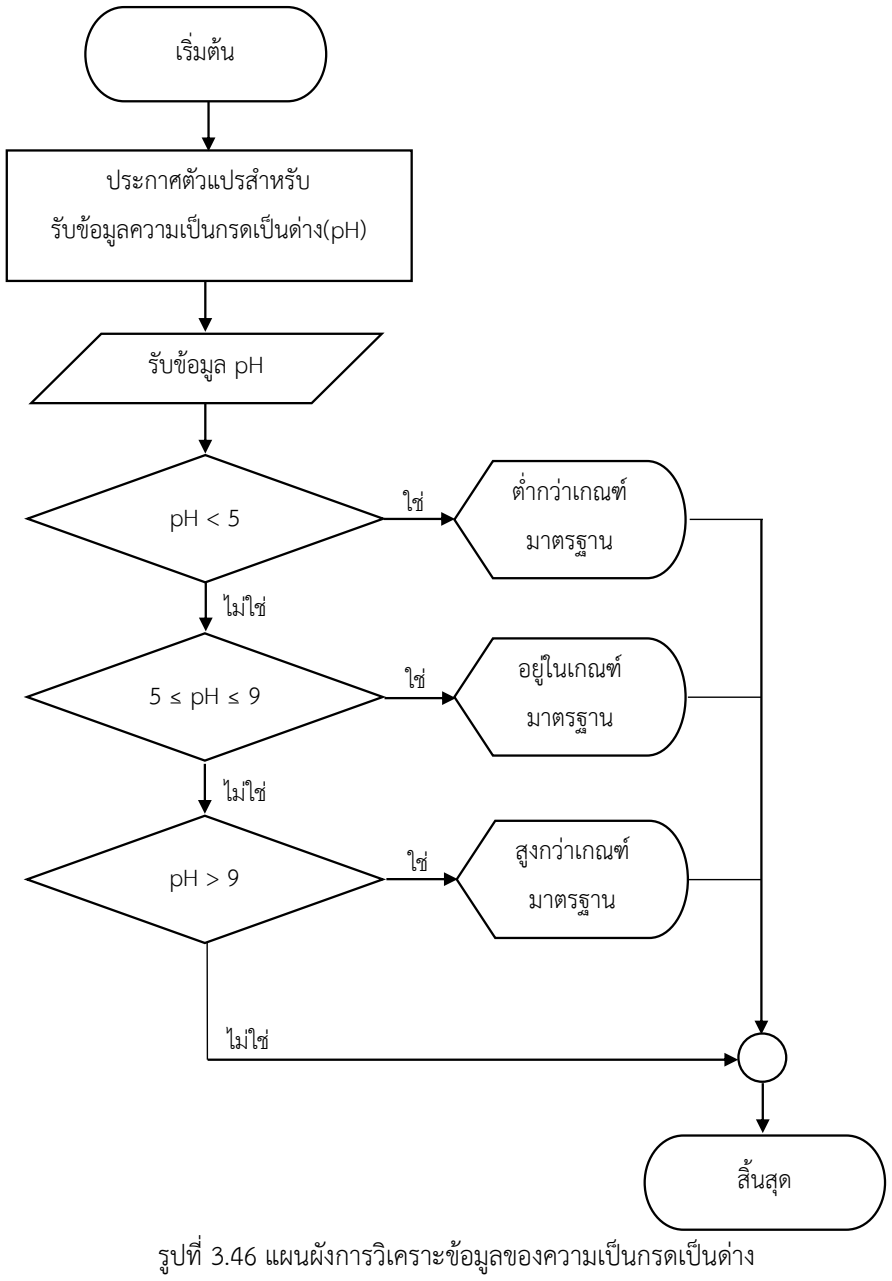
[picture p66: figure]
รูปที่ 3.46 แผนผังการวิเคราะข้อมูลของความเป็นกรดเป็นด่าง; ประกาศตัวแปรส้าหรับ รับข้อมูลความเป็นกรดเป็นด่าง(pH); ต่้ากว่าเกณฑ์ มาตรฐาน; อยู่ในเกณฑ์ มาตรฐาน; สูงกว่าเกณฑ์ มาตรฐาน

จากรูปที่ 3.46 จะเป็นการวิเคราะข้อมูลของความเป็นกรดเป็นด่าง เมื่อความเป็นกรดเป็นด่างมีค่า น้อยกว่า 5 หน้าจอจะแสดงผลว่าต่้ากว่ามาตรฐาน ความเป็นกรดเป็นด่างมีค่าอยู่ในช่วง 5-9 หน้าจอจะแสดงผล ว่าอยู่ในมาตรฐาน และถ้าหากอุณหภูมิมีค่ามากกว่า 9 หน้าจอจะแสดงผลว่าสูงกว่ามาตรฐาน

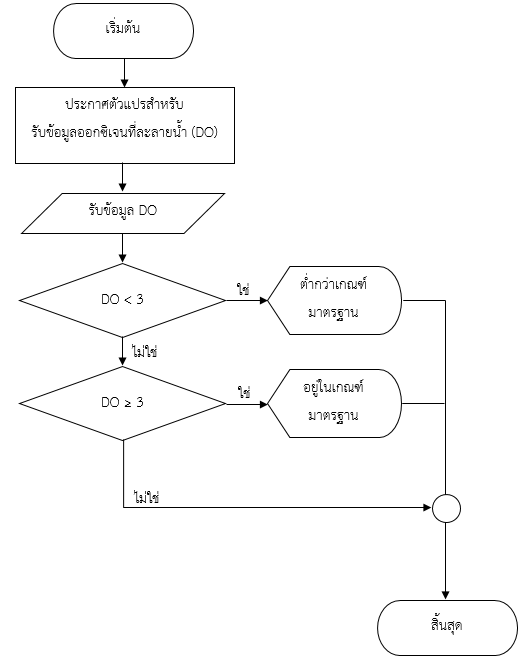
[picture p67: figure]

รูปที่ 3.47 แผนผังการวิเคราะข้อมูลของออกซิเจนที่ละลายน ้า

จากรูปที่ 3.47 จะเป็นการวิเคราะข้อมูลของออกซิเจนที่ละลานน ้า เมื่อออกซิเจนที่ละลานน ้ามีค่าน้อย กว่า 3 mg/l หน้าจอจะแสดงผลว่าต่้ากว่ามาตรฐาน และถ้าหากออกซิเจนที่ละลานน ้ามีค่าตั งแต่ 3 mg/l ขึ นไป หน้าจอจะแสดงผลว่าอยู่ในมาตรฐาน

บทที่ 4
ผลการด้าเนินการโครงงาน

### 4.1 การทดสอบอุปกรณ์ตรวจจับคุณภาพน ้า

ทดสอบอุปกรณ์ตรวจจับคุณภาพน ้า โดยอุปกรณ์ที่ท้าการทดสอบ ได้แก่ อุปกรณ์ตรวจจับคุณภาพน ้า ชนิดวัดความเป็นกรดเป็นด่าง อุปกรณ์ตรวจจับคุณภาพน ้าชนิดวัดอุณหภูมิ อุปกรณ์ตรวจจับคุณภาพน ้าชนิดวัด ความสามารถในการออกซิไดซ์ อุปกรณ์ตรวจจับคุณภาพน ้าชนิดวัดออกซิเจนละลายน ้า โดยอุปกรณ์แต่ละตัว จะมีจ้าเพาะดังแสดงในตารางที่ 4.1

ตารางที่ 4.1 ข้อมูลจ้าเพาะของอุปกรณ์ตรวจจับคุณภาพน ้า

ทดสอบอุปกรณ์ตรวจจับคุณภาพน ้าชนิดวัดความเป็นกรดเป็นด่าง โดยท้าการทดสอบกับสารสอบ เทียบมาตราฐานที่มีค่าความเป็นกรดเป็นด่างที่แตกต่างกันไปจ้านวน 3 ค่า ท้าการทดสอบแต่ละค่าจ้านวน 10 รอบ แล้วหาค่าเฉลี่ยของการทดสอบแต่ละค่า ซึ่งสารสอบเทียบมาตราฐาน จ้านวน 3 ค่า ดังแสดงในตารางที่ 4.2

ตารางที่ 4.2 ผลจากการทดสอบอุปกรณ์ตรวจจับคุณภาพน ้าชนิดวัดความเป็นกรดเป็นด่าง

ตารางที่ 4.2 ผลการทดสอบอุปกรณ์ตรวจจับคุณภาพน ้าชนิดวัดความเป็นกรดเป็นด่าง สรุปได้ว่า เมื่อ ท้าการทดสอบกับสารสอบเทียบมาตราฐานที่มีค่า 4.01 อุปกรณ์จะมีค่าความคลาดเคลื่อนอยู่ที่ร้อยละ 7.48 ทดสอบกับสารสอบเทียบมาตราฐานที่มีค่า 6.86 อุปกรณ์จะมีค่าความคลาดเคลื่อนอยู่ที่ร้อยละ 3.06 และ

อุปกรณ์ | พิสัย | แรงดัน
วัดความเป็นกรดเป็นด่าง | 1 ถึง 14 | 5.0 โวลต์
วัดอุณหภูมิ | 0 ถึง 45 องศาเซลเซียล | 3.3 โวลต์
วัดความสามารถในการออกซิไดซ์ | -1999 ถึง +1999 มิลลิโวลต์ | 5.0 โวลต์
วัดออกซิเจนละลายน ้า | 0 ถึง 20 mg/L | 3.3 โวลต์
ค่ามาตรฐาน | ค่าที่วัดได้ | ความคลาดเคลื่อน (ร้อยละ)
4.01 | 3.71 | 7.48
6.86 | 6.65 | 3.06
9.18 | 9.02 | 1.74

ทดสอบกับสารสอบเทียบมาตราฐานที่มีค่า 9.18 อุปกรณ์จะมีค่าความคลาดเคลื่อนอยู่ที่ร้อยละ 1.74 ดังนั น อุปกรณ์ตรวจจับคุณภาพน ้าชนิดวัดความเป็นกรดเป็นด่างมีค่าความคลาดเคลื่อนอยู่ที่ร้อยละ 1.74-7.48

ทดสอบอุปกรณ์ตรวจจับคุณภาพน ้าชนิดวัดอุณหภูมิโดยท้าการทดสอบกับน ้าประปาที่อุณหภูมิ แตกต่างกันไปจ้านวน 5 ค่า ท้าการทดสอบแต่ละค่าจ้านวน 10 รอบ แล้วหาค่าเฉลี่ยของการทดสอบแต่ละค่า ซึ่งอุณหภูมิของน ้าประปาที่ท้าการทดสอบ จ้านวน 5 ค่า ได้แก่ 5 องศาเซลเซียส 25 องศาเซลเซียส 35 องศา เซลเซียส 50 องศาเซลเซียส และ 80 องศาเซลเซียส ดังแสดงในตารางที่ 4.3

ตารางที่ 4.3 ผลจากการทดสอบอุปกรณ์ตรวจจับคุณภาพน ้าชนิดวัดอุณหภูมิ

ตารางที่ 4.3 ผลจากการทดสอบอุปกรณ์ตรวจจับคุณภาพน ้าชนิดวัดอุณหภูมิสรุปได้ว่า เมื่อท้าการ ทดสอบกับน ้าประปาที่อุณหภูมิ 5 องศาเซลเซียส อุปกรณ์จะมีค่าความคลาดเคลื่อนอยู่ที่ร้อยละ 12 ทดสอบกับ น ้าประปาที่อุณหภูมิ 25 องศาเซลเซียส อุปกรณ์จะมีค่าความคลาดเคลื่อนอยู่ที่ร้อยละ 1.2 ทดสอบกับ น ้าประปาที่อุณหภูมิ 35 องศาเซลเซียส อุปกรณ์จะมีค่าความคลาดเคลื่อนอยู่ที่ร้อยละ 1.429 ทดสอบกับ น ้าประปาที่อุณหภูมิ 50 องศาเซลเซียส อุปกรณ์จะมีค่าความคลาดเคลื่อนอยู่ที่ร้อยละ 2 และทดสอบกับ น ้าประปาที่อุณหภูมิ 80 องศาเซลเซียส อุปกรณ์จะมีค่าความคลาดเคลื่อนอยู่ที่ร้อยละ 0.875 ดังนั นอุปกรณ์ ตรวจจับคุณภาพน ้าชนิดวัดอุณหภูมิมีค่าความคลาดเคลื่อนอยู่ที่ร้อยละ 0.875-12

ทดสอบอุปกรณ์ตรวจจับคุณภาพน ้าชนิดวัดความสามารถในการออกซิไดซ์ โดยท้าการทดสอบกับ ประเภทของน ้าที่แตกต่างกันไปจ้านวน 2 ประเภท ท้าการทดสอบกับน ้าแต่ละประเภทจ้านวน 10 รอบ แล้วหา ค่าเฉลี่ยของการทดสอบแต่ละค่า น ้า 2 ประเภทที่ท้าการทดสอบ ได้แก่ น ้าดื่ม และน ้าประปา ดังแสดงในตาราง ที่ 4.4

เทอร์โมมิเตอร์(องศาเซลเซียส) | เซนเซอร์ (องศาเซลเซียส) | ความคลาดเคลื่อน (ร้อยละ)
5 | 4.40 | 12
25 | 24.70 | 1.2
35 | 34.50 | 1.429
50 | 50.20 | 2
80 | 79.30 | 0.875

ตารางที่ 4.4 ผลจากการทดสอบอุปกรณ์ตรวจจับคุณภาพน ้าชนิดวัดความสามารถในการออกซิไดซ์

ตารางที่ 4.4 ผลจากการทดสอบอุปกรณ์ตรวจจับคุณภาพน ้าชนิดวัดความสามารถในการออกซิไดซ์ สรุปได้ว่า เมื่อท้าการทดสอบกับน ้าประเภทน ้าดื่มค่าความสามารถในการออกซิไดซ์ที่วัดได้คือ 318 มิลลิโวลต์ และเมื่อทดสอบกับน ้าประเภทน ้าประปาค่าความสามารถในการออกซิไดซ์ที่วัดได้คือ 402 มิลลิโวลต์แสดงให้ เห็นว่าค่าความสามารถในการออกซิไดซ์ที่วัดได้นั นมีค่าแตกต่างจากค่ามาตรฐานของน ้าในแต่ละประเภท ดังนั น อุปกรณ์ตรวจจับคุณภาพน ้าชนิดวัดความสามารถในการออกซิไดซ์มีค่าความคลาดเคลื่อน

ทดสอบอุปกรณ์ตรวจจับคุณภาพน ้าชนิดวัดออกซิเจนที่ละลายน ้า โดยท้าการทดสอบกับประเภทของ น ้าที่แตกต่างกันไปจ้านวน 3 ประเภท ท้าการทดสอบกับน ้าแต่ละประเภทจ้านวน 10 รอบ แล้วหาค่าเฉลี่ยของ การทดสอบแต่ละค่า น ้า 3 ประเภทที่ท้าการทดสอบ ได้แก่ โซดาไฟ น ้าดื่ม และน ้าประปา ดังแสดงในตารางที่ 4.5

ตารางที่ 4.5 ผลจากการทดสอบอุปกรณ์ตรวจจับคุณภาพน ้าชนิดวัดออกซิเจนละลายน ้า

ตารางที่ 4.5 ผลจากการทดสอบอุปกรณ์ตรวจจับคุณภาพน ้าชนิดวัดออกซิเจนละลายน ้า สรุปได้ว่า เมื่อท้าการทดสอบกับน ้าประเภทโซดาไฟ อุปกรณ์จะมีค่าความคลาดเคลื่อนอยู่ที่ร้อยละ 1.44 ทดสอบกับน ้า ประเภทน ้าดื่มค่าออกซิเจนละลายน ้าที่วัดได้คือ 5.12 mg/L ทดสอบกับน ้าประเภทน ้าประปาค่าออกซิเจน ละลายน ้าที่วัดได้คือ 4.23 mg/L แสดงให้เห็นว่าอุปกรณ์ตรวจจับคุณภาพน ้าชนิดวัดออกซิเจนละลายน ้า สามารถวัดค่าออกซิเจนละลายน ้าในแต่ละประเภทของน ้าได้ค่าที่แตกต่างกันออกไป

จากผลการสอบเทียบของอุปกรณ์ตรวจจับคุณภาพน ้าแต่ละชนิดจะเห็นว่าอุปกรณ์มีค่าความผิดพลาด และจากการใช้งานไปสักระยะหนึ่ง มีปัญหาเกิดขึ นไม่สามารถวัดค่าได้ หรืออุปกรณ์บางตัวท้างานได้ไม่เต็ม ประสิทธิภาพ อันเนื่องมาจากการเก็บรักษาหัววัดเป็นสิ่งส้าคัญ ก่อนการเก็บอุปกรณ์ควรมีการท้าความสะอาด

ประเภทของน ้า | ค่ามาตรฐาน (มิลลิโวลต์) | ค่าที่วัดได้(มิลลิโวลต์)
น ้าดื่ม | 200-300 | 318
น ้าประปา | 400 | 402
ประเภทของน ้า | ค่ามาตรฐาน ( mg/L) | ค่าที่วัดได้( mg/L) | ความคลาดเคลื่อน (ร้อยละ)
โซดาไฟ | 8.32 | 8.20 | 1.44
น ้าดื่ม | - | 5.12 | -
น ้าประปา | - | 4.23 | -

และเช็ดให้แห้งทุกครั งหลังใช้งาน โดยไม่ปล่อยให้หัววัดแห้ง ควรใส่น ้ายารักษาหัววัดเพื่อป้องการแห้งของหัววัด เพื่อยืดเวลาในการใช้งานให้มากขึ น

### 4.2 การทดสอบระยะทางที่สามารถรับส่งข้อมูลของเทคโนโลยีลอร่า

จากการทดสอบระยะทางที่สามารถรับส่งข้อมูลผ่านเทคโนโลยีลอร่าส่งข้อมูลโดยการเคลื่อนที่ บอร์ดลอร่าส้าหรับภาคส่ง และให้บอร์ดลอร่าภาครับอยู่ ณ สวนสาธารณะหาดวอนนภา โดยไม่มีการเคลื่อนที่ ผลที่ได้คือ เทคโนโลยีลอร่าสามารถรับส่งข้อมูลแบบแพ็กเก็ตที่มีค่าวัดความเป็นกรดเป็นด่าง ค่าอุณหภูมิ ค่า ความสามารถในการออกซิไดซ์ และค่าปริมาณออกซิเจนละลายน ้าถึงกัน ในระยะ 4.47 กิโลเมตร ในพื นที่ ๆมี สิ่งกีดขวาง ณ สถานที่ จากสวนสาธารณะหาดวอนนภา ไปจนถึงถนนคนเดินบางแสน จังหวัดชลบุรี

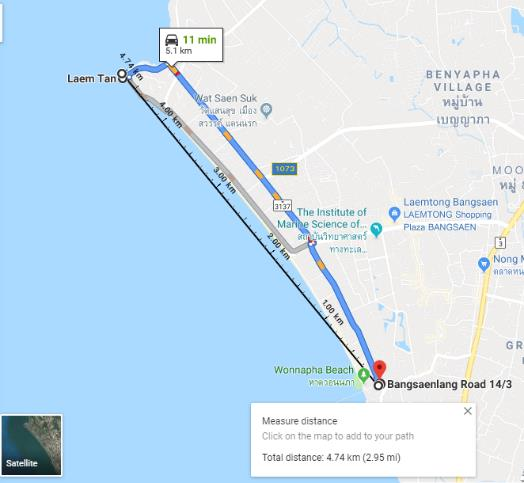
[picture p68: figure]

รูปที่ 4.1 ระยะทางที่สามารถรับส่งข้อมูลผ่านเทคโนโลยีลอร่า

จากการออกแบบข้อมูลแบบแพ็กเก็ตเพื่อท้าการส่งข้อมูลผ่านเทคโนโลยีลอร่า สามารถส่งข้อมูล ทั งหมด 6 ค่า ได้แก่ ความเป็นกรดเป็นด่าง อุณหภูมิ ปริมาณออกซิเจนที่ละลายน ้า และความสามารถในการ ออกซิไดซ์ ละติจูด และลองจิจูด ดังแสดงในรูปที่ 4.2

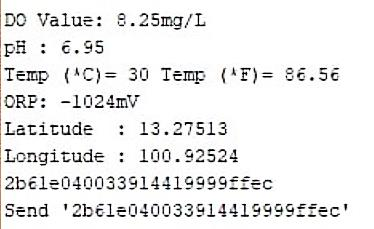
[picture p69: figure]

รูปที่ 4.2 ข้อมูลทางเทคโนโลยีลอร่าภาคส่ง

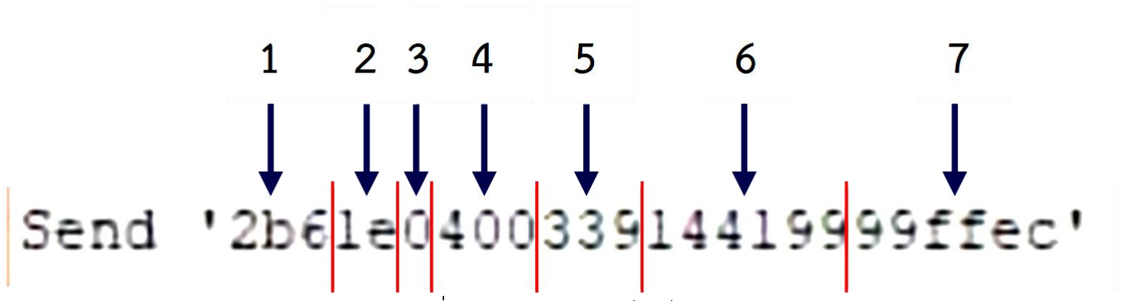
[picture p70: figure]

รูปที่ 4.3 ข้อมูลแบบแพ็กเก็ต

จากรูปที่ 4.3 แสดงให้เห็นถึงการส่งข้อมูลแบบแพ็กเก็ตในรูปแบบเลขฐานสิบหก โดยข้อมูลชุดแรก ค่าที่ได้ ค่า 2b6 แปลงเป็นเลขฐานสิบ คือ 7.02 เป็นข้อมูลของค่าความเป็นกรดเป็นด่าง ข้อมูลชุดที่ 2 ค่า le แปลงเป็นเลขฐานสิบ คือ 14 เป็นข้อมูลของค่าอุณหภูมิ ข้อมูลชุดที่ 3 ค่า 0 เท่ากับค่าลบ คือ ค่าบวกหรือลบ ของข้อมูลความสามารถในการออกซิไดซ์ โดยก้าหนดให้ 0 เป็นค่าลบ และ 1 เป็นค่าบวก ข้อมูลชุดที่ 4 ค่า 400

แปลงเป็นเลขฐานสิบ คือ 1024 เป็นข้อมูลของค่าความสามารถในการออกซิไดซ์ ข้อมูลชุดที่ 5 ค่า 339 แปลง เป็นเลขฐานสิบ คือ 8.25 เป็นข้อมูลของค่าปริมาณออกซิเจนละลายน ้า ข้อมูลชุดที่ 6 ค่า 144199 แปลงเป็น เลขฐานสิบ คือ 13.27513 เป็นข้อมูลของค่าละติจูด และข้อมูลชุดสุดท้าย ค่า 99ffec แปลงเป็นเลขฐานสิบ คือ 100.92524 เป็นข้อมูลของค่าลองจิจูด

ตารางที่ 4.6 ความสัมพันธ์ของระยะทาง และสัญญาณในการรับส่งข้อมูลผ่านเทคโนโลยีลอร่า

จากตารางที่ 4.6 แสดงให้เห็นถึงความสัมพันธ์ของระยะทาง และสัญญาณในการรับส่งข้อมูลผ่าน เทคโนโลยีลอร่า ณ สวนสาธารณะหาดวอนนภา ถึง ถนนคนเดินบางแสน โดยทั่วไปแล้วค่าความไวในการรับ สัญญาณจะมีค่าต่้ากว่าศูนย์ซึ่งจะมีค่าเป็นค่าลบ ดังนั นค่าที่ -8 dBm จะมีความไวในการรับสัญญาณมากกว่า -120 dBm ซึ่งจะเห็นได้ว่าเมื่อระยะทางไกลขึ นสัญญาณการรับส่งผ่านเทคโนโลยีลอร่าเริ่มอ่อนลง เนื่องจากมี

ระยะทาง (km) | ความไวในการ รับสัญญาณ (dBm) | สรุปผล
เริ่มต้น | -8 | รับส่งข้อมูลได้รวดเร็วเนื่องจากมีความไวของสัญญาณที่ดีเยี่ยม
0.5 | -75 | รับส่งข้อมูลได้รวดเร็วเนื่องจากมีความไวของสัญญาณที่ดี
1 | -91 | รับส่งข้อมูลได้รวดเร็วเนื่องจากมีความไวของสัญญาณที่พอใช้
1.5 | -98 | รับส่งข้อมูลได้รวดเร็วเนื่องจากมีความไวของสัญญาณที่พอใช้
2 | -103 | รับส่งข้อมูลได้รวดเร็วเนื่องจากมีความไวในการรับส่งที่ปาน กลาง
2.5 | -110 | รับส่งข้อมูลได้รวดเร็วเนื่องจากมีความไวในการรับส่งที่ปาน กลาง
3 | -115 | รับส่งเริ่มช้าลงเนื่องจากสถานที่อับสัญญาณ และความไวของ สัญญาณลดลง
3.5 | -117 | รับส่งข้อมูลเริ่มช้าลง และค่าเริ่มผิดพลาด เนื่องจากความไวของ สัญญาณลดลง
4 | -119 | รับส่งข้อมูลเริ่มช้าลง และค่าเริ่มผิดพลาด เนื่องจากความไวของ สัญญาณลดลง
4.5 | -120 | รับส่งข้อมูลเริ่มช้าลง และค่าเริ่มผิดพลาด เนื่องจากความไวของ สัญญาณลดลง
5 | -120 | หยุดการส่งข้อมูล

สิ่งกีดขวางที่ไม่สามารถเลี่ยงได้ ณ สถานที่นั น จึงท้าให้ผลในการรับส่งไม่เสถียร จึงเล็งเห็นว่าหากต้องการส่ง ข้อมูลที่ระยะไกลกว่านี ควรทดลองในที่ที่มีพื นที่โล่งแจ้งไม่มีสิ่งกีดขวาง จึงจะส่งผลต่อประสิทธิภาพการส่งข้อมูล ระยะไกลที่ดี แต่เนื่องจากการส่งข้อมูลในพื นที่ไม่มีสิ่งกีดขวางนั นเป็นไปได้ยากด้วยสภาพแวดล้อมของสถานที่ นั น ๆ และได้ผลสรุปส้าหรับการส่งข้อมูลผ่านเทคโนโลยีลอร่าที่บริเวณระหว่างสวนนันทนาการ มหาวิทยาลัย บูรพา ซึ่งมีระยะทาง 475.95 เมตร ที่วัดจากการระบุพิกัดต้าแหน่งในระยะทางแบบการกระจัด โดยมีค่าความ ไวในการรับสัญญาณ อยู่ที่ - 110 dBm ถือว่าเป็นค่าที่ยังอยู่ในระยะการรับ-ส่งข้อมูล

### 4.3 ทดสอบการวัดคุณภาพน ้า

ท้าการทดสอบการวัดคุณภาพน ้าทั งหมด 3 ต้าแหน่ง คือ บริเวณตอนต้นของสระ กลางสระ และ ท้ายสระของสวนนันทนาการ มหาวิทยาลัยบูรพา โดยสภาพแวดล้อมของต้นสระมีต้นไม้กีดขวางในการส่งข้อมูล แต่เนื่องจากภาครับอยู่ใกล้กับต้นสระเพียง 22.11 เมตร จึงสามารถส่งข้อมูลได้อย่างมีประสิทธิภาพที่วัดจาก ความแรงของสัญญาณ ส่วนสภาพแวดล้อมของกลางสระมีต้นไม้สูง และตึกกีดขวางการส่งข้อมูล และเนื่องจาก กลางสระเริ่มมีระยะทางที่ไกลขึ น คือ 205.15 เมตร ท้าให้ความแรงในการส่งข้อมูลลดลงจากภาครับ และ สุดท้ายสภาพแวดล้อมของท้ายสระมีต้นไม้สูงมากมาย และตึกที่บดบังการส่งข้อมูล และเนื่องจากท้ายสระเริ่มมี ระยะทางที่ไกลขึ น คือ 460.20 เมตร ท้าให้ความแรงในการส่งข้อมูลลดลงจากภาครับไปมาก การส่งข้อมูลเริ่มมี ประสิทธิภาพที่ไม่ดี ดังแสดงในรูปที่ 4.4–4.6 พบว่าค่าคุณภาพน ้าทั ง 3 ต้าแหน่งมีค่าที่แตกต่างกันไป ดังแสดง ในรูปที่ 4.7-4.9

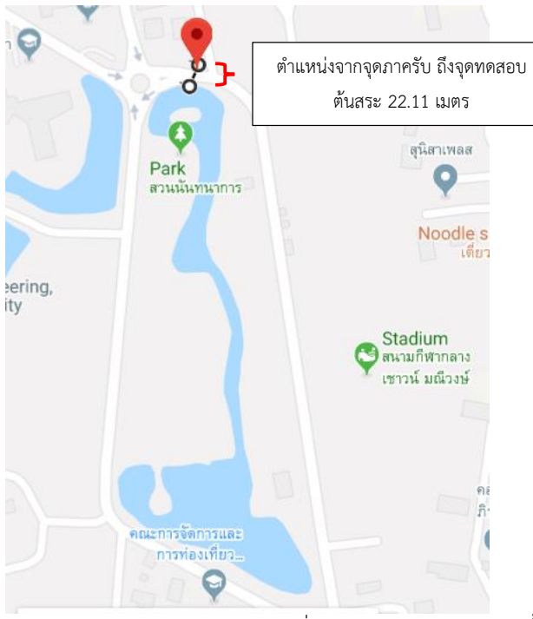
[picture p71: figure]
ต้าแหน่งจากจุดภาครับ ถึงจุดทดสอบ ต้นสระ 22.11 เมตร

รูปที่ 4.4 ต้าแหน่งบริเวณตอนต้นของสระที่ท้าการทดสอบวัดคุณภาพน ้า

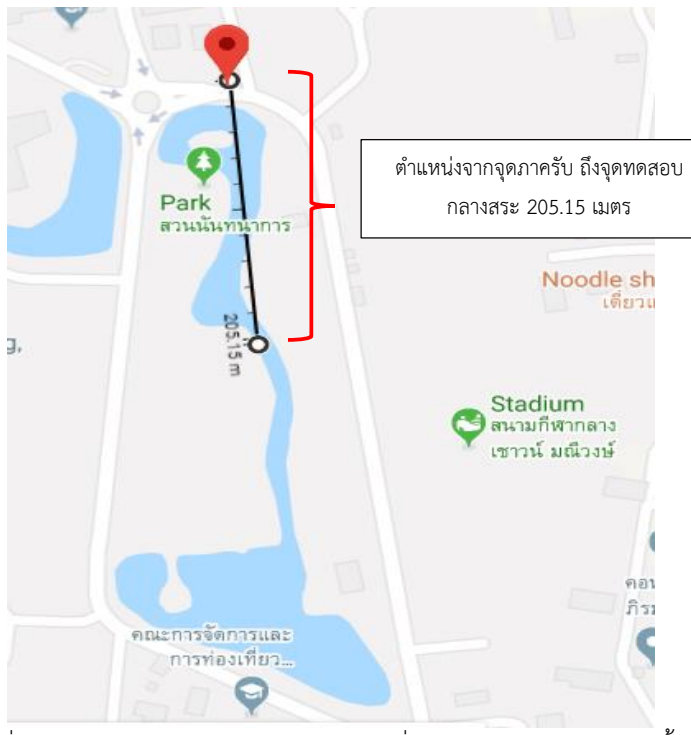
[picture p72: figure]
ต้าแหน่งจากจุดภาครับ ถึงจุดทดสอบ กลางสระ 205.15 เมตร

รูปที่ 4.5 ต้าแหน่งบริเวณตอนกลางของสระที่ท้าการทดสอบวัดคุณภาพน ้า

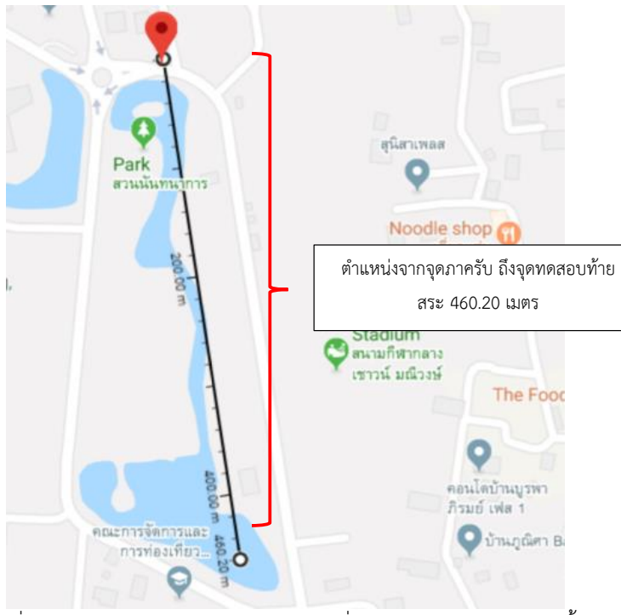
[picture p73: figure]
ต้าแหน่งจากจุดภาครับ ถึงจุดทดสอบท้าย สระ 460.20 เมตร

รูปที่ 4.6 ต้าแหน่งบริเวณตอนท้ายของสระที่ท้าการทดสอบวัดคุณภาพน ้า

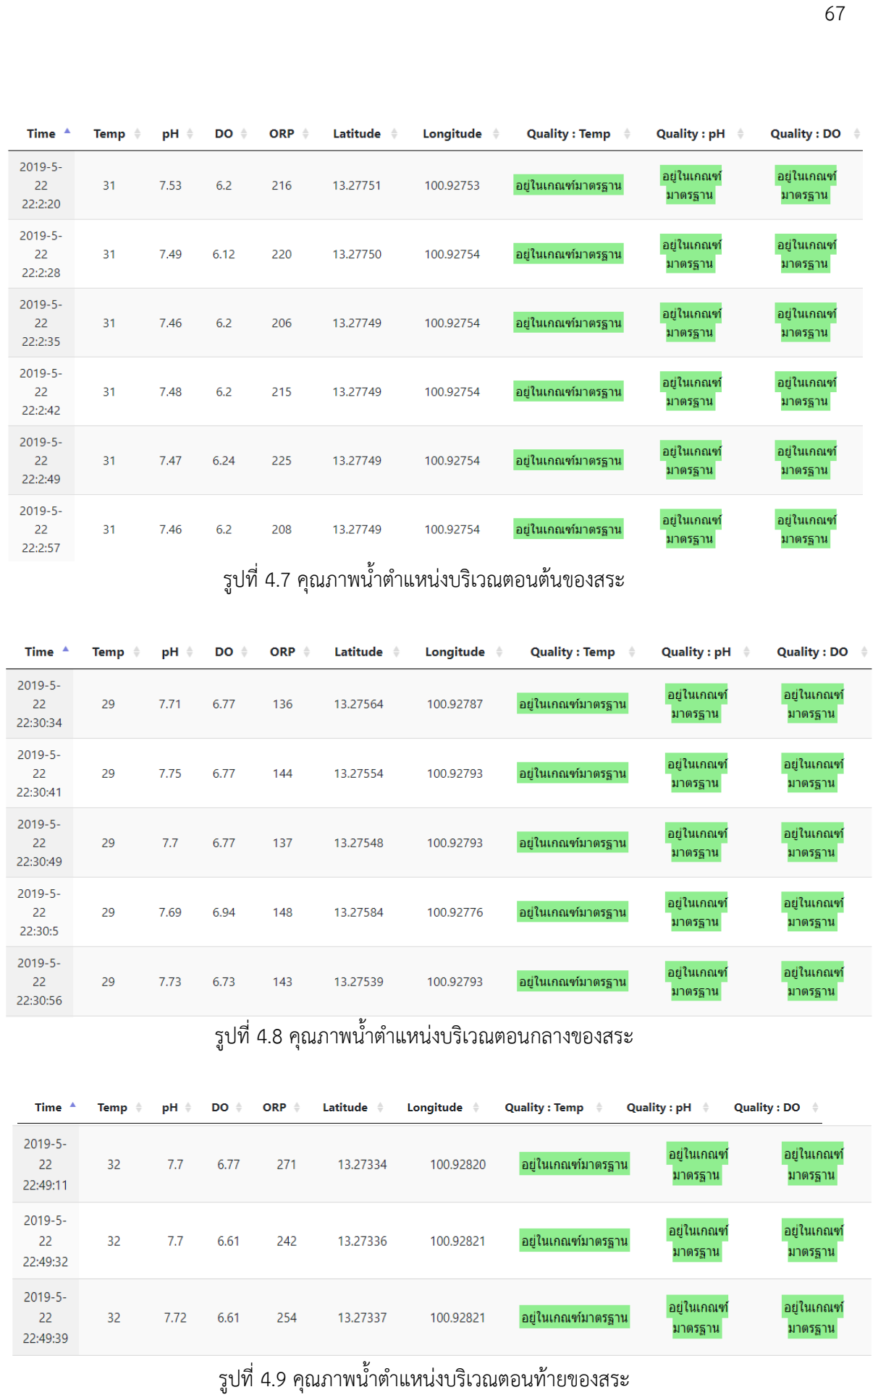
[picture p74: page 81]

รูปที่ 4.7 คุณภาพน ้าต้าแหน่งบริเวณตอนต้นของสระ

รูปที่ 4.8 คุณภาพน ้าต้าแหน่งบริเวณตอนกลางของสระ

รูปที่ 4.9 คุณภาพน ้าต้าแหน่งบริเวณตอนท้ายของสระ

จากรูปที่ 4.7-4.9 แสดงให้เห็นถึงผลการวัดคุณภาพน ้าทั ง 3 ต้าแหน่ง ได้แก่ ต้าแหน่งบริเวณตอนต้น ของสระ ต้าแหน่งบริเวณตอนกลางของสระ และ ต้าแหน่งบริเวณตอนท้ายของสระ มีค่าคุณภาพน ้าที่แตกต่าง กันไป โดยต้าแหน่งบริเวณตอนต้นของสระ มีค่าอุณหภูมิเฉลี่ยอยู่ที่ 31 องศาเซลเซียส ค่าความเป็นกรดเป็น กรดเป็นด่างเฉลี่ยอยู่ที่ 7.48 ค่าออกซิเจนละลายน ้าเฉลี่ยอยู่ที่ 6.19 mg/L และค่าความสามารถสามารถในการ ออกซิไดซ์เฉลี่ยอยู่ที่ 215 มิลลิโวลต์ต้าแหน่งบริเวณตอนกลางของสระ มีค่าอุณหภูมิเฉลี่ยอยู่ที่ 29 องศา เซเซียส ค่าความเป็นกรดเป็นกรดเป็นด่างเฉลี่ยอยู่ที่ 7.72 ค่าออกซิเจนละลายน ้าเฉลี่ยอยู่ที่ 6.80 mg/L และ ค่าความสามารถสามารถในการออกซิไดซ์เฉลี่ยอยู่ที่ 141.6 มิลลิโวลต์และต้าแหน่งบริเวณตอนท้ายของสระ มี ค่าอุณหภูมิเฉลี่ยอยู่ที่ 32 องศาเซลเซียส ค่าความเป็นกรดเป็นกรดเป็นด่างเฉลี่ยอยู่ที่ 7.71 ค่าออกซิเจนละลาย น ้าเฉลี่ยอยู่ที่ 6.66 mg/L และค่าความสามารถสามารถในการออกซิไดซ์เฉลี่ยอยู่ที่ 255.67 มิลลิโวลต์จะเห็น ได้ว่าค่าคุณภาพภาพน ้า ณ ช่วงเวลาที่ท้าการทดสอบ แต่ละต้าแหน่งของสระจะมีค่าที่แตกต่างกันไป แต่ โดยรวมคุณภาพน ้าแต่ละต้าแหน่งยังอยู่ในเกณฑ์มาตรฐาน

### 4.4 ทดสอบการลอยตัวอยู่บนผิวน ้าของโครงสร้าง

ท้าการปล่อยทุ่นวัดคุณภาพน ้าให้ลอยน ้าในบริเวณสระน ้าของสวนนนันทนาการ มหาวิทยาลัยบูรพา เป็นเวลา 15 วัน จะเห็นว่าทุ่นวัดคุณภาพน ้าสามารถลอยตัวอยู่บนผิวน ้าใช้งานได้จริง ดังแสดงในรูปที่ 4.10 และเมื่อท้าการปล่อยทุ่นวัดคุณภาพน ้าทิ งไว้นานมากกว่า 5 วัน จะเห็นได้ว่าตัวทุ่นลอยน ้าเริ่มมีคราบของตะไตร่ น ้าติดอยู่ ดังแสดงในรูปที่ 4.11 และตัวอุปกรณ์วัดคุณภาพน ้า มีคราบของตะไคร่น ้าติดอยู่บริเวณตัวอุปกรณ์ ดัง แสดงในรูปที่ 4.12 และบริเวณหน้าผิวสัมผัสของอุปกรณ์ ดังแสดงในรูปที่ 4.13

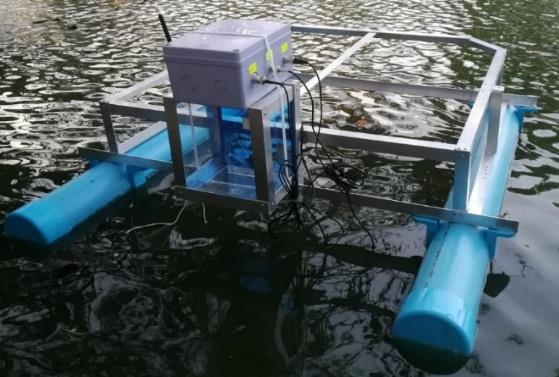
[picture p75: figure]

รูปที่ 4.10 การทดสอบการลอยตัวอยู่บนผิวน ้าของโครงสร้าง

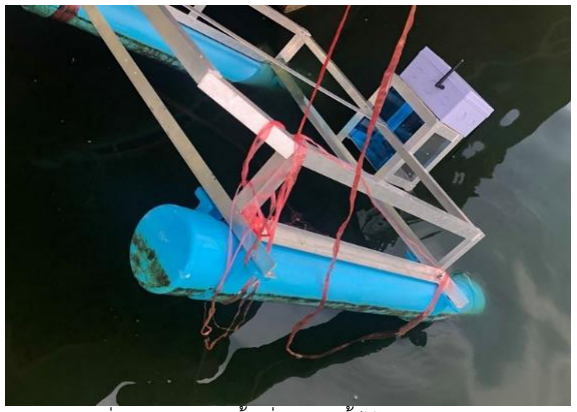
[picture p76: figure]

รูปที่ 4.11 ทุ่นลอยน ้าเมื่อปล่อยทิ งไว้มากกว่า 5 วัน

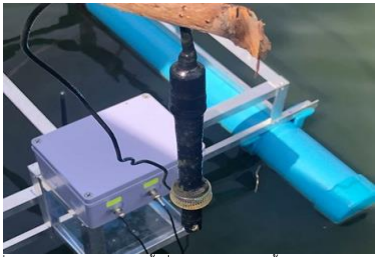
[picture p77: figure]

รูปที่ 4.12 อุปกรณ์วัดคุณภาพน ้าที่มีคราบของตะไคร้น ้าติดบริเวณตัวอุปกรณ์

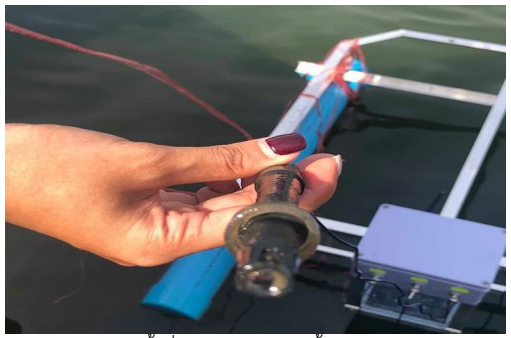
[picture p78: figure]

รูปที่ 4.13 อุปกรณ์วัดคุณภาพน ้าที่มีคราบของตะไคร้น ้าติดบริเวณหน้าผิวสัมผัสของอุปกรณ์

### 4.5 ทดสอบการเก็บข้อมูลไว้ในฐานข้อมูล

หลังจากการทดสอบข้อมูลไว้ในฐานข้อมูล Firebase แบบเวลาจริง จะมีชุดข้อมูลที่ฝั่งส่งส่งมา ณ เวลานั น ๆ ที่ท้าการเก็บไว้ในฐานข้อมูล ดังรูปที่ 4.14 โดยข้อมูลที่ท้าการเก็บจะอยู่ในรูปแบบของชุดข้อมูล ซึ่ง ภายภายในชุดข้อมูลจะมีค่าปริมาณออกซิเจนละลายน ้า ความสามารถในการออกซิไดซ์ ละติจูด ลองจิจูด ความเป็นกรดเป็นด่าง อุณหภูมิ และวันเวลาที่ได้รับข้อมูลจากฝั่งส่ง ดังรูปที่ 4.15

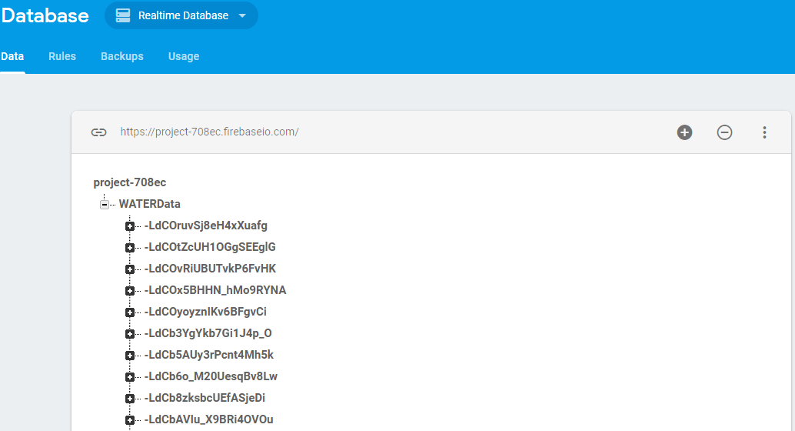
[picture p79: figure]

รูปที่ 4. 14 การเก็บข้อมูลในลักษณะชุดข้อมูล ณ เวลานั น ๆ

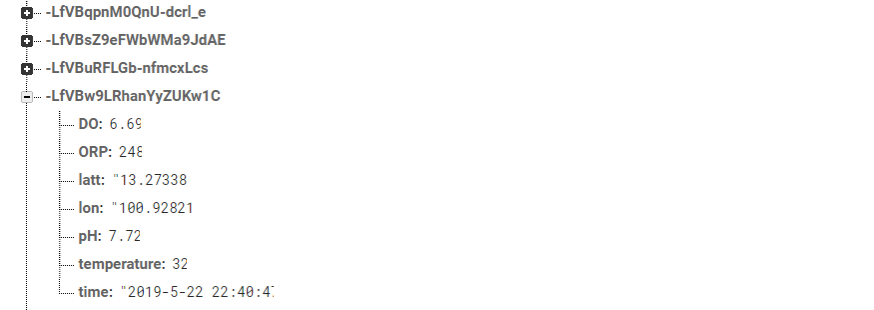
[picture p80: figure]

รูปที่ 4.15 ข้อมูลที่ท้าการเก็บไว้ในฐานข้อมูล

### 4.6 ทดสอบการแสดงผลและวิเคราะห์ผลบนหน้าเว็บไซต์

การแสดงผลผ่านหน้าเว็บไซต์จะมีด้วยกัน 2 แบบ คือการแสดงในผลรูปแบบของตาราง และแสดงผล ในรูปแบบของกราฟ ซึ่งการแสดงผลในรูปแบบของตารางจะมีการแสดงผลที่แน่ชัด เห็นได้ชัดเจน สามารถ ค้นหา และย้อนดูข้อมูลย้อนหลังได้ทั งยังมีการวิเคราะห์ผลข้อมูลของคุณภาพน ้าในแต่ละค่า ดังแสดงในรูปที่ 4.16 ส่วนการแสดงผลในรูปแบบของกราฟจะแสดงให้เห็นถึงแนวโน้มของคุณภาพน ้าในแต่ละค่าในช่วงเวลานั น ดังแสดงผลในรูปที่ 4.17

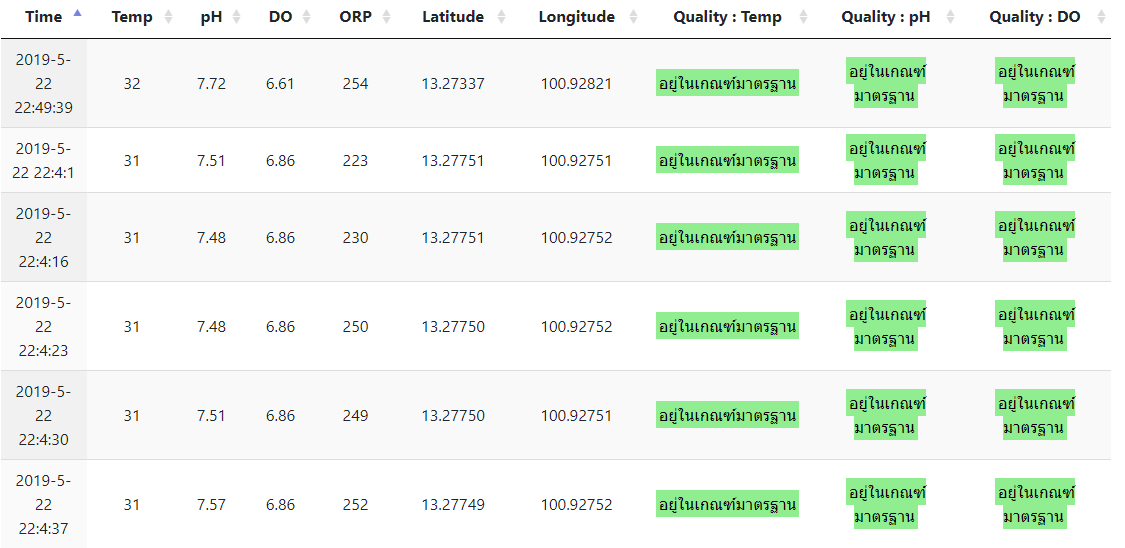
[picture p81: figure]

รูปที่ 4.16 ข้อมูลและการวิเคราะห์ผลคุณภาพน ้าในรูปแบบตาราง

จากรูปที่ 4.16 เป็นการแสดงผลให้เห็นถึงข้อมูลคุณภาพน ้าที่อยู่ในรูปแบบของตาราง โดยข้อมูล ที่แสดงได้แก่ วันและเวลาที่ท้าการวัดคุณภาพน ้า ค่าอุณหภูมิ ค่าความเป็นกรดเป็นด่าง ค่าออกซิเจนที่ละลาย น ้า ค่าความสามารถในการออกซิไดซ์ ค่าต้าแหน่งละติจูด และค่าต้าแหน่งลองจิจูด นอกจากนี ยังมีการแสดงให้ เห็นถึงผลการวิเคราะห์คุณภาพ ได้แก่ ผลการณ์วิเคราะห์อุณหภูมิ ผลการวิเคราะห์ค่าความเป็นกรดเป็นด่าง และผลการวิเคราะห์ค่าออกซิเจนที่ละลายน ้า ซึ่งหากค่าคุณภาพน ้าแต่ละค่ามีผลการวิเคราะห์ที่ต่้ากว่าเกณฑ์ อ้างอิง จะแสดงข้อความว่า ต่้ากว่าเกณฑ์มาตรฐานและมีพื นหลังข้อความเป็นสีเหลือง หากค่าคุณภาพน ้าแต่ละ ค่ามีผลการวิเคราะห์ที่สูงกว่าเกณฑ์อ้างอิง จะแสดงข้อความว่า สูงกว่าเกณฑ์มาตรฐานและมีพื นหลังข้อความ เป็นสีแดง และหากค่าคุณภาพน ้าแต่ละค่ามีผลการวิเคราะห์ที่อยู่ในเกณฑ์อ้างอิง จะแสดงข้อความว่า อยู่ใน เกณฑ์มาตรฐานและมีพื นหลังข้อความเป็นสีเขียว ซึ่งคุณภาพน ้าที่บริเวณสระน ้าของสวนนนันทนาการ มหาวิทยาลัยบูรพา มีเกณฑ์คุณภาพน ้าในแต่ละค่าอยู่ในเกณฑ์อ้างอิง คืออยู่ในเกณฑ์มาตรฐาน ซึ่งเกณฑ์ที่ เลือกใช้อิงตามเกณฑ์คุณภาพน ้าที่เหมาะสมต่อการด้ารงชีวิตของสัตว์อ้างอิงจากกรมควบคุมมลพิษ กระทรวง ทรัพยากรธรรมชาติและสิ่งแวดล้อม

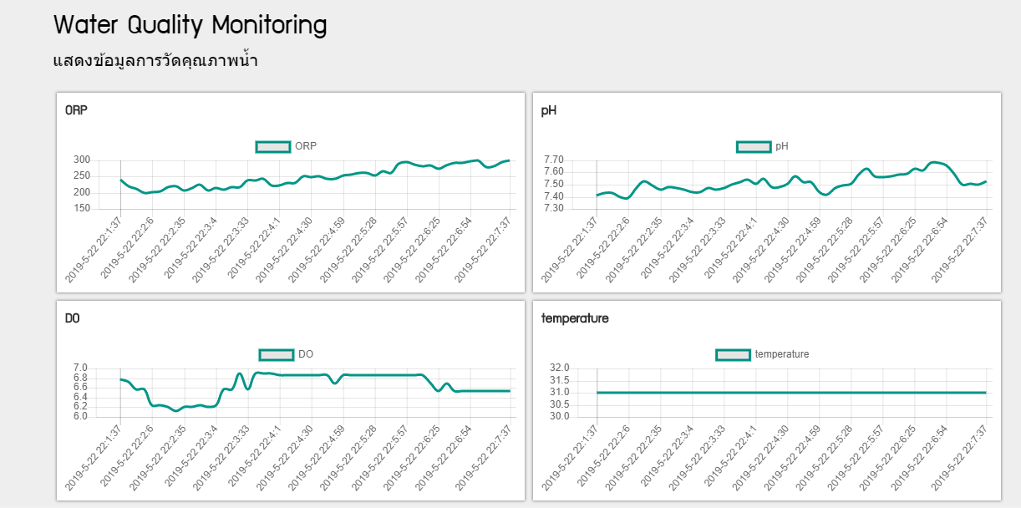
[picture p82: figure]

รูปที่ 4.17 ข้อมูลคุณภาพน ้าในรูปแบบกราฟ

จากรูปที่ 4.17 เป็นการแสดงผลให้เห็นถึงข้อมูลคุณภาพน ้าที่อยู่ในรูปแบบของกราฟ โดยแบ่งเป็น ทั งหมด 4 กราฟ ได้แก่ กราฟแสดงอุณหภูมิ กราฟแสดงความเป็นกรดเป็นด่าง กราฟแสดงออกซิเจนที่ละลาย กราฟแสดงความสามารถในการออกซิไดซ์ ซึ่งข้อมูลที่แสดงไว้ในกราฟได้แก่ วันและเวลาที่ท้าการวัดคุณภาพน ้า จะแสดงอยู่ในแนวแกนนอน ค่าคุณภาพน ้าจะแสดงอยู่ในแนวแกนตั ง

บทที่ 5
สรุปผลการด้าเนินโครงงาน และข้อเสนอแนะ

การจัดท้าโครงงานเรื่องระบบเซนเซอร์ส้าหรับติดตามคุณน ้าภาพโดยการใช้เทคโนโลยีลอร่า มี จุดประสงค์ เพื่อศึกษาเกี่ยวกับการวัดคุณภาพน ้าโดยใช้เซนเซอร์ทางด้านสิ่งแวดล้อม การสร้างเครือข่าย เซนเซอร์ไร้สายโดยใช้เทคโนโลยีลอร่า การเลือกใช้โปรโตคอลในการรับส่งข้อมูลให้เหมาะสม และการติดตาม หรือระบุต้าแหน่งของอุปกรณ์โดยใช้หลักการการระบุต้าแหน่งบนพื นโลก เพื่อออกแบบและสร้างเครือข่าย เซนเซอร์ไร้สายโดยใช้เทคโนโลยีลอร่า และท้าการวิเคราะห์คุณภาพน ้าและแสดงผลข้อมูลแบบเวลาจริง

### 5.1 สรุปผลการด้าเนินโครงงาน

โครงงานนี เป็นการสร้างระบบเซนเซอร์ส้าหรับติดตามคุณน ้าภาพโดยการใช้เทคโนโลยีลอร่า อุปกรณ์ ส้าหรับการวัดคุณภาพน ้าโดยใช้เซนเซอร์ทางด้านสิ่งแวดล้อม 4 ตัว ได้แก่ เซนเซอร์วัดค่าอุณหภูมิ เซนเซอร์วัด ความเป็นกรดเป็นด่าง เซนเซอร์วัดออกปริมาณออกซิเจนที่ละลายน ้า และเซนเซอร์วัดความสามารถในการ ออกซิไดซ์ ส้าหรับแผนการด้าเนินงานจะเริ่มต้นตั งแต่ศึกษากระบวนการท้างานของเทคโนโลยีลอร่า การ ท้างานของฐานข้อมูล การท้างานของเว็บไซต์ และรวบรวมข้อมูลเกี่ยวกับค่าดัชนีของคุณภาพน ้าที่จ้าเป็นต่อ การใช้ในงาน เพื่อออกแบบระบบเซนเซอร์ส้าหรับติดตามคุณน ้าภาพโดยการใช้เทคโนโลยีลอร่าให้เหมาะสมต่อ การใช้งาน จากนั นเริ่มท้าการเขียนค้าสั่งส้าหรับ รับ-ส่งเทคโนโลยีลอร่า โดยใช้โปรแกรม Arduino เป็น เครื่องมือสั่งงานไมโครคอรโทรลเลอร์ส้าหรับใช้ติดต่อสื่อสาร และใช้ Firebase ในการจัดการฐานข้อมูล รวมถึง ออกแบบหน้าเว็บไซต์ที่ช่วยแสดงผลข้อมูลคุณภาพน ้า และท้าการวิเคราะห์คุณภาพน ้าให้เหมาะสมตาม มาตรฐานคุณภาพน ้า เมื่อท้าการเขียนโปรแกรมเสร็จหมดเรียบร้อยแล้ว จะท้าการทดลองผลระบบเซนเซอร์ ส้าหรับติดตามคุณน ้าภาพโดยการใช้เทคโนโลยีลอร่า เพื่อตรวจสอบการท้างานของโปรแกรมอย่างละเอียด เพื่อ หาข้อผิดพลาดที่เกิดขึ นแล้วท้าการแก้ไขข้อผิดพลาด พร้อมทั งตรวจสอบผลลัพธ์ต่าง ๆ ว่าถูกต้องตาม วัตถุประสงค์ที่ก้าหนดไว้ซึ่งเมื่อเสร็จสิ นทุกกระบวนการสามารถทราบถึงค่าของคุณภาพน ้าและวิเคราะห์ข้อมูล ได้จริง ซึ่งท้าให้ประหยัดเวลา และสะดวกมากขึ น
จากการท้าการทดสอบคุณภาพน ้าบริเวณสวนนันทนาการ มหาวิทยาลัยบูรพา ด้วยระบบเซนเซอร์ ทางด้านสิ่งแวดล้อมส้าหรับติดตามคุณน ้าภาพโดยการใช้เทคโนโลยีลอร่า พบว่า ระยะการรับส่งข้อมูลด้วย เทคโนโลยีลอร่า จะอยู่ที่ ประมาณ 0-5 กิโลเมตร และความถูกต้องของข้อมูลคุณภาพน ้าจะขึ นอยู่กับคุณภาพ และประสิทธิภาพของอุปกรณ์ที่ท้าการวัดคุณภาพน ้า ส้าหรับค่าคุณภาพน ้าบริเวณส่วนนันทนาการทั ง 3 ต้าแหน่ง มีค่าที่แตกต่างกันไป แต่โดยภาพรวมแล้วมีค่าอยู่ในเกณฑ์มาตรฐาน ซึ่งเกณฑ์ที่เลือกใช้อิงตามเกณฑ์ คุณภาพน ้าที่เหมาะสมต่อการด้ารงชีวิตของสัตว์อ้างอิงจากกรมควบคุมมลพิษ กระทรวงทรัพยากรธรรมชาติ และสิ่งแวดล้อม

### 5.2 ปัญหา และอุปสรรคที่พบ

1) ผลจากการรับข้อมูลที่ตัวรับเกิดค่าความผิดพลาดเนื่องจากเกิดการลดทอนของสัญญาณ และค่า ความแรงลดลง ที่ระยะทางที่ไกลขึ นในพื นที่ที่ไม่ใช่ที่โล่งแจ้ง
2) สายไฟหลวมท้าให้อุปกรณ์ไม่มีความเสถียรในการใช้งาน
3) อุปกรณ์วัดคุณภาพน ้าบางตัวเมื่อใช้งานไประยะหนึ่ง เกิดความเสียหายเนื่องจากการเก็บรักษาที่ ผิดวิธี
4) เมื่อท้าการปล่อยทุ่นวัดคุณภาพน ้าให้ลอยน ้าไว้เป็นเวลานานเกิน 5 วัน ตัวทุ่นและอุปกรณ์ส้าหรับ วัดคุณภาพน ้าจะเกิดคราบตะไคร่น ้า

### 5.3 ข้อเสนอแนะ

1) ระยะการรับส่งข้อมูล ควรอยู่ในระยะ 0-3 กิโลเมตร เนื่องจากเป็นระยะการรับส่งข้อมูลที่รวดเร็ว และเกิดความผิดพลาดของข้อมูลน้อย
2) เช็คสายไฟ และท้าการต่อสายไฟให้แน่นก่อนน้าไปใช้จริง
3) หลังการใช้งานควรมีการท้าความสะอาดอุปกรณ์ และเช็ดให้แห้งทุกครั งหลังใช้งาน โดยไม่ปล่อย ให้หัววัดแห้ง ควรใส่น ้ายารักษาหัววัดเพื่อป้องการแห้งของหัววัด เพื่อยืดเวลาในการใช้งานให้มาก ขึ น
4) ควรทดสอบเทียบอุปกรณ์ทุกชนิดก่อนใช้งาน และควรท้าการสอบเทียบให้ถูกต้องถูกวิธี

### 5.4 สิ่งที่ได้จากการทดลอง

1) ได้เรียนรู้เกี่ยวกับเทคโนโลยีลอร่าส้าหรับการรับ-ส่งข้อมูล
2) สามารถใช้โปรแกรม Arduino ในการรับ-ส่งข้อมูลผ่านเทคโนโลยีลอร่า
3) สามารถการจัดการฐานข้อมูลโดยใช้ firebase
4) สามารถออกแบบ และพัฒนาเว็บไซต์ส้าหรับการแสดงผลข้อมูลแบบเวลาจริง
5) ได้เรียนรู้การท้างาน การวางแผนอย่างเป็นระบบ และการท้างานเป็นทีม
6) เรียนรู้ถึงปัญหา และข้อผิดพลาด และสามารถน้าไปประยุกต์แก้ไขในงานต่อไป

เอกสารอ้างอิง

เกร็ดความรู้.net. (2559). Protocol คืออะไร มีกี่ประเภท ประโยชน์ของ Protocol มีอะไรบ้าง, 24 กันยายน 2561. https://www.xn--12cg1cxchd0a2gzc1c5d5a.net/protocol/ (https://www.เกร็ดความรู้.net/protocol/)
จิรัฎฐ์ พงษ์ทองเมือง. (2558). หลักการสร้างเว็บ, 10 มกราคม 2562. https://www.gotoknow.org/posts/190393 (https://www.gotoknow.org/posts/%09190393)
ชไลเวท พิพัฒพรรณวงศ์. (2561). มาสร้าง Dashboard ด้วย Excel กันเถอะครับ เพื่อชีวิตที่ง่ายขึ น, 26 พฤศจิกายน 2561. https://www.9experttraining.com/about-us
ณัฐพงศ์ สุวรรณรัตน์. (2560). Web Server Xampp คืออะไร, 17 พฤษภาคม 2562. https://sites.google.com/a/satunatc.ac.th/kar-srang-websit-sux-kar-sxn/bthkhwam/details/webserverxam ppkhuxxari
บริษัท เลกะ คอร์ปอเรชั่น จ้ากัด. ORP คืออะไร และเหตุใด ORP จึงมีความส้าคัญ, 15 มกราคม 2562. https://legatool.com/wp/1835/
ปรีชา ก่อเจริญ. (2560). เทคโนโลยีสื่อสารไร้สายส้าหรับอินเทอร์เน็ตของสรรพสิ่ง. วารสารราชการ กสทช. ประจ้าปี, 2560(1), 207-287.
พลชัย พิทักษานนท์กุล. (2561). ระบบฐานข้อมูล (Database System), 26 พฤศจิกายน 2561. http://www.glurgeek.com/education/
วรินดา นวนกัน. (2561). ฐานข้อมูล (Database), 25 เมษายน 2562. https://sites.google.com/site/thekhnoloyisarsnthesit/xngkh-prakxb-khxng-thekhnoloyi-sarsnthes/
วิกิพีเดีย สารานุกรมเสรี. (2561). อุณหภูมิ, 23 มกราคม 2562. https://th.wikipedia.org/wiki/สาขาวิทยาศาสตร์สิ่งแวดล้อมโลก (GLOBE) สถาบันส่งเสริมการสอนวิทยาศาสตร์และเทคโนโลยี. (2561). การ ตรวจวัดพีเอชน ้า(ความเป็นกรดเป็นด่าง), 24 กันยายน 2561. http://globethailand.ipst.ac.th/?page_id=3994 (http://globethailand.ipst.ac.th/%09?page_id=3994)
สาขาวิทยาศาสตร์สิ่งแวดล้อมโลก (GLOBE) สถาบันส่งเสริมการสอนวิทยาศาสตร์และเทคโนโลยี. (2561). การตรวจวัดออกซิเจนที่ละลายน ้า (DISSOLVED OXYGEN: ปริมาณออกซิเจนละลายน ้า), 24 กันยายน 2561. http://globethailand.ipst.ac.th/?page_id=3931 สาขาวิทยาศาสตร์สิ่งแวดล้อมโลก (GLOBE) สถาบันส่งเสริมการสอนวิทยาศาสตร์และเทคโนโลยี. (2561). การตรวจวัดอุณหภูมิ (TEMPERATURE) ของน ้า, 24 กันยายน 2561. http://globethailand.ipst.ac.th/?page_id=3983
สิทธิณี สิมลา. (2562). ภาษาส้าหรับการสร้างเว็บไซต์, 10 มกราคม 2562. https://sites.google.com/site/klumtee10/home/phasa-sahrab-kar-srang-web
อดิศร ขาวสังข์. (2561). เทคโนโลยี NB-IoT กับ LoRa™ อันไหนดีกว่ากัน, 18 พฤษภาคม 2562. http://sorn-mit.blogspot.com/2018/02/nb-iot-lora.html

เอกสารอ้างอิง (ต่อ)

Aphano. (2560). Internet of Things : LoRa LoRaWAN NB-IoT eMTC, 18 พ ฤ ษ ภ า ค ม 2562. http://www.electoday.com/index.php?topic=16159.0
Arduinoall. (2561). #1 LoRa Arduino ESP8266 ESP32 IoT อะไรคือ LoRa ใช้งาน LoRa อย่างไร, 26 พฤศจิกายน 2561. https://www.arduinoall.com/article/136/
Chang. (2562). ESP32 และ Node32s, 10 มกราคม 2562. http://www.ayarafun.com/2016/11/introduction-node32s/
Firebase. (2560). Add Firebase to your JavaScript project, 10 มกราคม 2562. https://firebase.google.com/docs/web/setup?authuser=0
Github. (2560). TTGO-T-Beam, 10 มกราคม 2562. https://github.com/LilyGO/TTGO-T-Beam. Global5 Co., Ltd. (2549). ความรู้ทั่วไปเกี่ยวกับ GPS, 26 พฤศจิกายน 2561. https://www.global5thailand.com/thai/
IT manage office. (2558). ตั งค่า QOS, 20 พฤษภาคม 2562. https://itmanageoffice.wordpress.com/tag/qos-คืออะไร/
Jirawatee. (2559). Security Rules, 10 มกราคม 2562. https://medium.com/firebasethailand/Jirawatee. (2559). Firebase Realtime Database, 10 มกราคม 2562. https://medium.com/firebasethailand/ (https://medium.com/firebase%09thailand/)
Kritsada Arjchariyaphat. (2561). LoRA, LoRaWAN, 26 พฤศจิกายน 2561. https://medium.com/deaware/ (https://medium.com/%09deaware/)
Krok. (2562). RSSI, 18 พฤษภาคม 2562. https://dict.drkrok.com/rssi/
Narupon Srisantitham. (2560). Const ใน Javascript, 10 มกราคม 2562. https://konoesite.com/PoundXI. (2560). Raspberry Pi คืออะไร, 26 พฤศจิกายน 2561. https://poundxi.com/
Sakul Montha. (2560). Grafana คืออะไร, 10 มกราคม 2562. https://medium.com/@iamgique/Sonntag. (2561). ESP32 TTGO, 10 มกราคม 2562. http://esp32-ttgo.blogspot.com
SpryMedia Ltd. (2560). Responsive integration, 25 เมษายน 2562. https://datatables.net/extensions/fixedheader/examples/integration/responsive-bootstrap.html
Techplayon. (2561). classes, 18 พฤษภาคม 2562. http://www.techplayon.com/lora-long-range-end-อุปกรณ์-classifications-class-class-b-class-c/
Thaiall. (2560). Packet คืออะไร, 20 พฤษภาคม 2562. https://www.mindความเป็นกรดเป็นด่างp.com/คู่มือ/73-คืออะไร/2284-packet-คืออะไร.html (https://www.mindความเป็นกรดเป็นด่างp.com/%09คู่มือ/73-คือ)
W3. (2560). Bootstrap Tables, 25 เมษายน 2562. https://www.w3schools.com/bootstrap/bootstrap_tables.asp (https://www.w3schools.com/bootstrap/boot%09strap_tables.asp)

เอกสารอ้างอิง (ต่อ)

W3. (2552). JavaScript if else and else if, 20 มกราคม 2562.https://www.w3schools.com/js/js_if_else.asp

ภาคผนวก

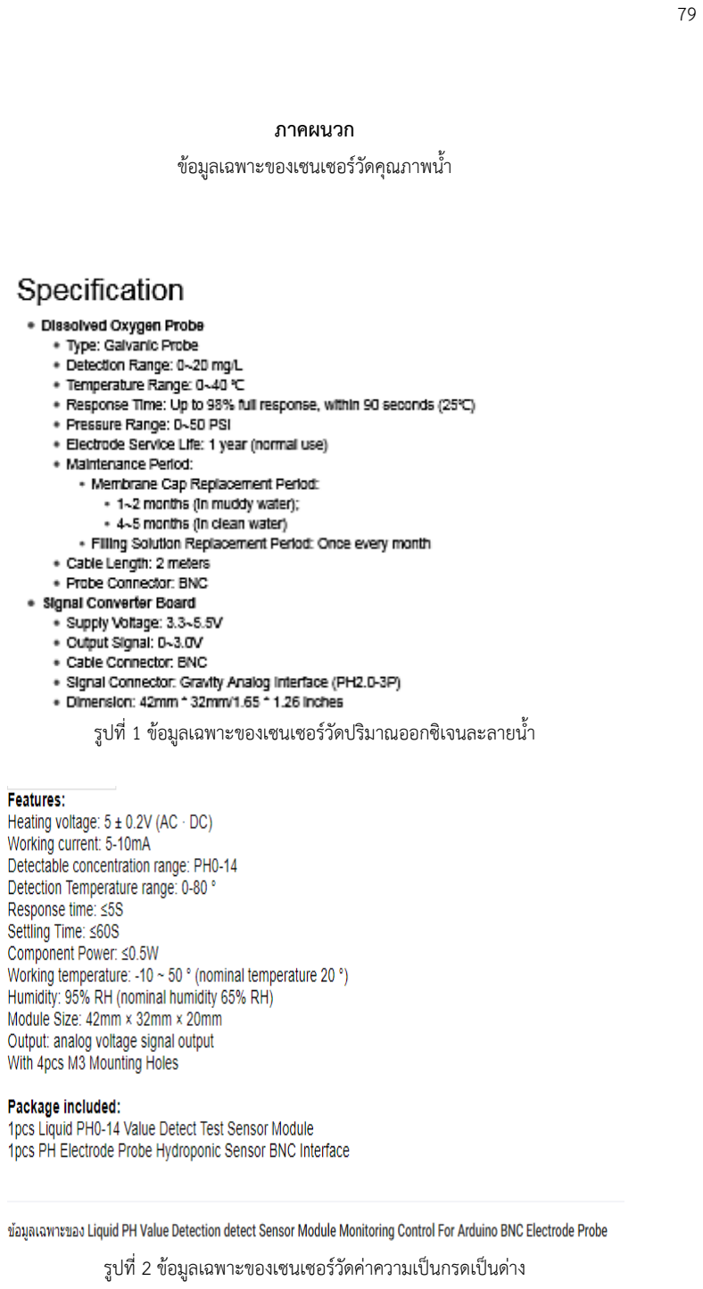
[picture p83: page 93]

ภาคผนวก
ข้อมูลเฉพาะของเซนเซอร์วัดคุณภาพน ้า

รูปที่ 1 ข้อมูลเฉพาะของเซนเซอร์วัดปริมาณออกซิเจนละลายน ้า

รูปที่ 2 ข้อมูลเฉพาะของเซนเซอร์วัดค่าความเป็นกรดเป็นด่าง

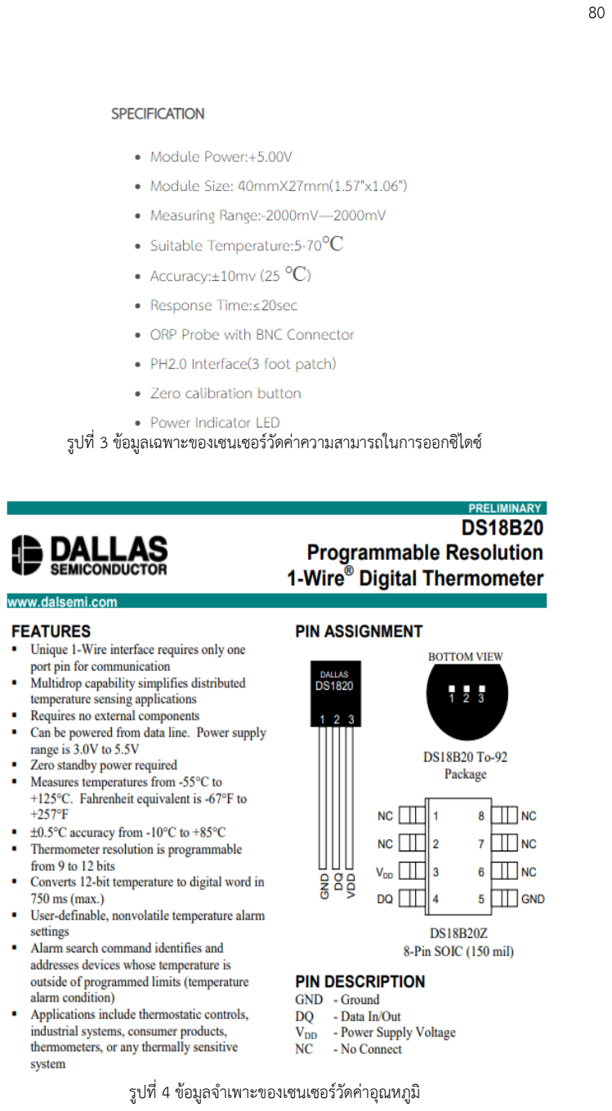
[picture p84: page 94]

รูปที่ 3 ข้อมูลเฉพาะของเซนเซอร์วัดค่าความสามารถในการออกซิไดซ์

รูปที่ 4 ข้อมูลจ้าเพาะของเซนเซอร์วัดค่าอุณหภูมิ

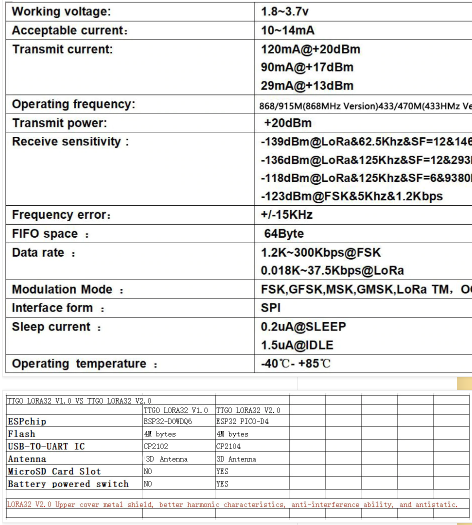
[picture p85: figure]

รูปที่ 5 ข้อมูลจ้าเพาะของ TGO ESP32 LoRa
