AtchariyaM/LoRa-Technology-for-Environmental/us/css/softL.png

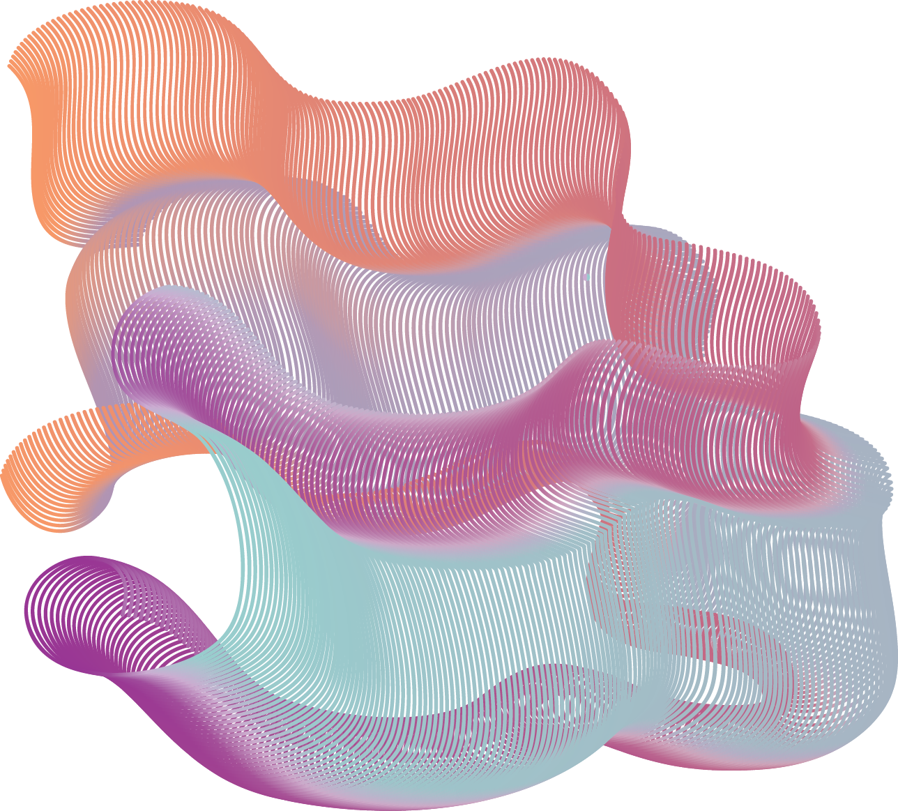
us/css/softL.png
