AtchariyaM/LoRa-Technology-for-Environmental/us/image/1.jpg

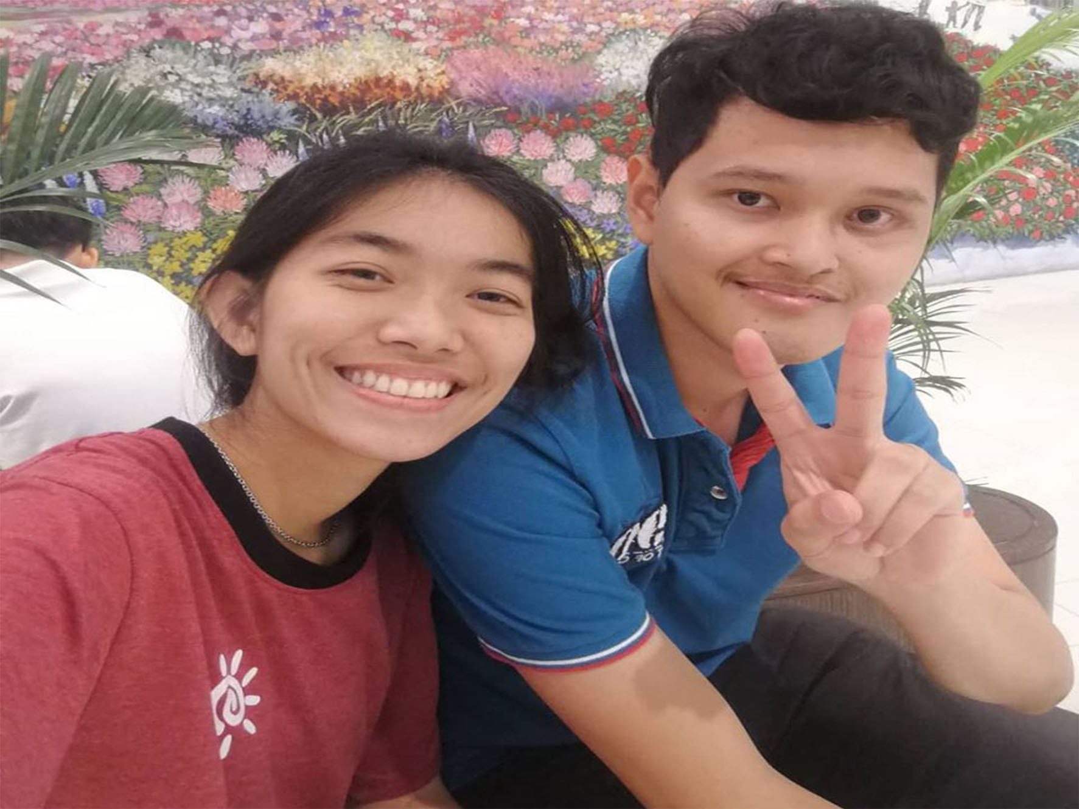
us/image/1.jpg
