AtchariyaM/LoRa-Technology-for-Environmental/us/image/2.jpg

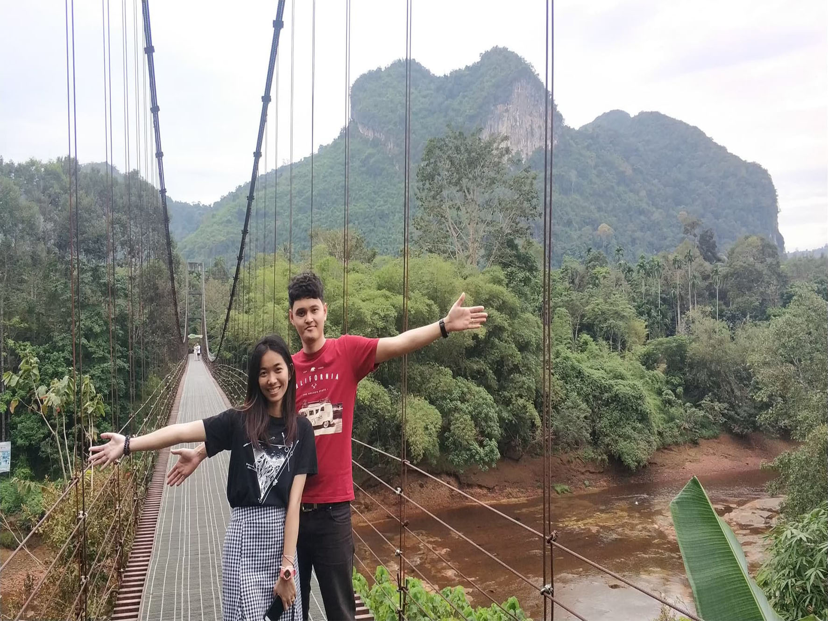
us/image/2.jpg
