AtchariyaM/LoRa-Technology-for-Environmental/us/image/3.jpg

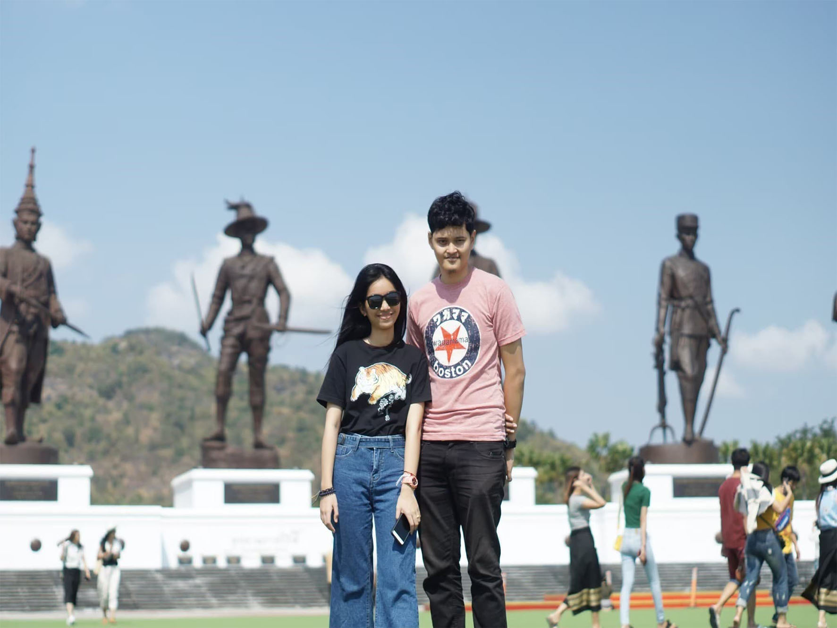
us/image/3.jpg
