AtchariyaM/LoRa-Technology-for-Environmental/us/image/4.jpg

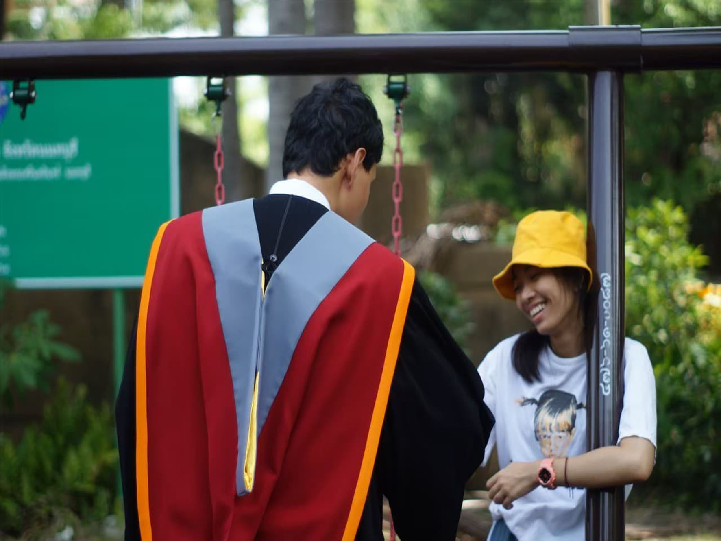
us/image/4.jpg
