AtchariyaM/LoRa-Technology-for-Environmental/us/image/5.jpg

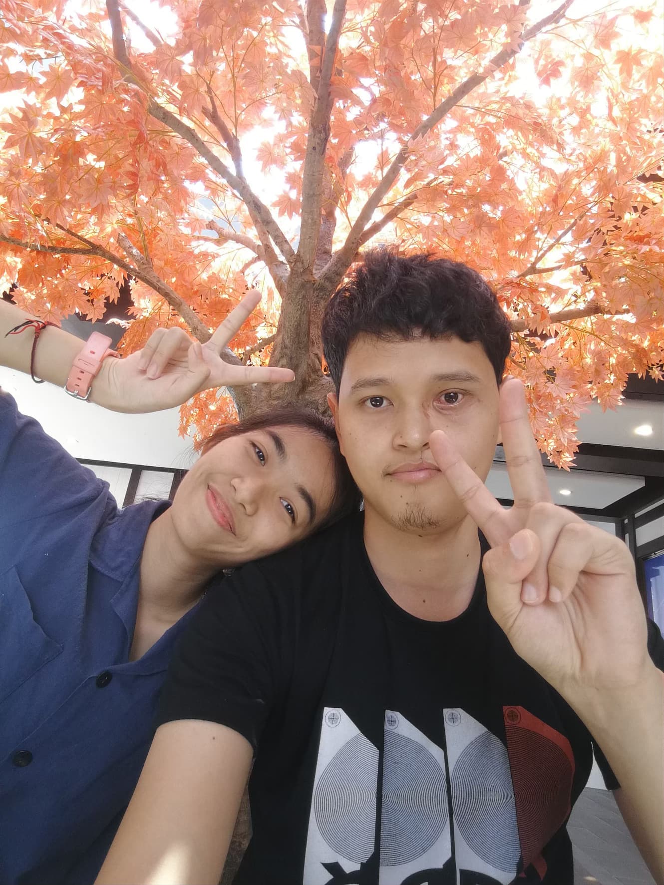
us/image/5.jpg
