AtchariyaM/LoRa-Technology-for-Environmental/us/image/6.jpg

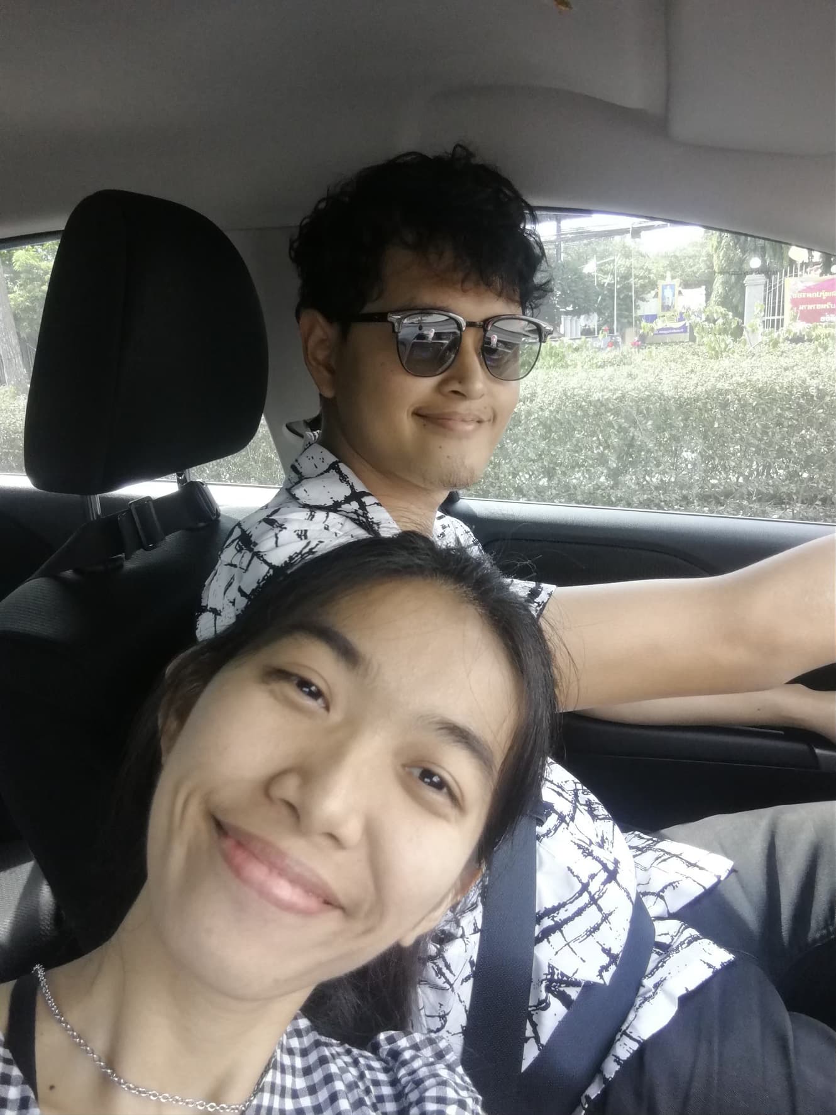
us/image/6.jpg
