AtchariyaM/LoRa-Technology-for-Environmental/us/image/7.jpg

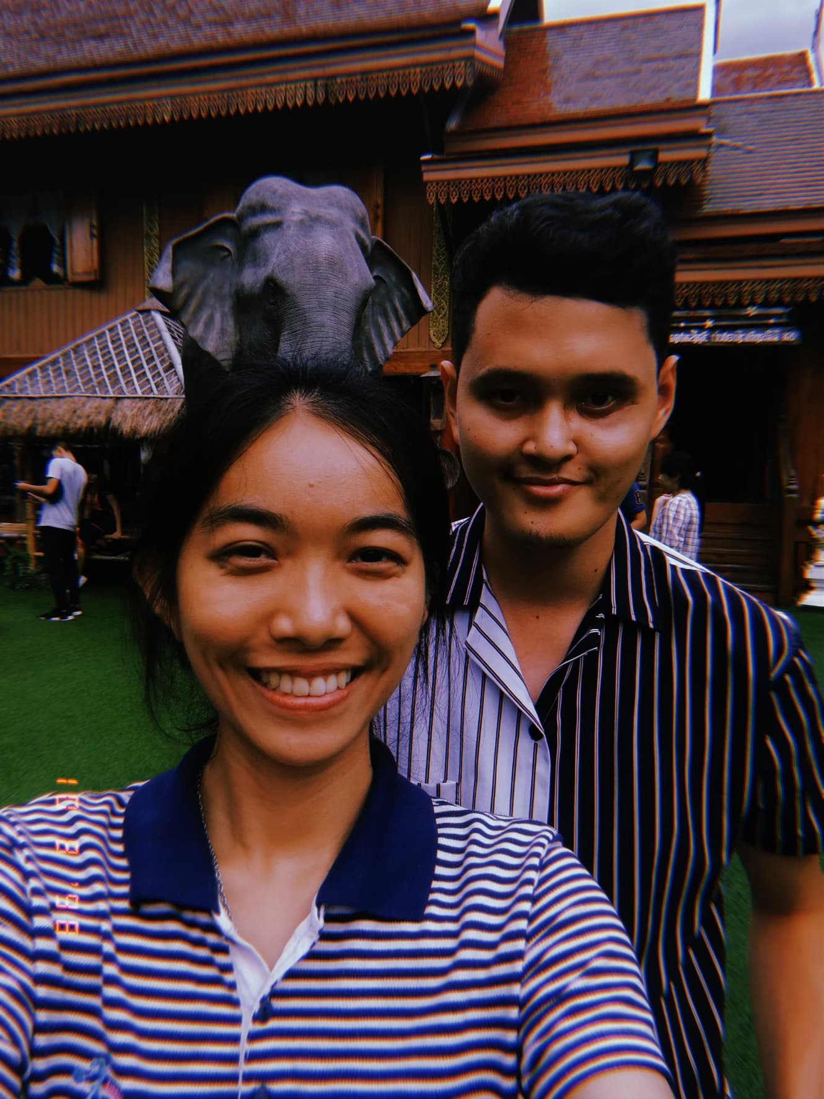
us/image/7.jpg
