AtchariyaM/LoRa-Technology-for-Environmental/us/image/8.jpg

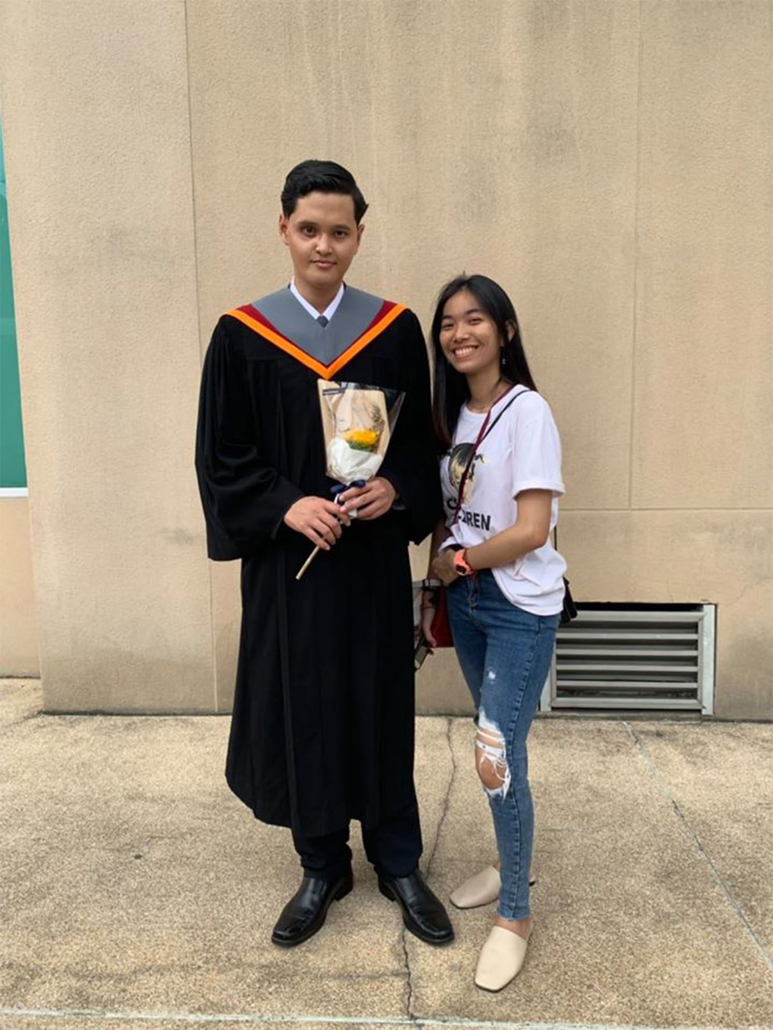
us/image/8.jpg
