AtchariyaM/LoRa-Technology-for-Environmental/us/image/9.jpg

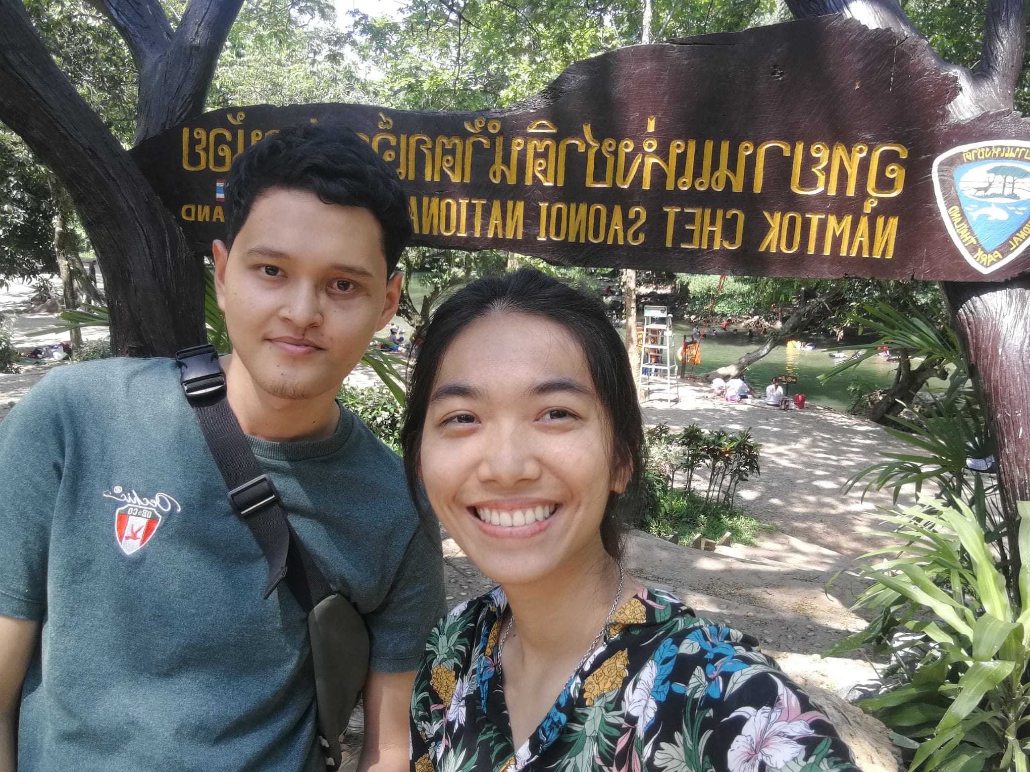
us/image/9.jpg
