AtchariyaM/LoRa-Technology-for-Environmental/us/image/10.jpg

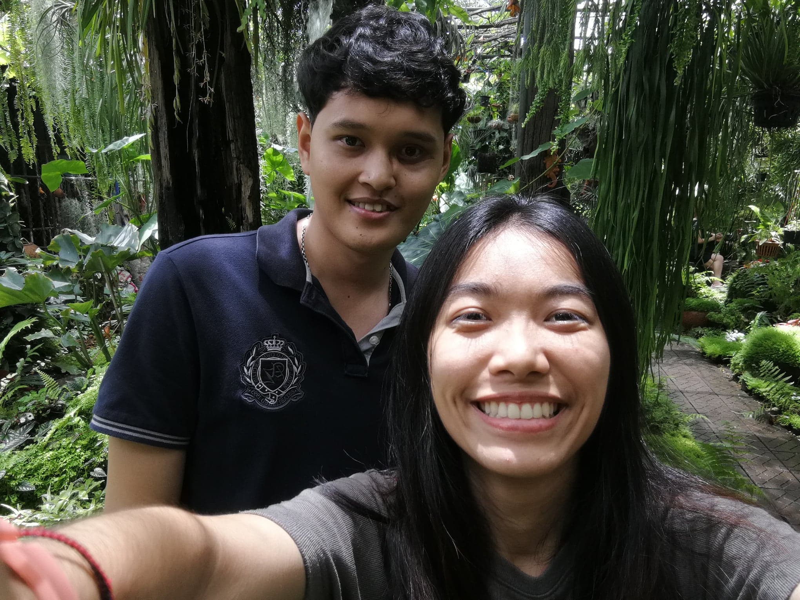
us/image/10.jpg
