AtchariyaM/LoRa-Technology-for-Environmental/us/image/11.jpg

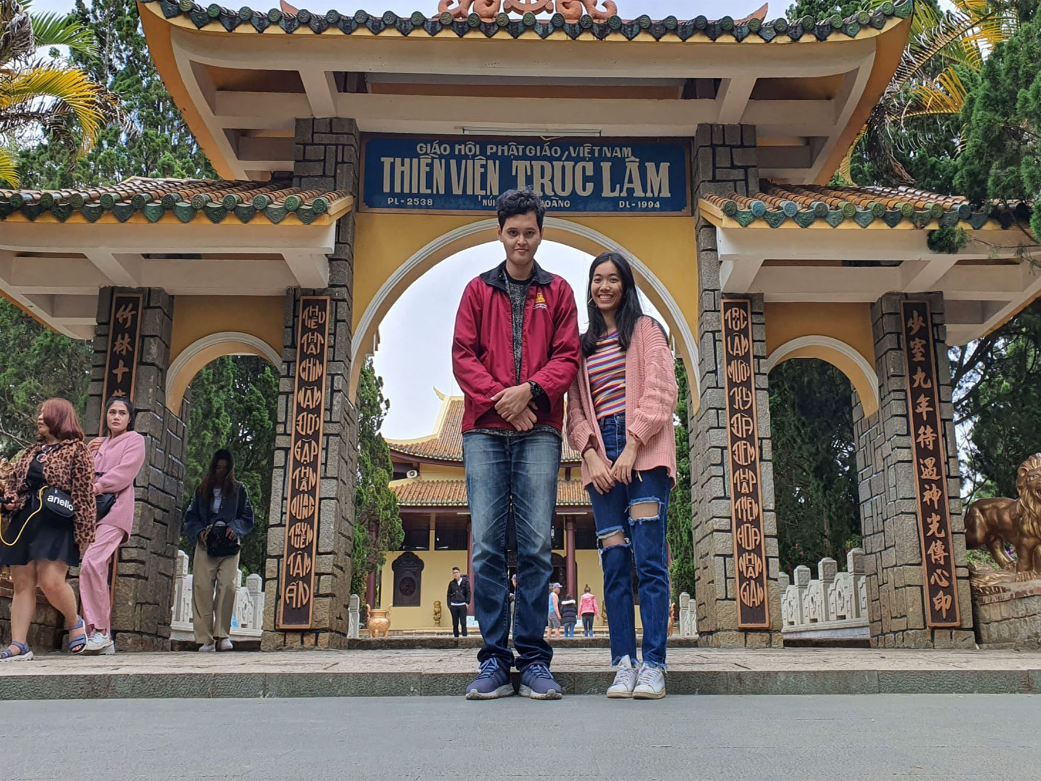
us/image/11.jpg
