AtchariyaM/LoRa-Technology-for-Environmental/us/image/12.jpg

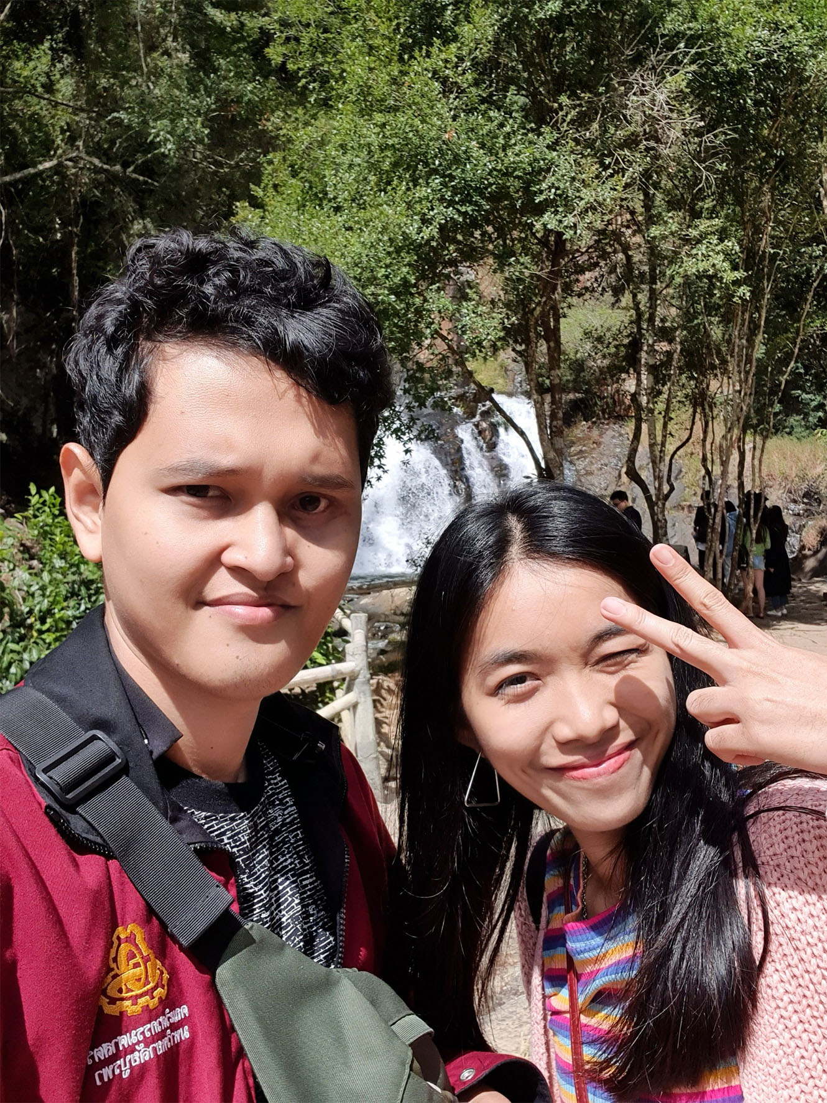
us/image/12.jpg
