AtchariyaM/LoRa-Technology-for-Environmental/us/image/13.jpg

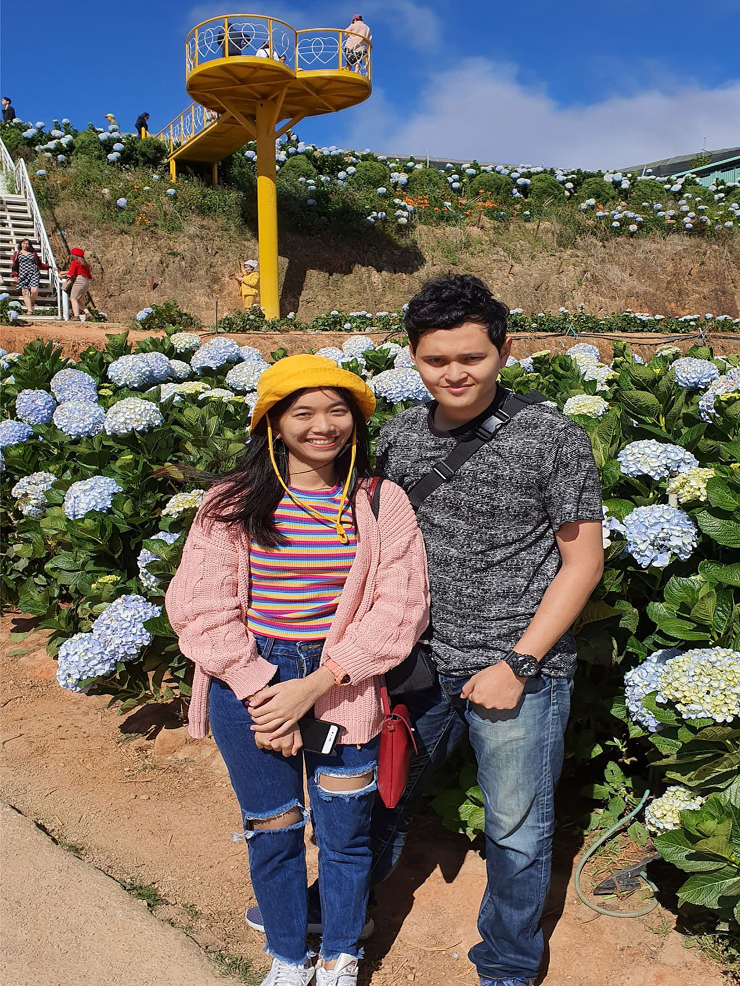
us/image/13.jpg
