AtchariyaM/LoRa-Technology-for-Environmental/us/image/14.jpg

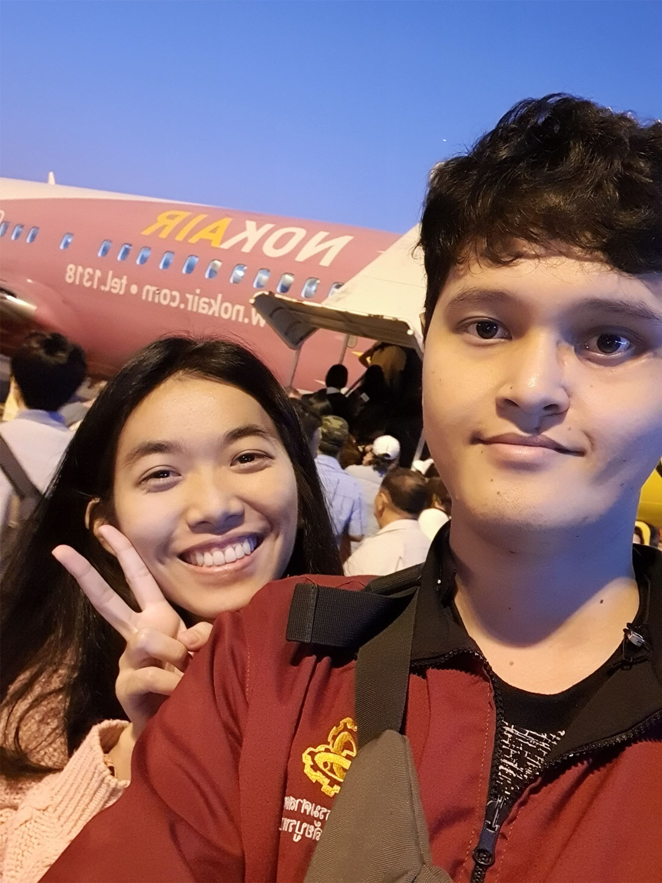
us/image/14.jpg
