AtchariyaM/LoRa-Technology-for-Environmental/us/image/16.jpg

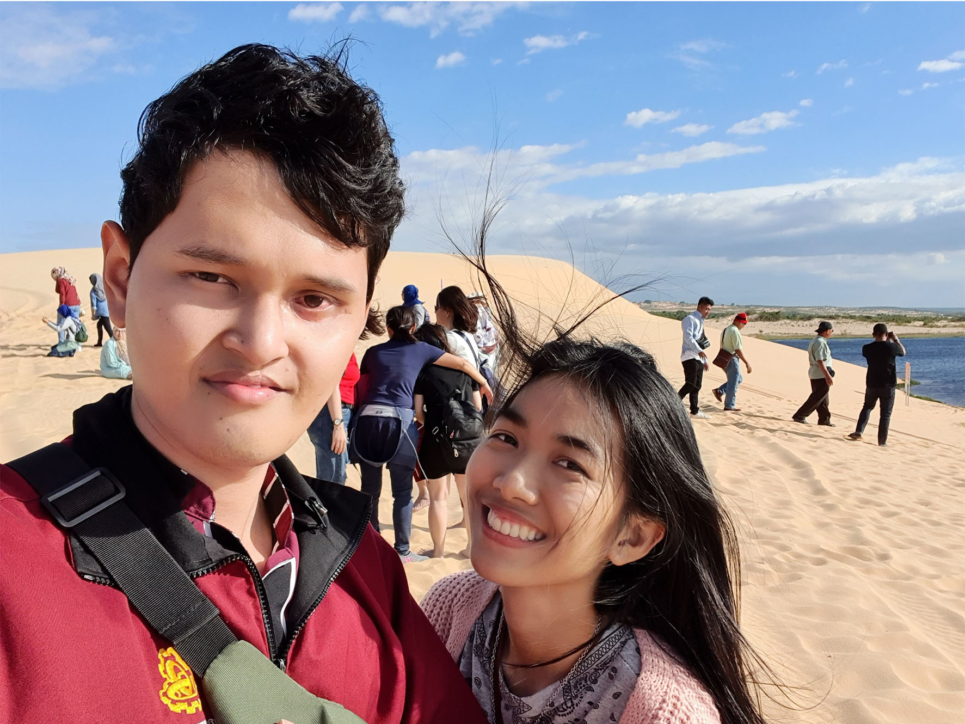
us/image/16.jpg
