AtchariyaM/LoRa-Technology-for-Environmental/us/image/18.jpg

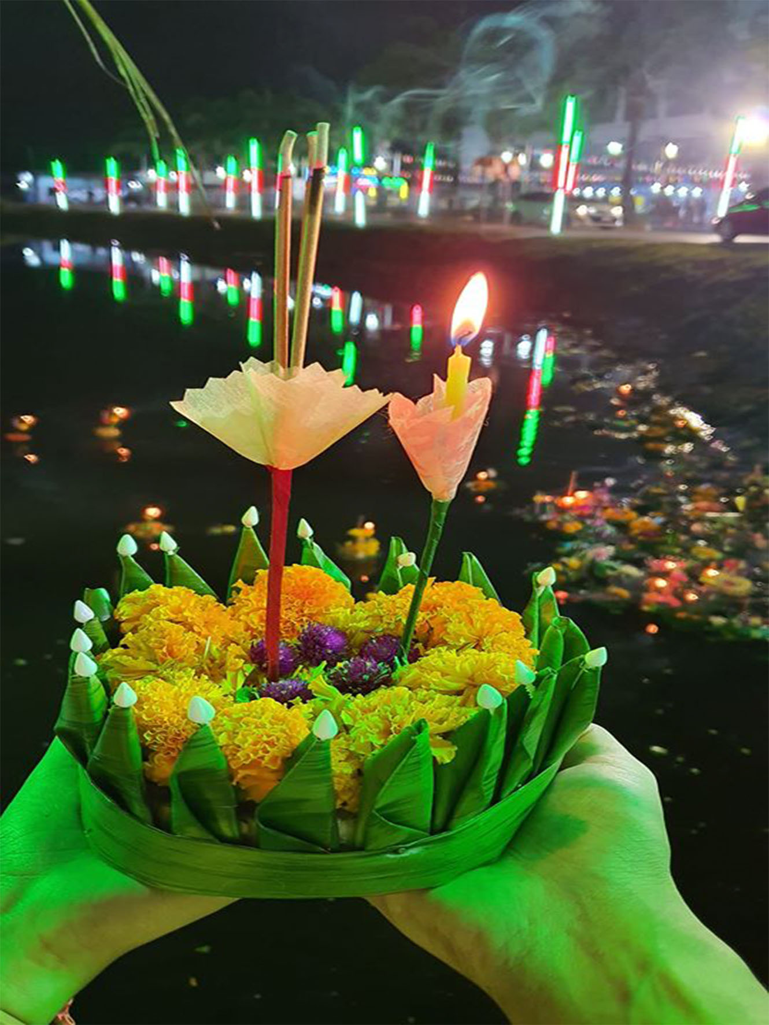
us/image/18.jpg
