AtchariyaM/LoRa-Technology-for-Environmental/us/image/19.jpg

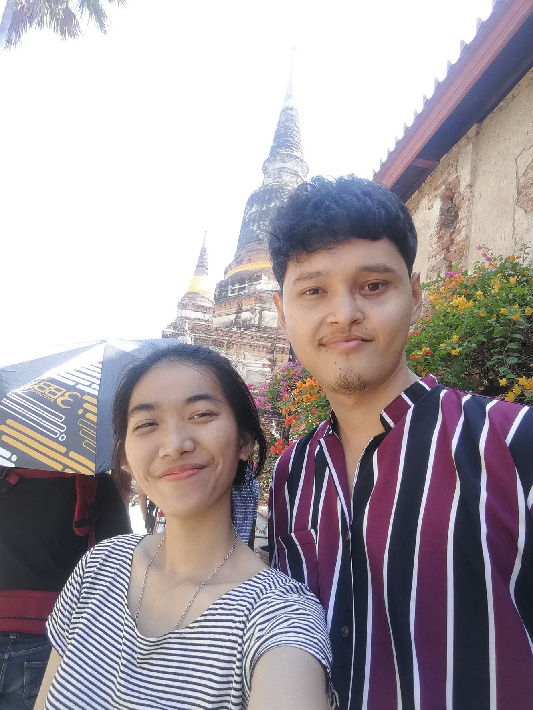
us/image/19.jpg
