AtchariyaM/LoRa-Technology-for-Environmental/us/image/20.jpg

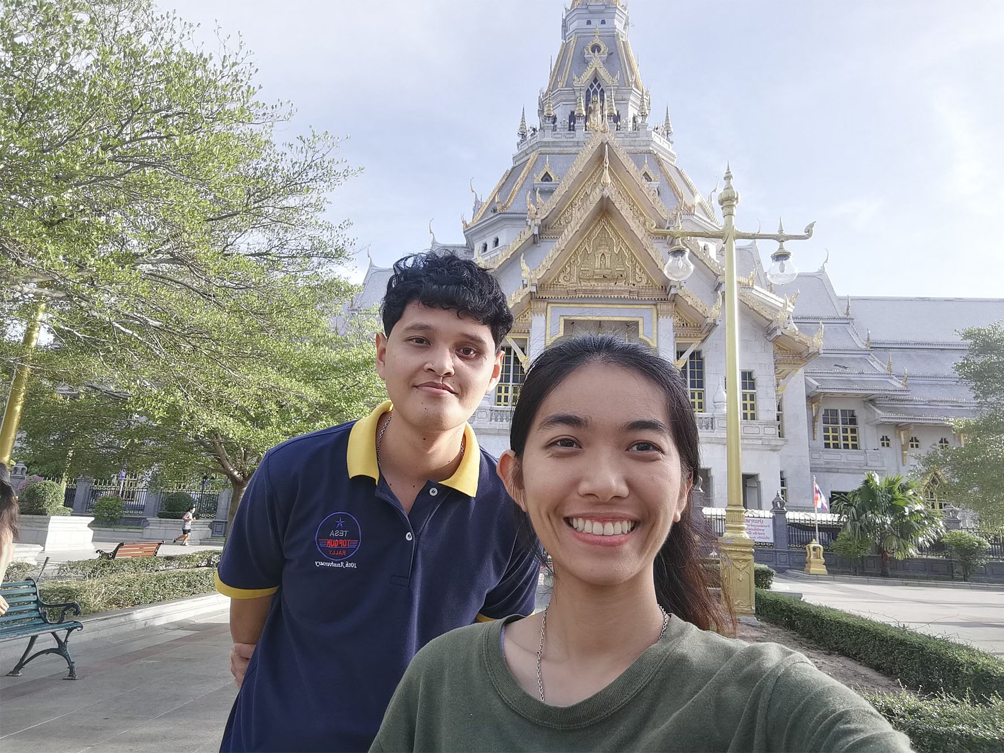
us/image/20.jpg
