AtchariyaM/LoRa-Technology-for-Environmental/us/image/21.jpg

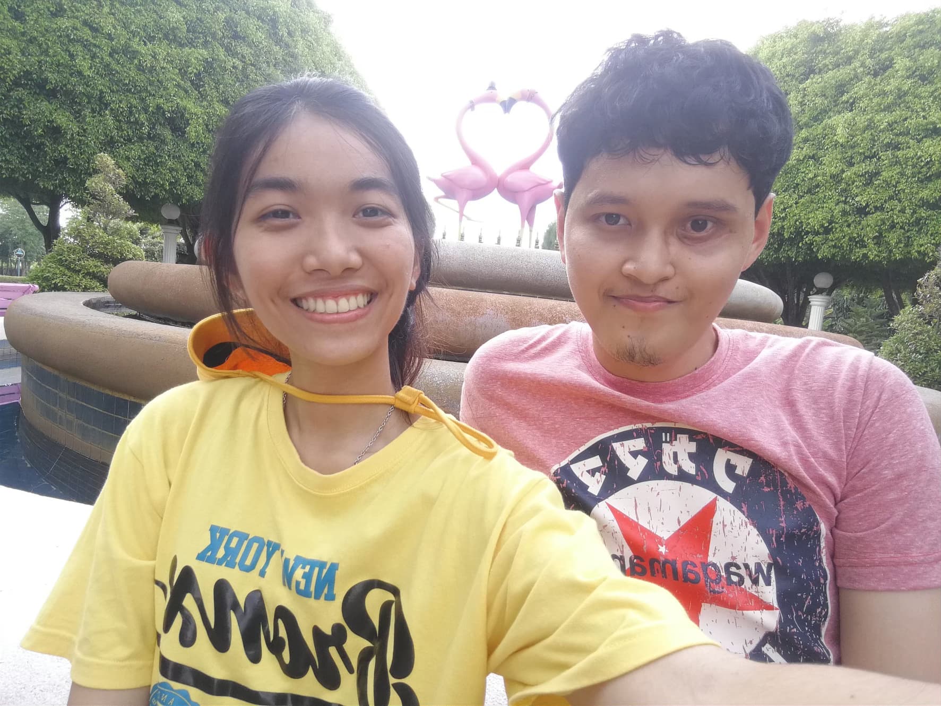
us/image/21.jpg
