AtchariyaM/LoRa-Technology-for-Environmental/us/image/22.jpg

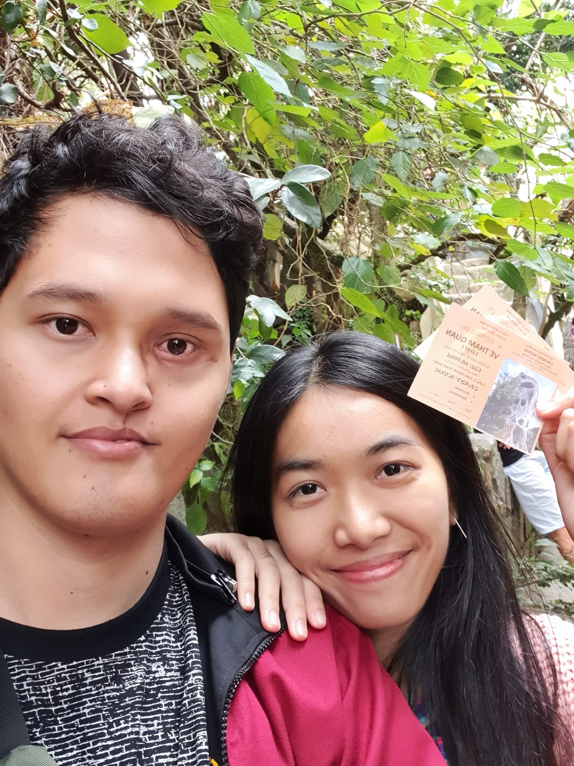
us/image/22.jpg
