AtchariyaM/LoRa-Technology-for-Environmental/us/image/23.jpg

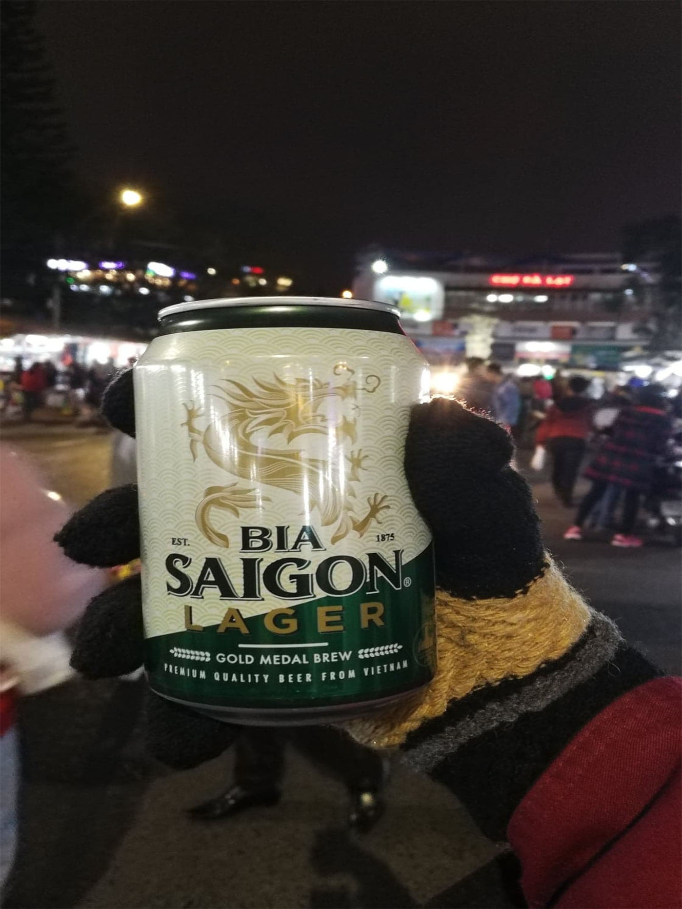
us/image/23.jpg
