AtchariyaM/LoRa-Technology-for-Environmental/us/image/24.jpg

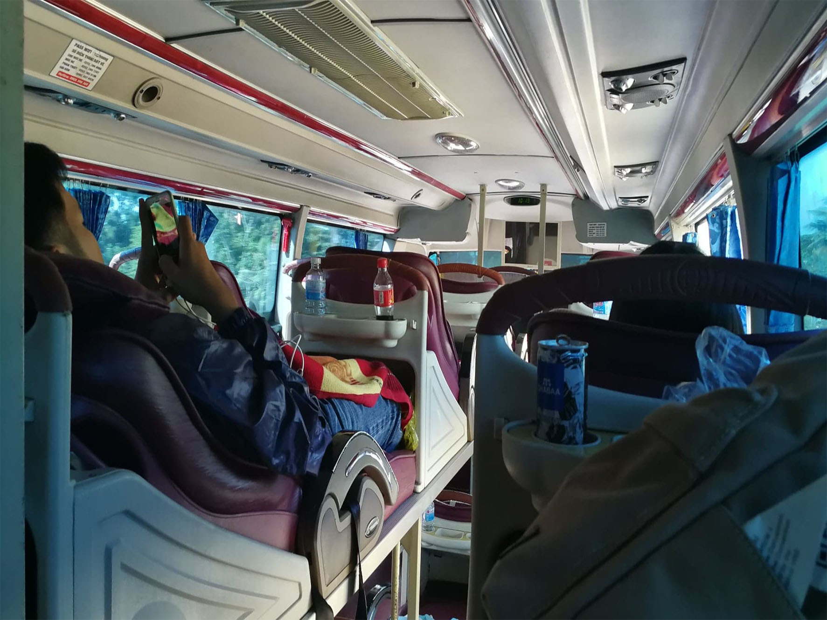
us/image/24.jpg
