AtchariyaM/LoRa-Technology-for-Environmental/us/image/25.jpg

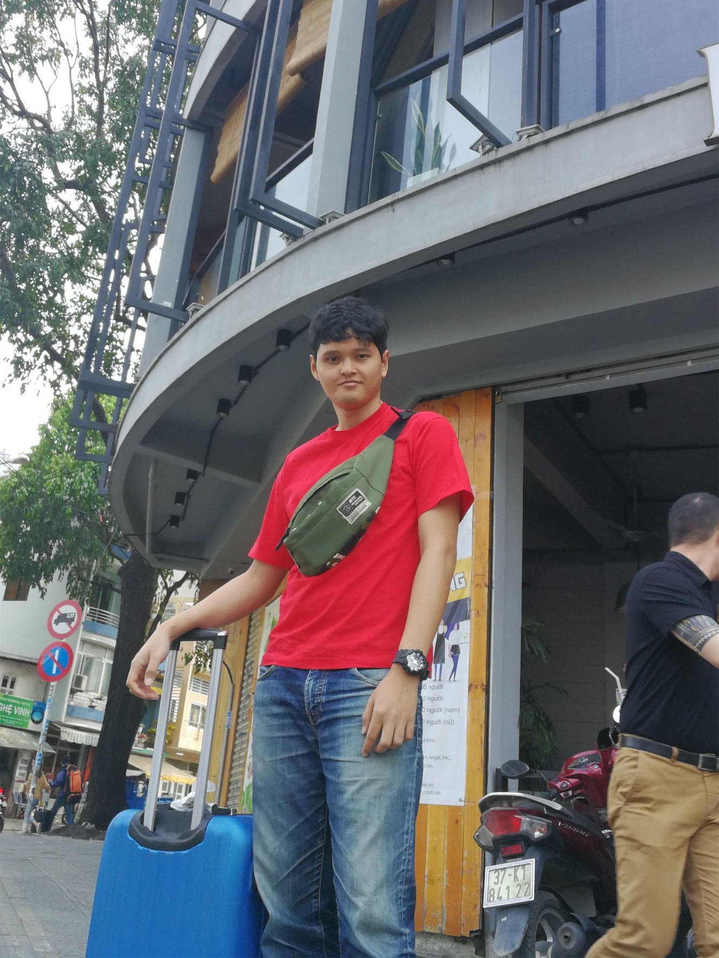
us/image/25.jpg
