AtchariyaM/LoRa-Technology-for-Environmental/us/image/26.jpg

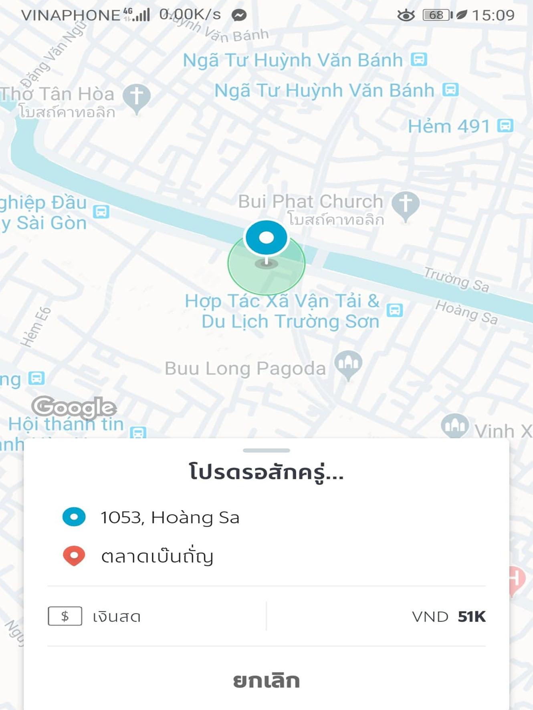
us/image/26.jpg
