AtchariyaM/LoRa-Technology-for-Environmental/us/image/27.jpg

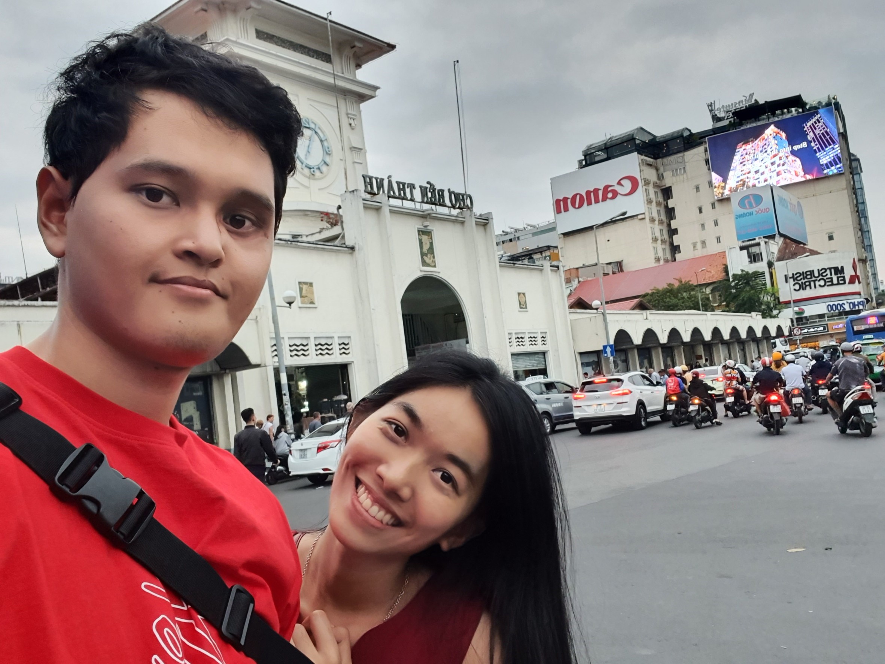
us/image/27.jpg
