AtchariyaM/LoRa-Technology-for-Environmental/us/image/28.jpg

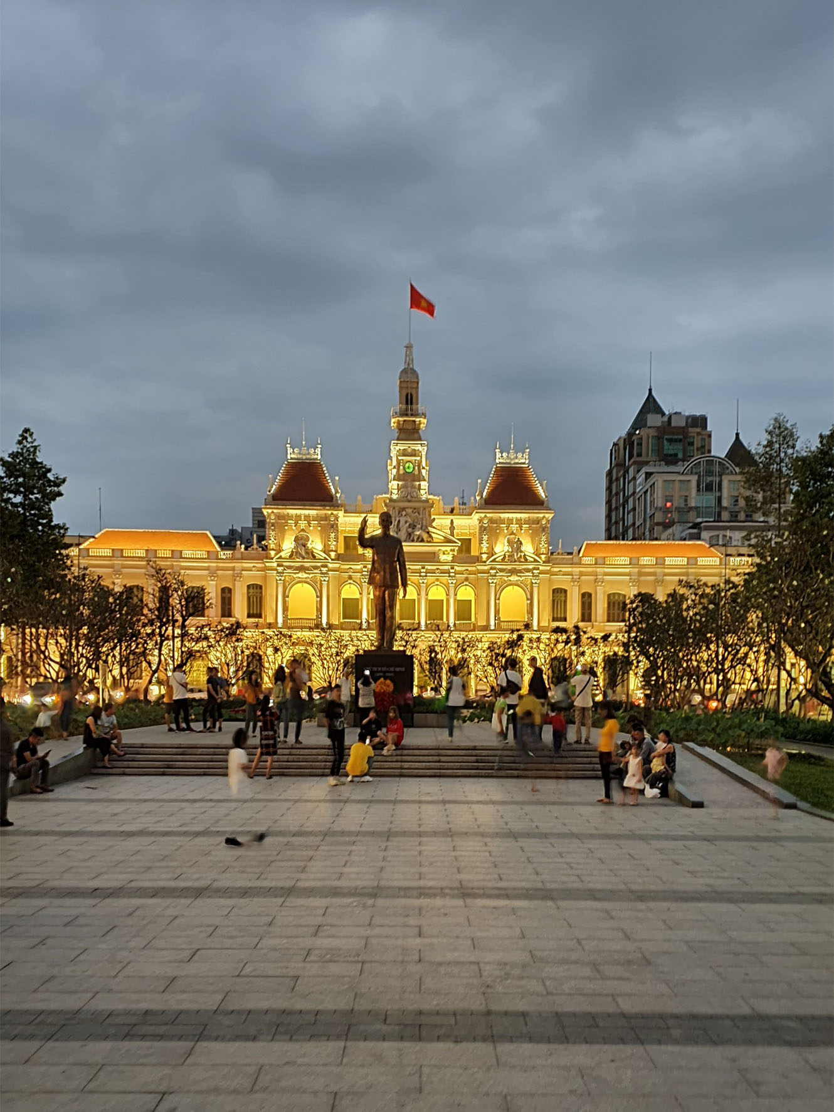
us/image/28.jpg
