AtchariyaM/LoRa-Technology-for-Environmental/us/image/30.jpg

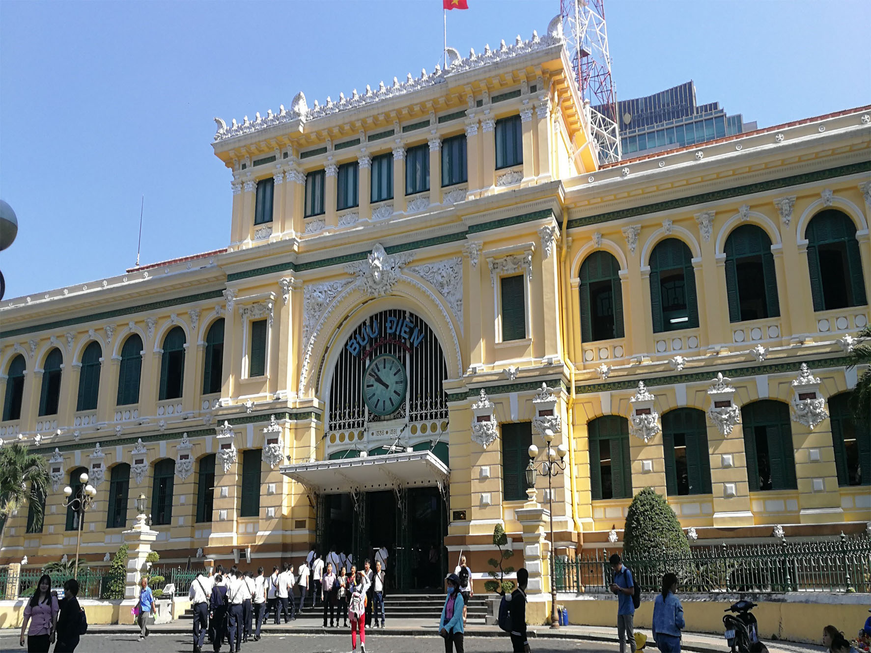
us/image/30.jpg
