AtchariyaM/LoRa-Technology-for-Environmental/us/image/31.jpg

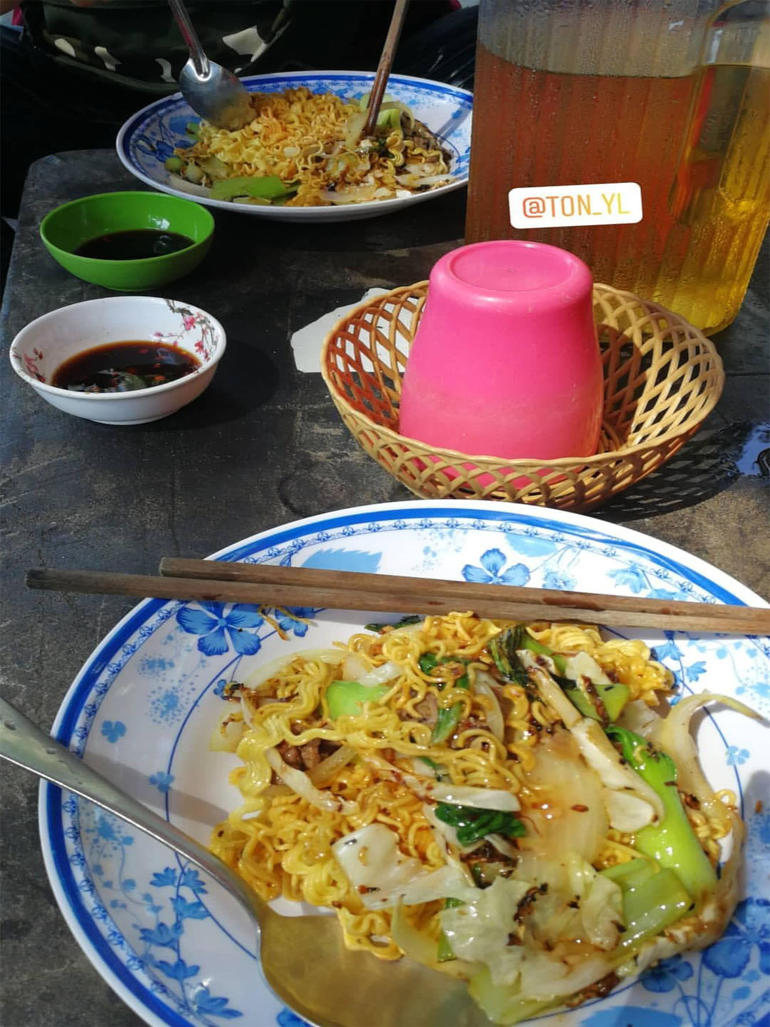
us/image/31.jpg
