AtchariyaM/LoRa-Technology-for-Environmental/us/image/32.jpg

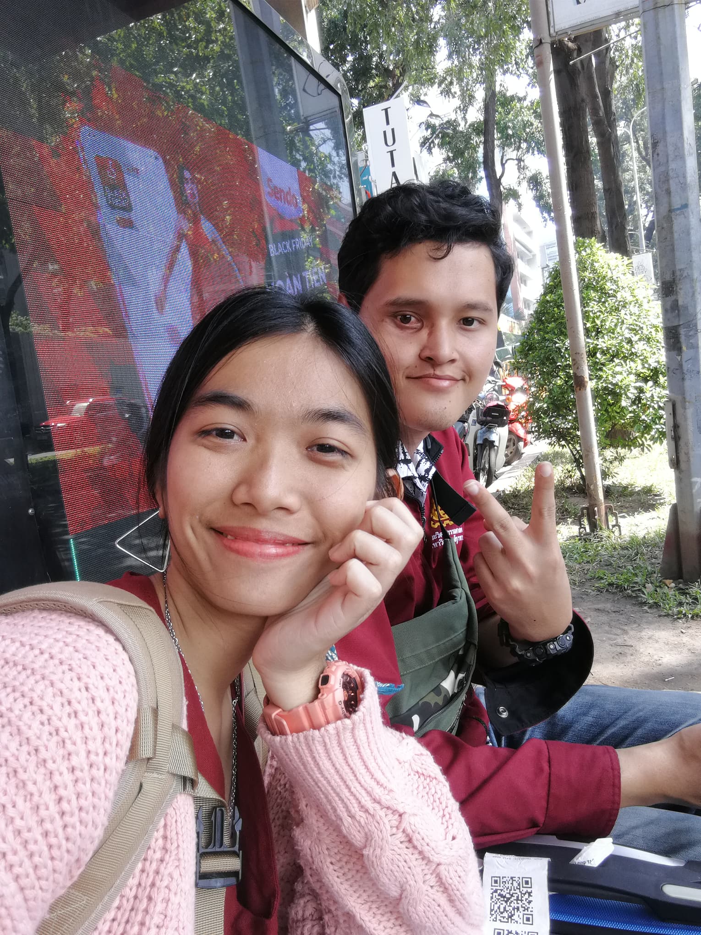
us/image/32.jpg
