AtchariyaM/LoRa-Technology-for-Environmental/us/image/33.jpg

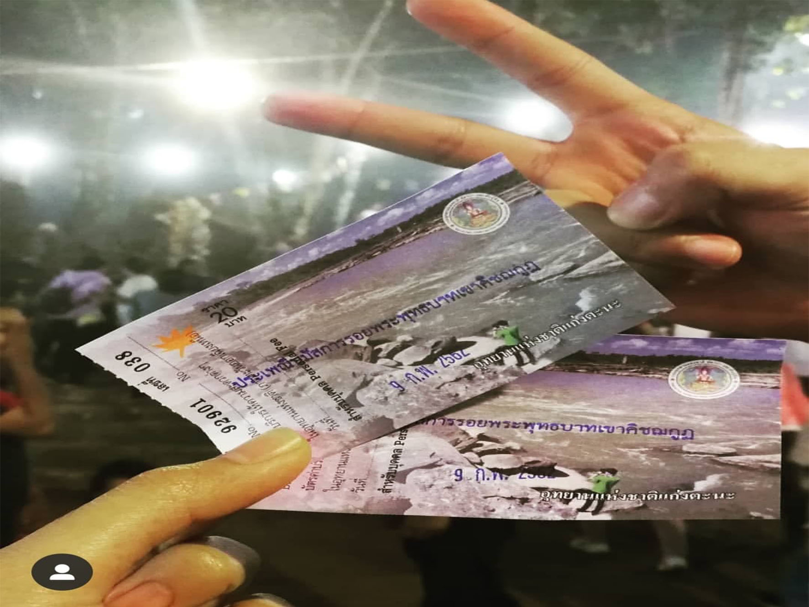
us/image/33.jpg
