AtchariyaM/LoRa-Technology-for-Environmental/us/image/34.jpg

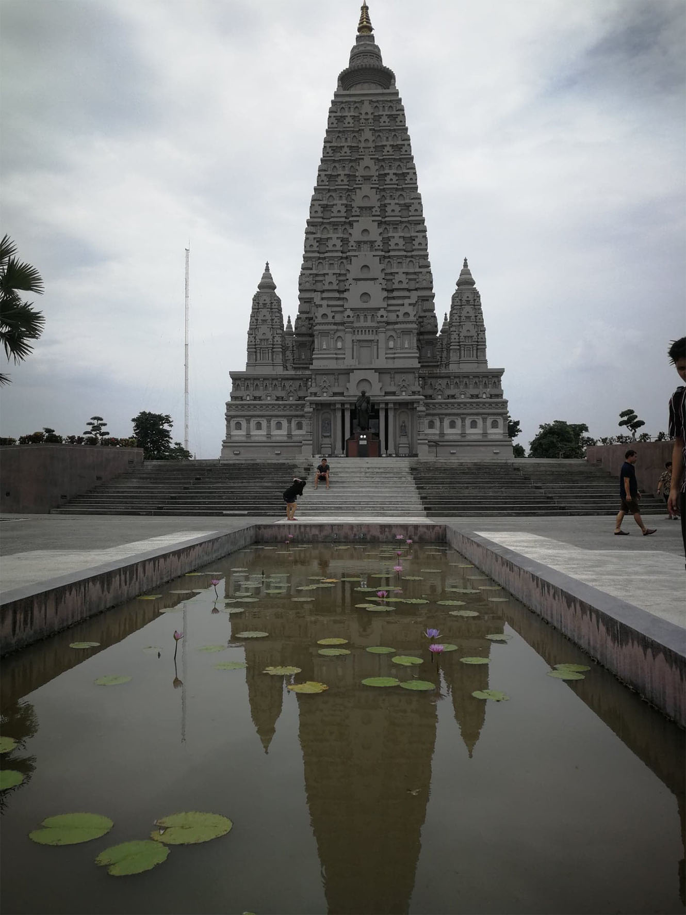
us/image/34.jpg
