AtchariyaM/LoRa-Technology-for-Environmental/us/image/35.jpg

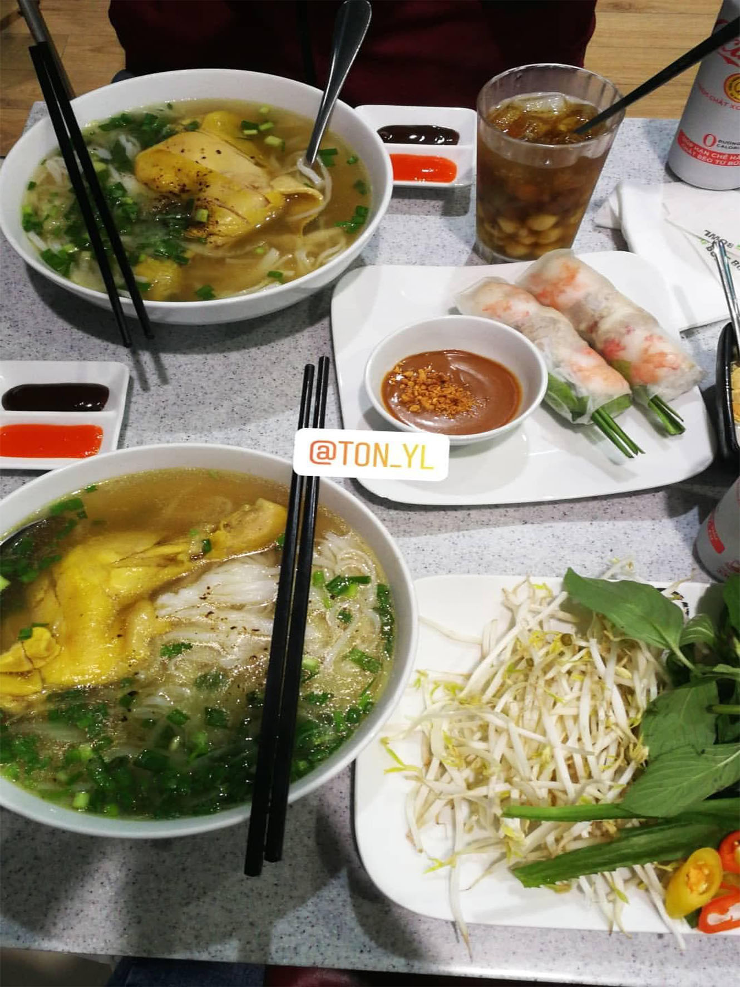
us/image/35.jpg
