AtchariyaM/LoRa-Technology-for-Environmental/us/image/36.jpg

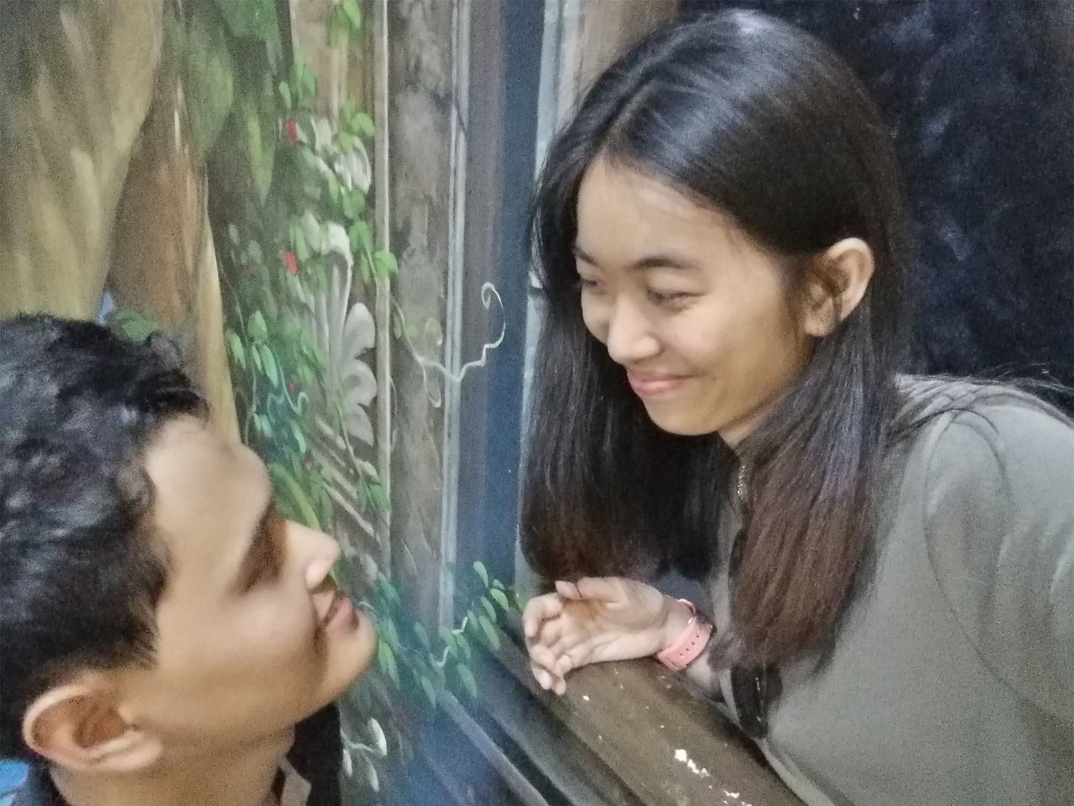
us/image/36.jpg
