AtchariyaM/LoRa-Technology-for-Environmental/us/image/37.jpg

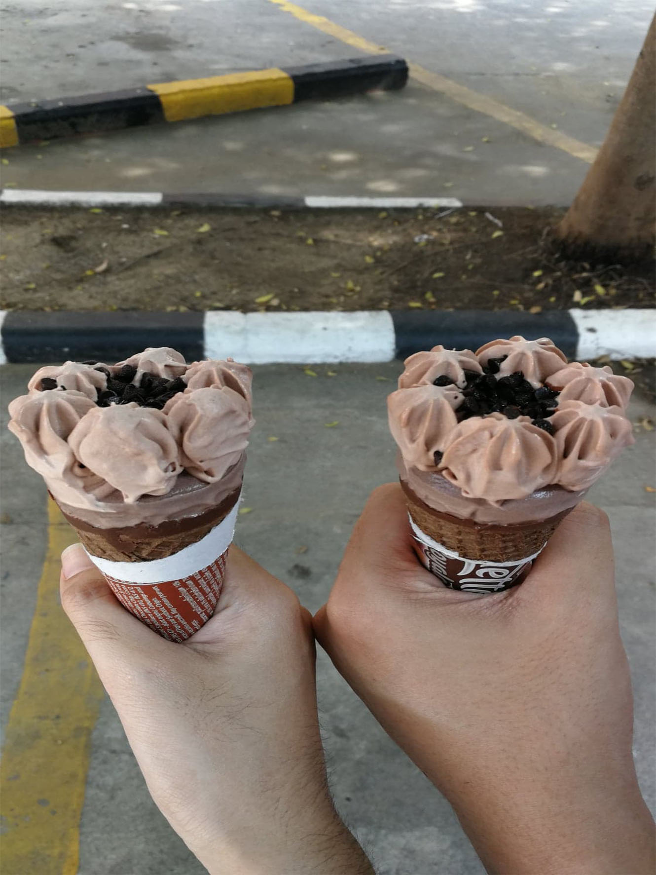
us/image/37.jpg
