AtchariyaM/LoRa-Technology-for-Environmental/us/image/111.jpg

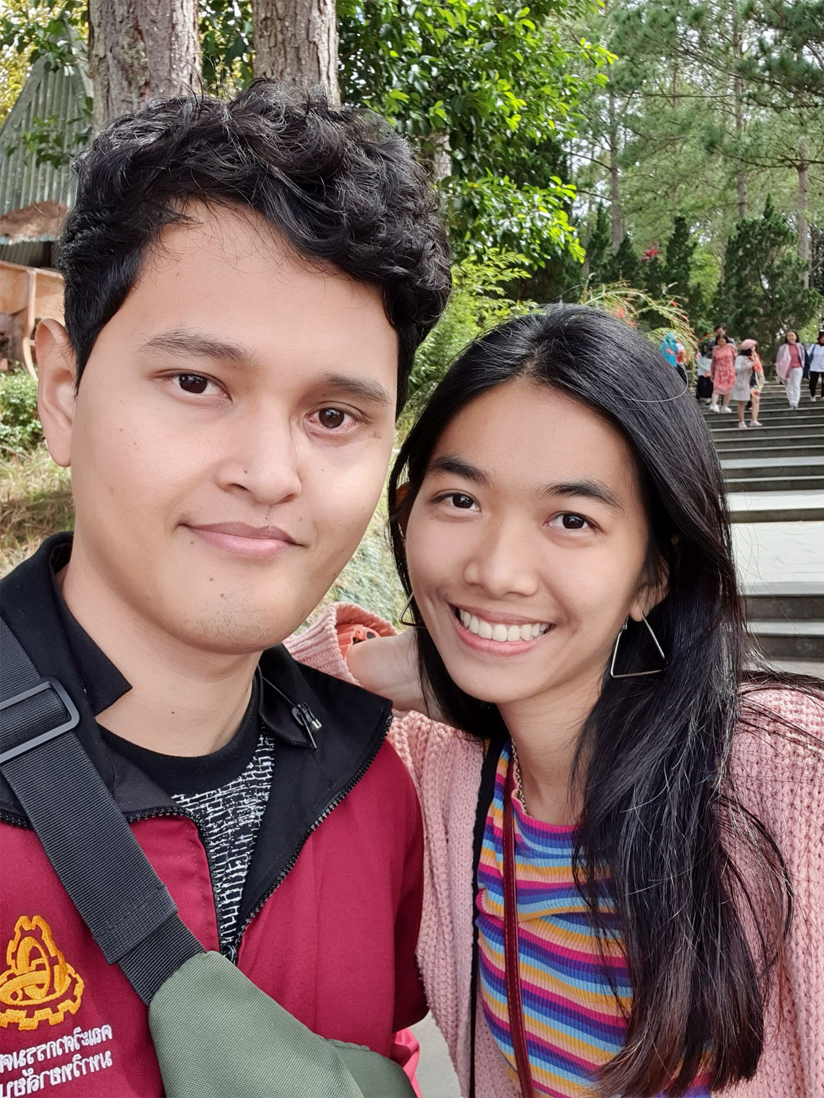
us/image/111.jpg
