AtchariyaM/LoRa-Technology-for-Environmental/us/image/123.jpg

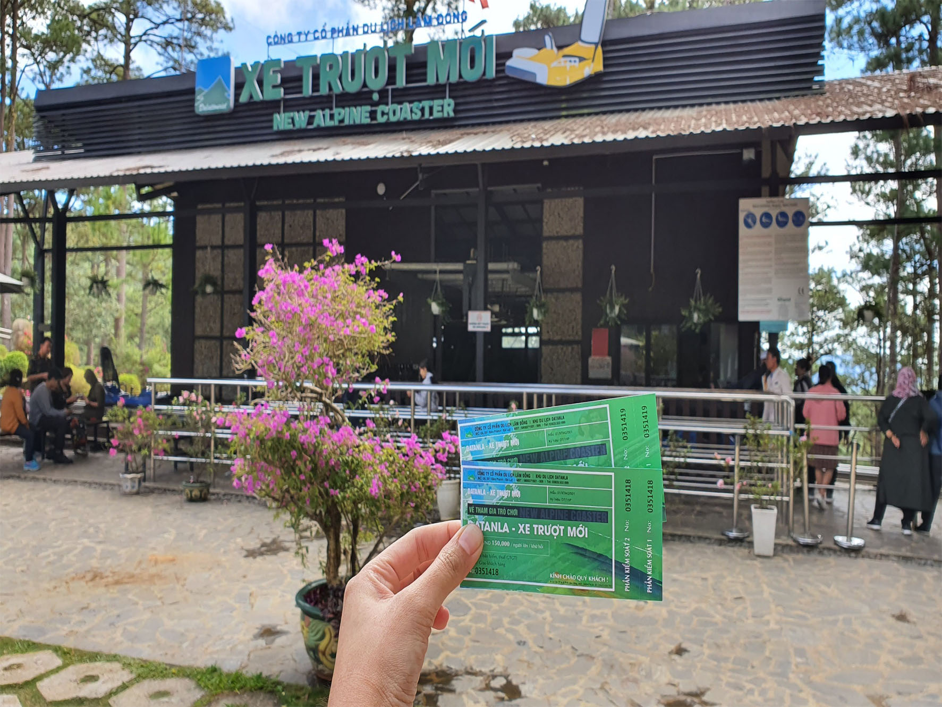
us/image/123.jpg
