AtchariyaM/LoRa-Technology-for-Environmental/us/image/131.jpg

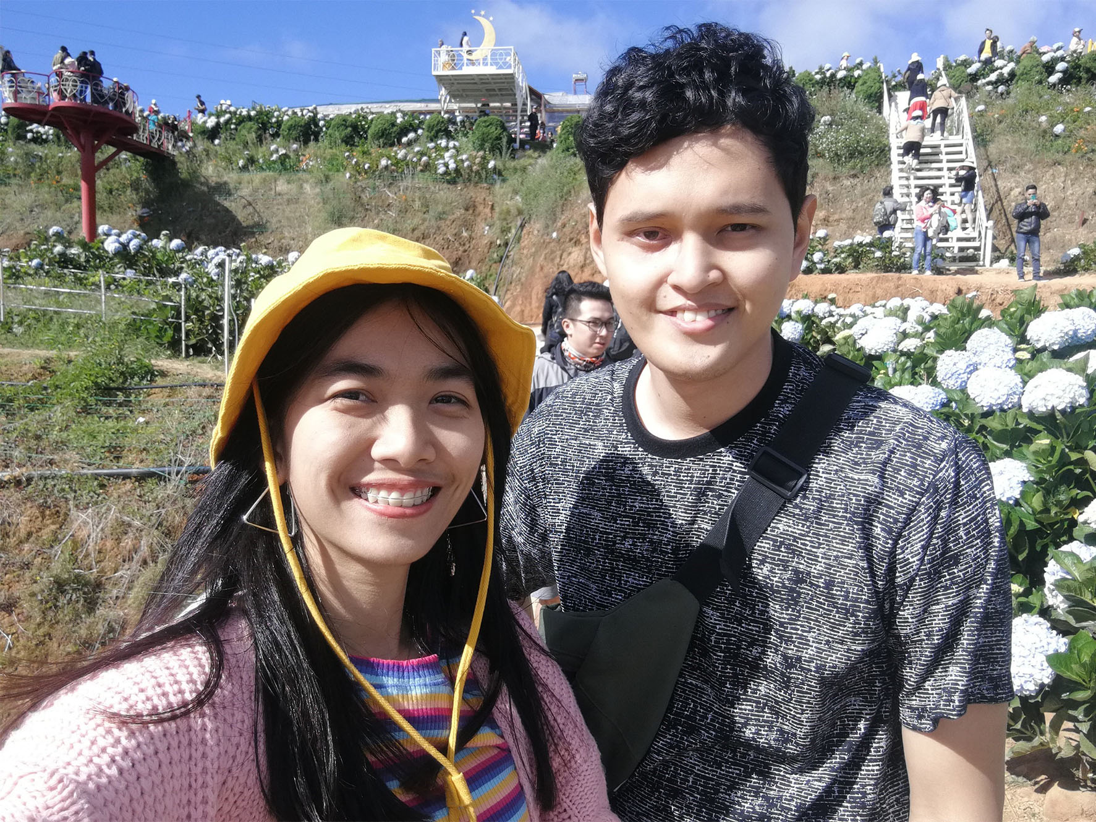
us/image/131.jpg
