AtchariyaM/LoRa-Technology-for-Environmental/us/image/132.jpg

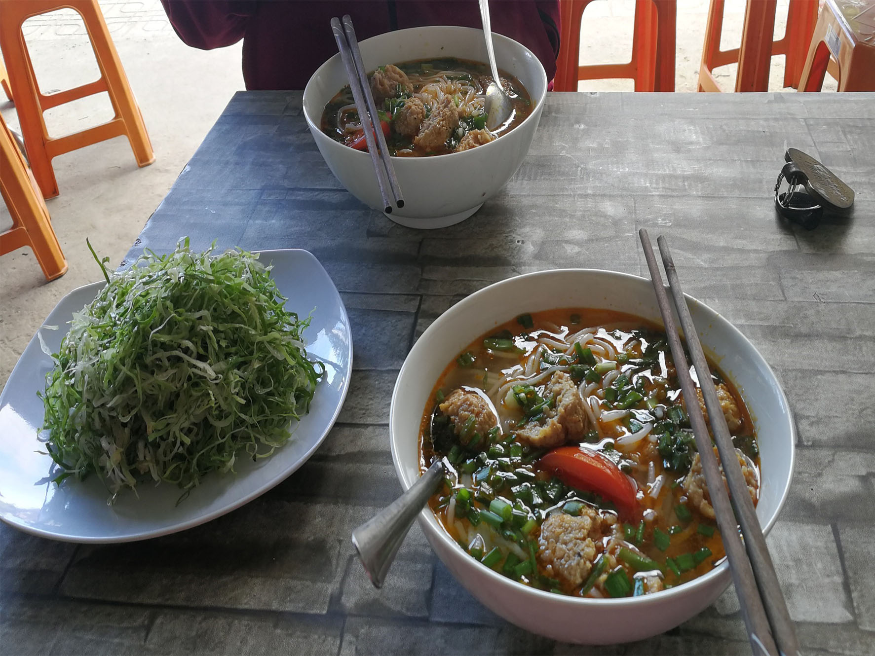
us/image/132.jpg
