AtchariyaM/LoRa-Technology-for-Environmental/us/image/133.jpg

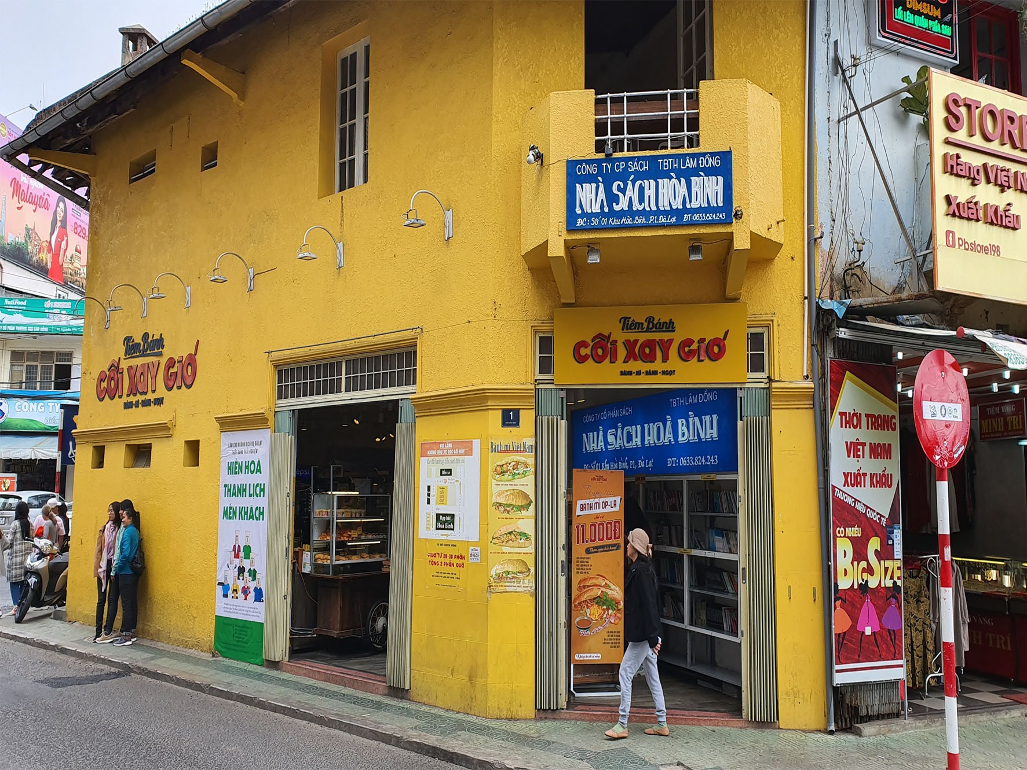
us/image/133.jpg
