AtchariyaM/LoRa-Technology-for-Environmental/us/image/141.jpg

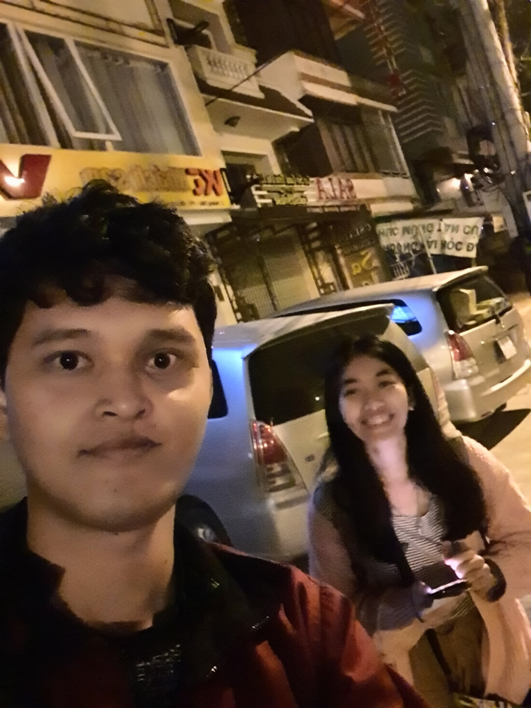
us/image/141.jpg
