AtchariyaM/LoRa-Technology-for-Environmental/us/image/142.jpg

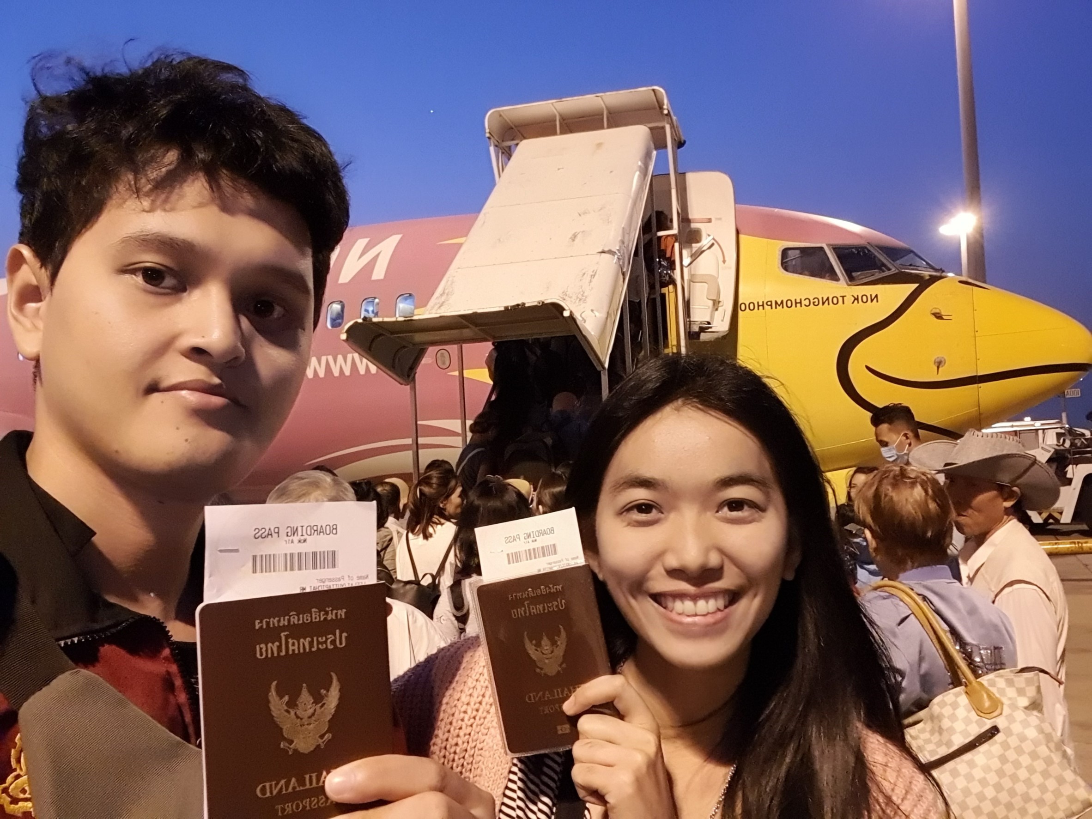
us/image/142.jpg
