AtchariyaM/LoRa-Technology-for-Environmental/us/image/143.jpg

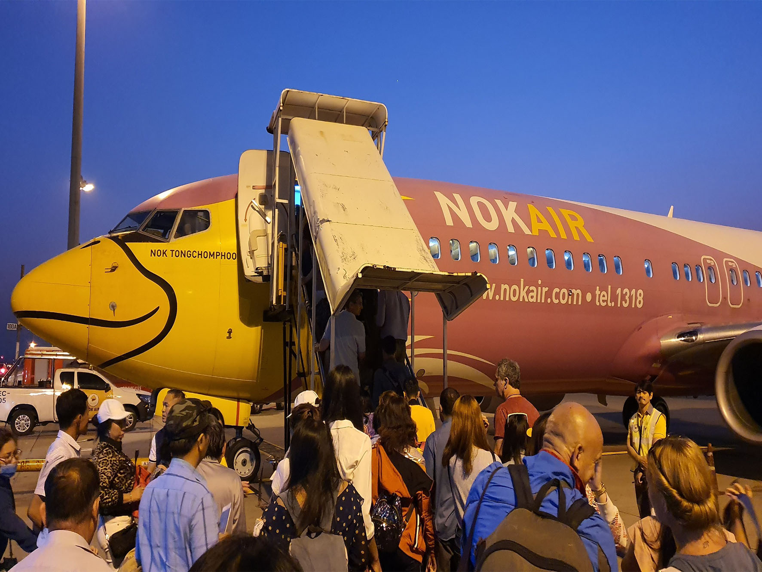
us/image/143.jpg
