AtchariyaM/LoRa-Technology-for-Environmental/us/image/144.jpg

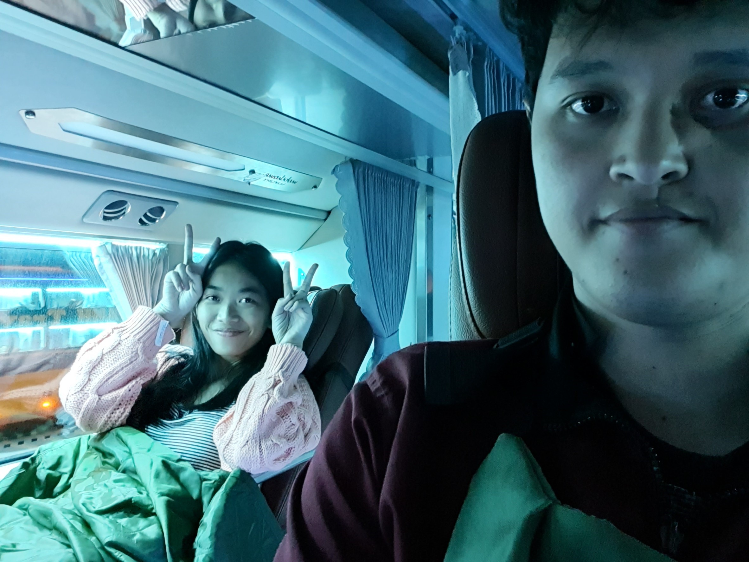
us/image/144.jpg
