AtchariyaM/LoRa-Technology-for-Environmental/us/image/161.jpg

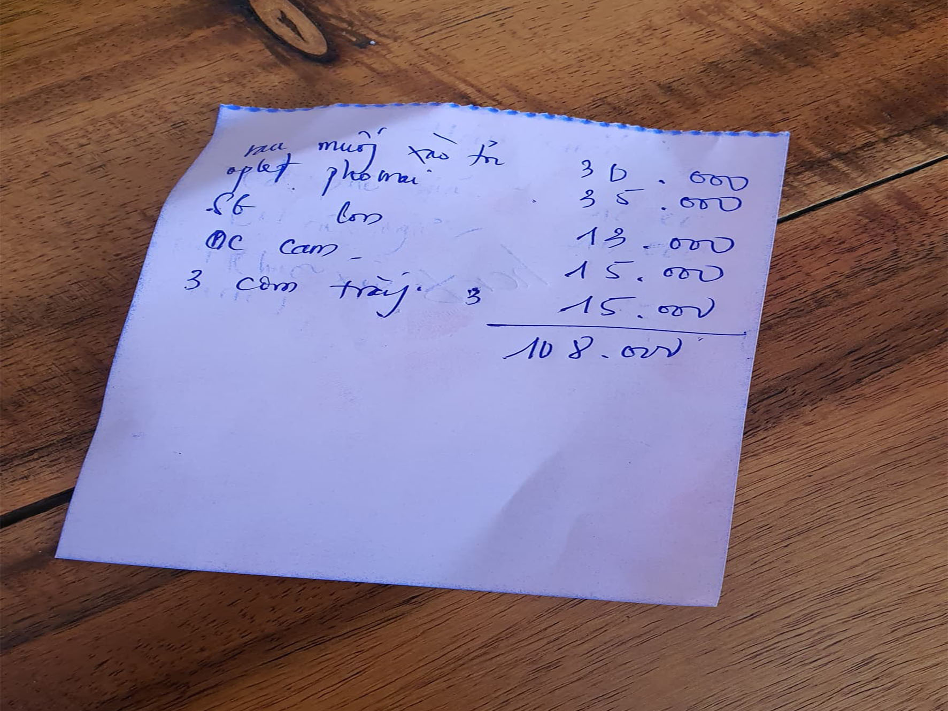
us/image/161.jpg
