AtchariyaM/LoRa-Technology-for-Environmental/us/image/162.jpg

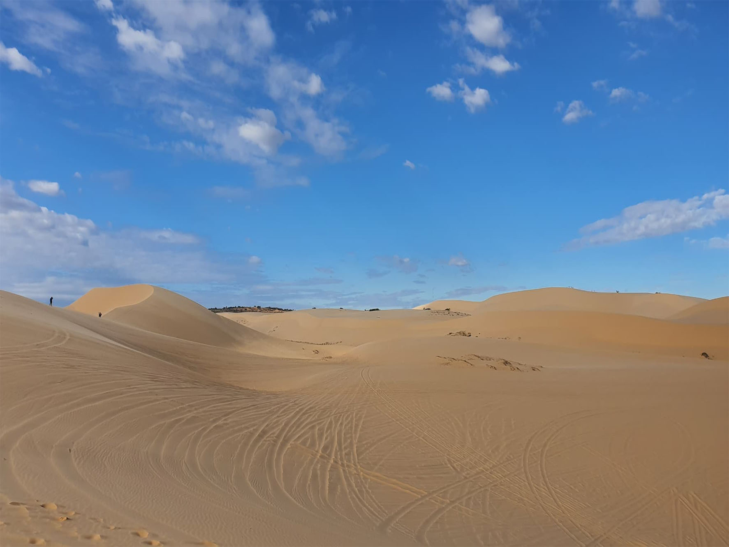
us/image/162.jpg
