AtchariyaM/LoRa-Technology-for-Environmental/us/image/171.jpg

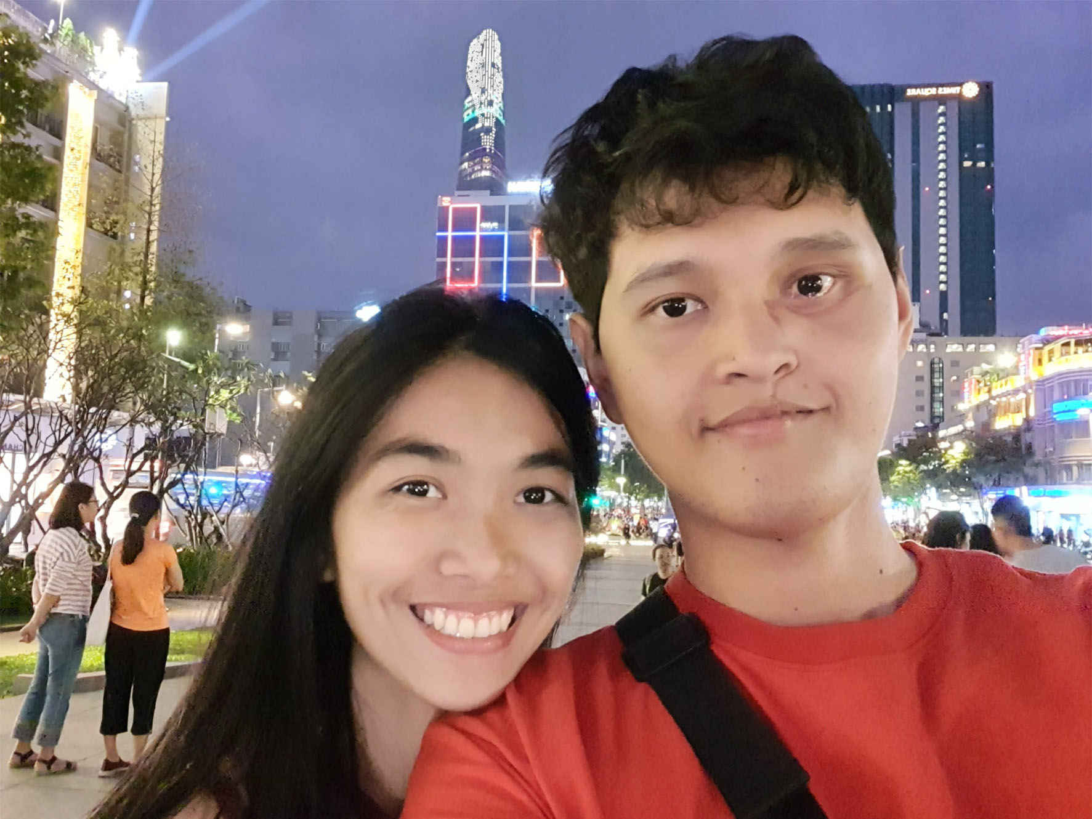
us/image/171.jpg
