AtchariyaM/LoRa-Technology-for-Environmental/us/image/172.jpg

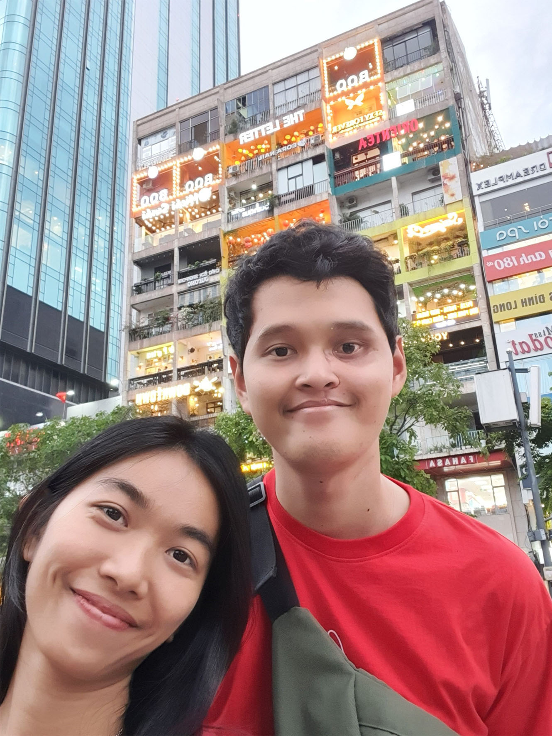
us/image/172.jpg
