AtchariyaM/LoRa-Technology-for-Environmental/us/image/231.jpg

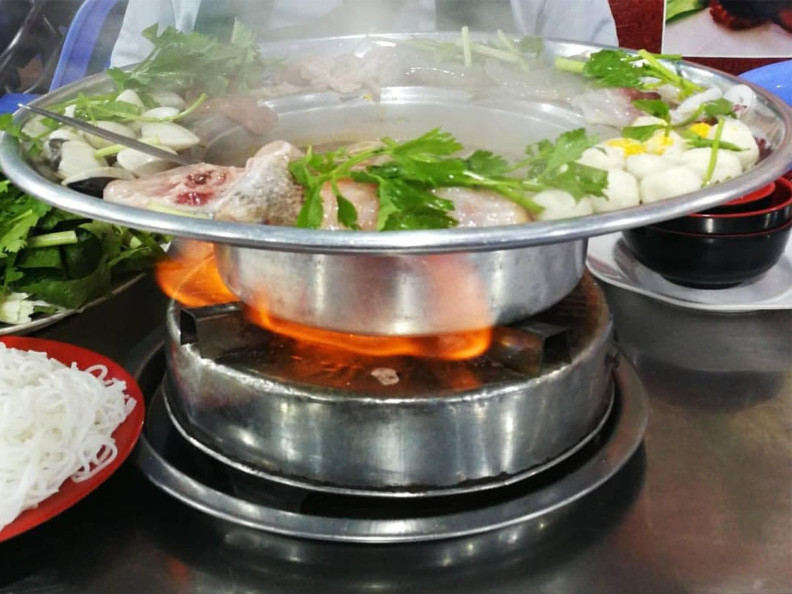
us/image/231.jpg
