AtchariyaM/LoRa-Technology-for-Environmental/us/image/281.jpg

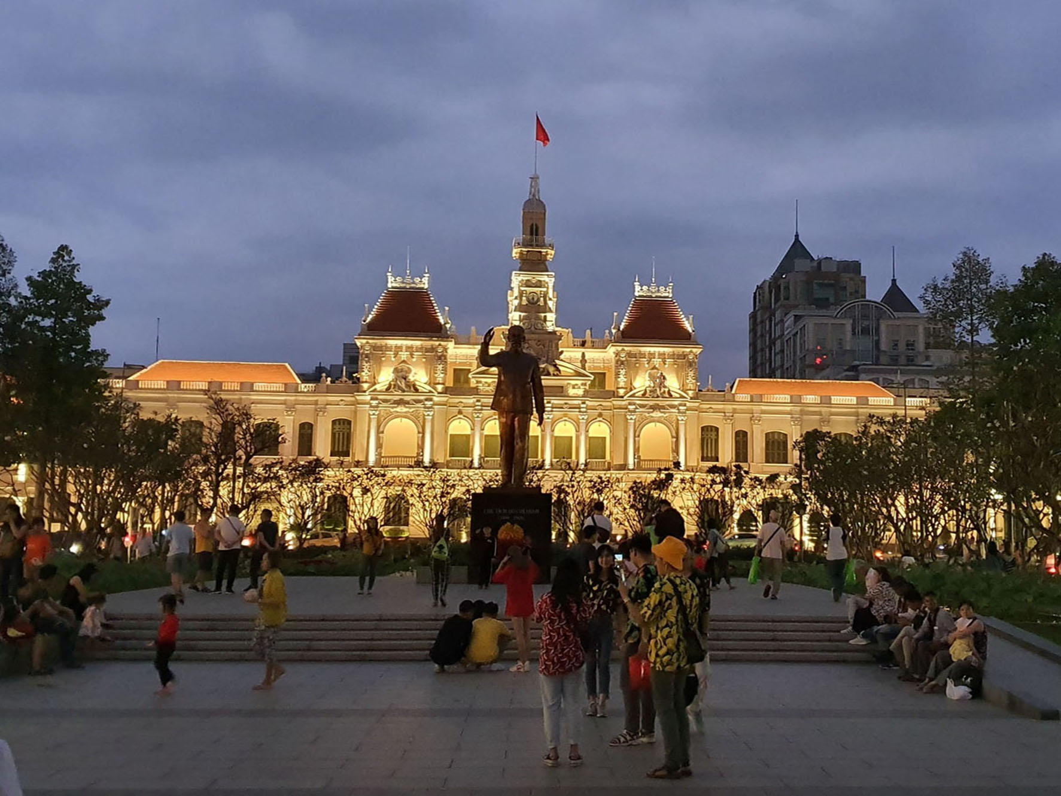
us/image/281.jpg
