AtchariyaM/LoRa-Technology-for-Environmental/us/image/1222.jpg

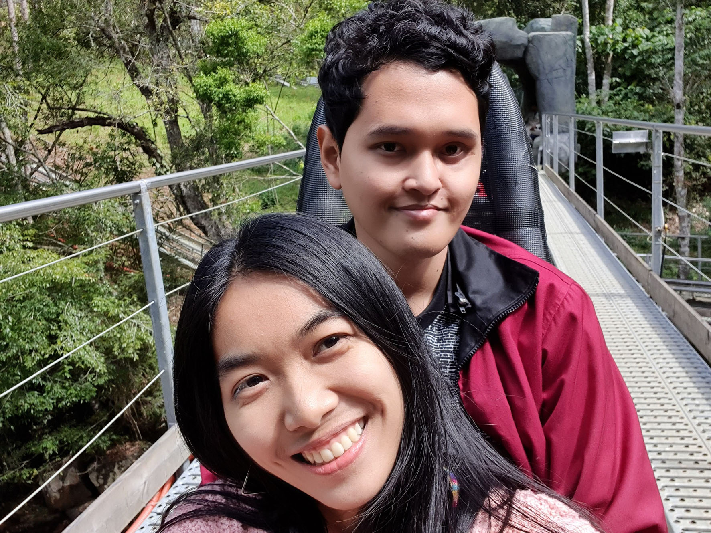
us/image/1222.jpg
