AtchariyaM/LoRa-Technology-for-Environmental/us/image/1411.jpg

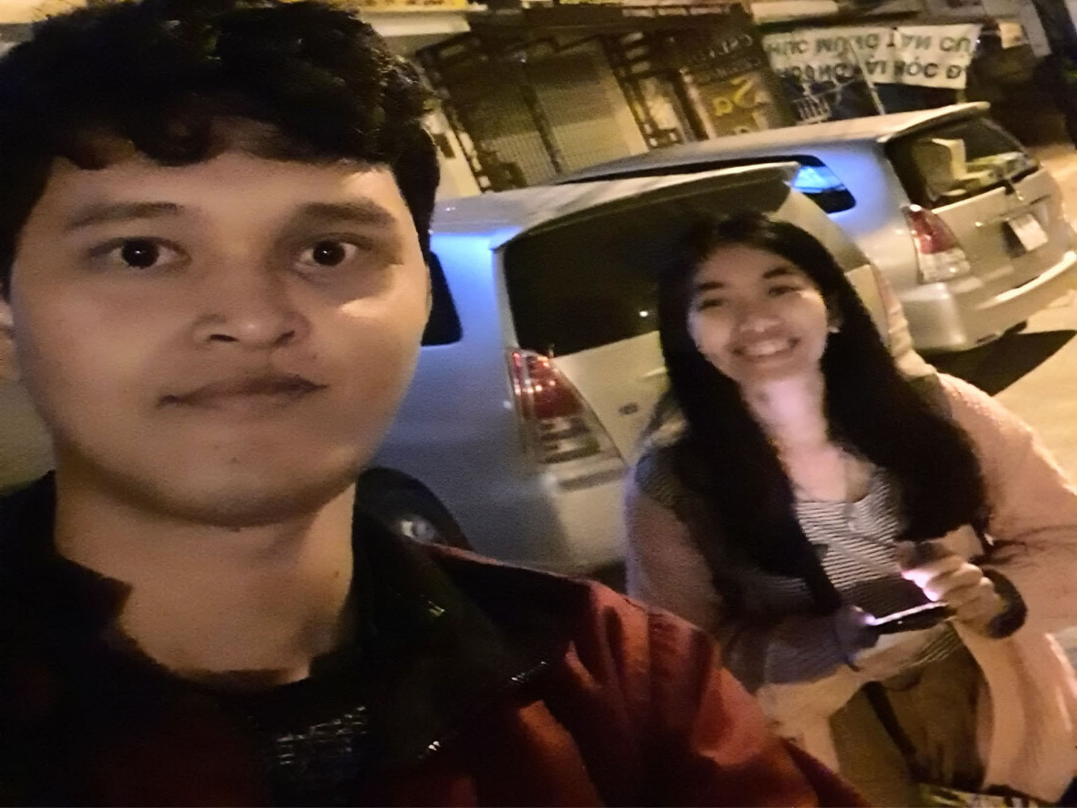
us/image/1411.jpg
