AtchariyaM/LoRa-Technology-for-Environmental/us/image/12222.jpg

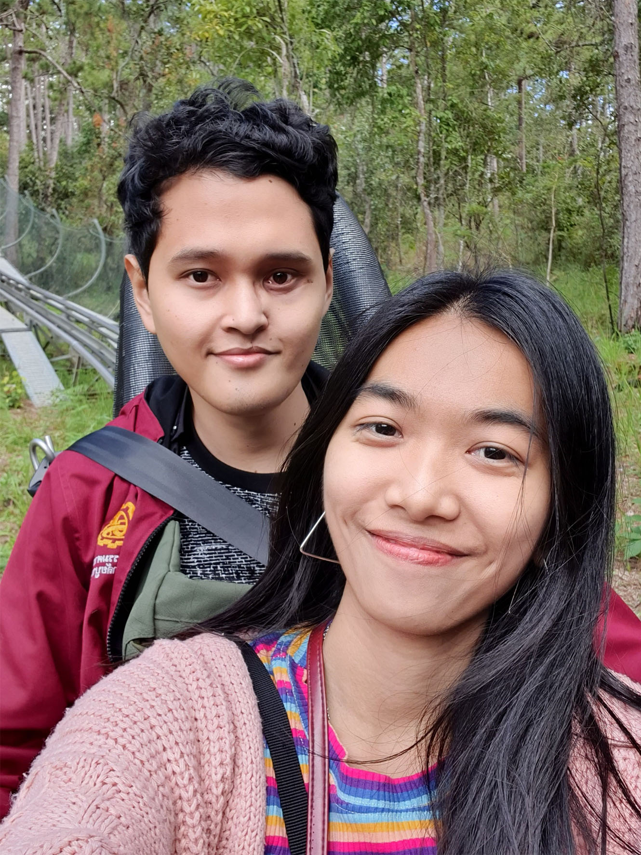
us/image/12222.jpg
