AtchariyaM/LoRa-Technology-for-Environmental/us/image/122222.jpg

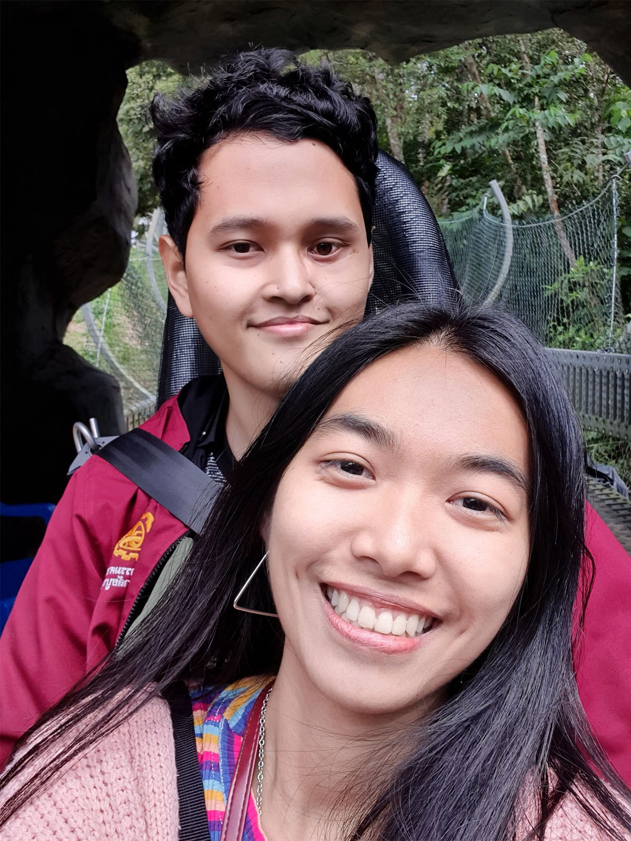
us/image/122222.jpg
