AtchariyaM/LoRa-Technology-for-Environmental/us/image/a.jpg

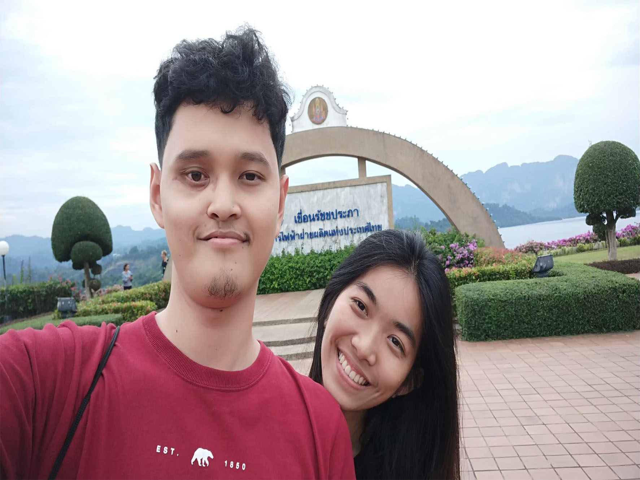
us/image/a.jpg
