AtchariyaM/LoRa-Technology-for-Environmental/us/image/b.jpg

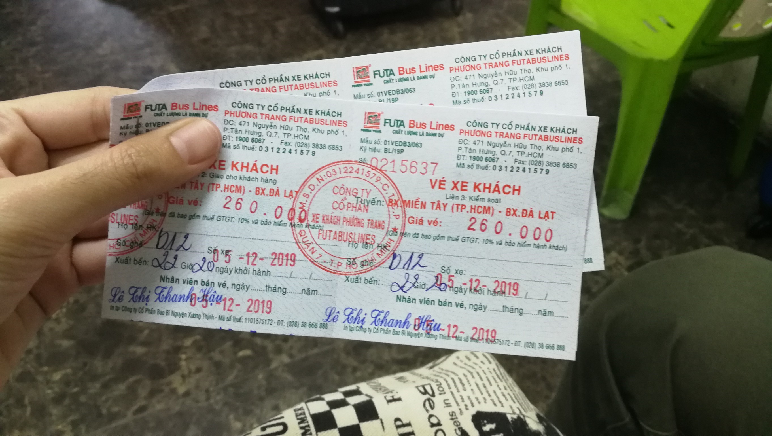
us/image/b.jpg
