AtchariyaM/LoRa-Technology-for-Environmental/us/image/dalat.jpg

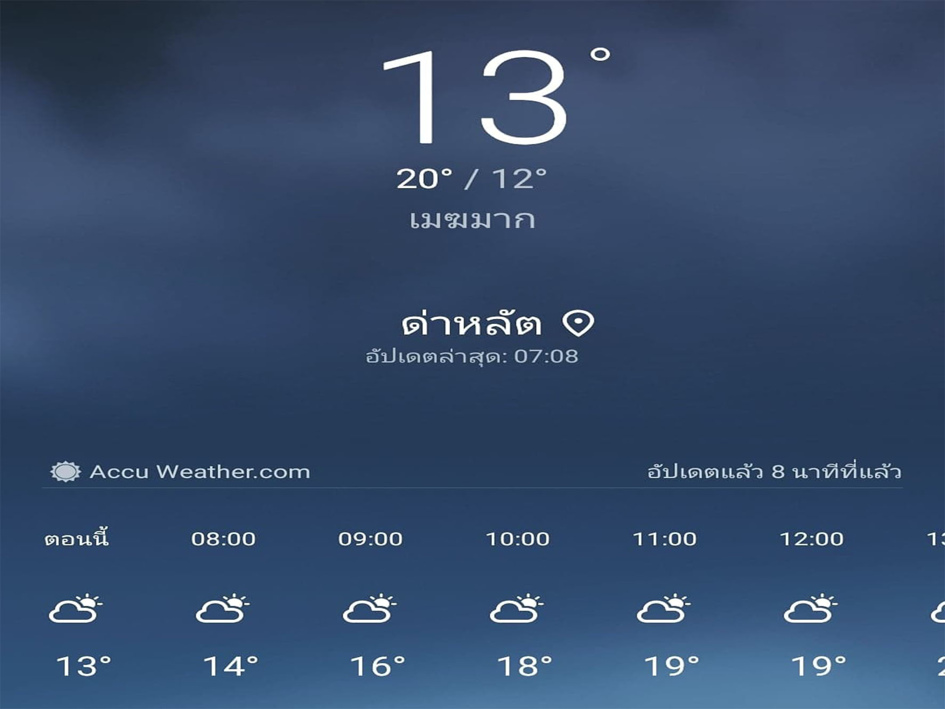
us/image/dalat.jpg
