AtchariyaM/LoRa-Technology-for-Environmental/us/image/g.jpg

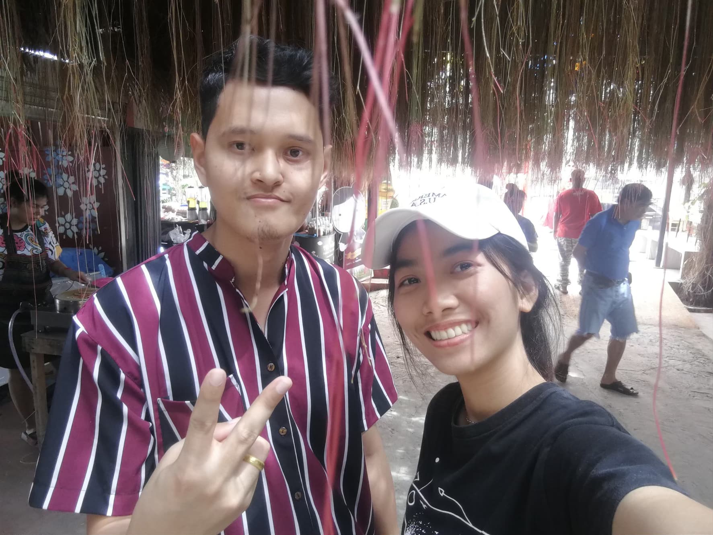
us/image/g.jpg
