AtchariyaM/LoRa-Technology-for-Environmental/us/image/heart 1.png

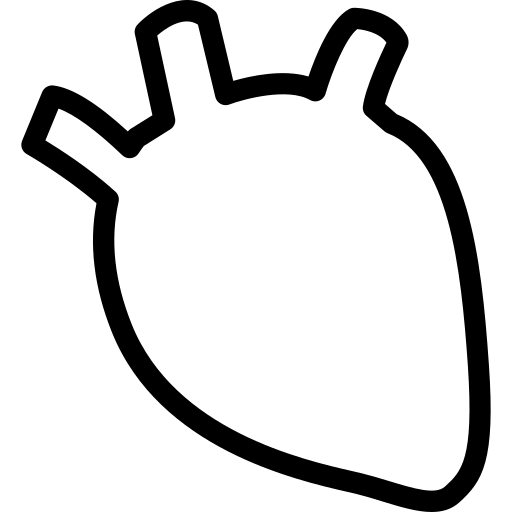
us/image/heart 1.png
