AtchariyaM/LoRa-Technology-for-Environmental/us/image/heart.png

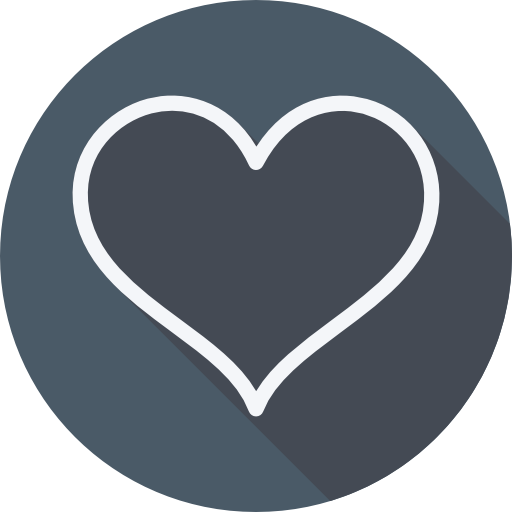
us/image/heart.png
