AtchariyaM/LoRa-Technology-for-Environmental/us/image/lock.png

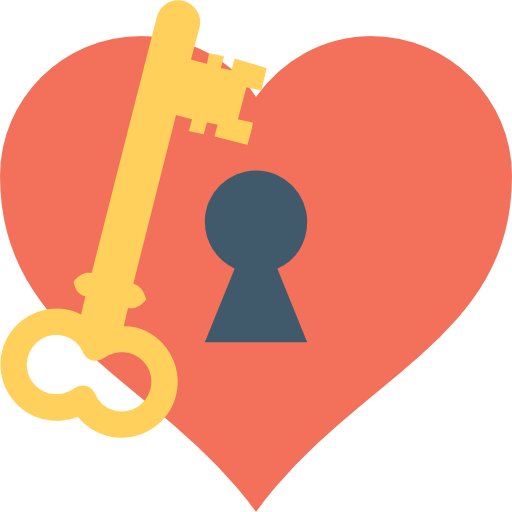
us/image/lock.png
