AtchariyaM/LoRa-Technology-for-Environmental/us/image/love.jpg

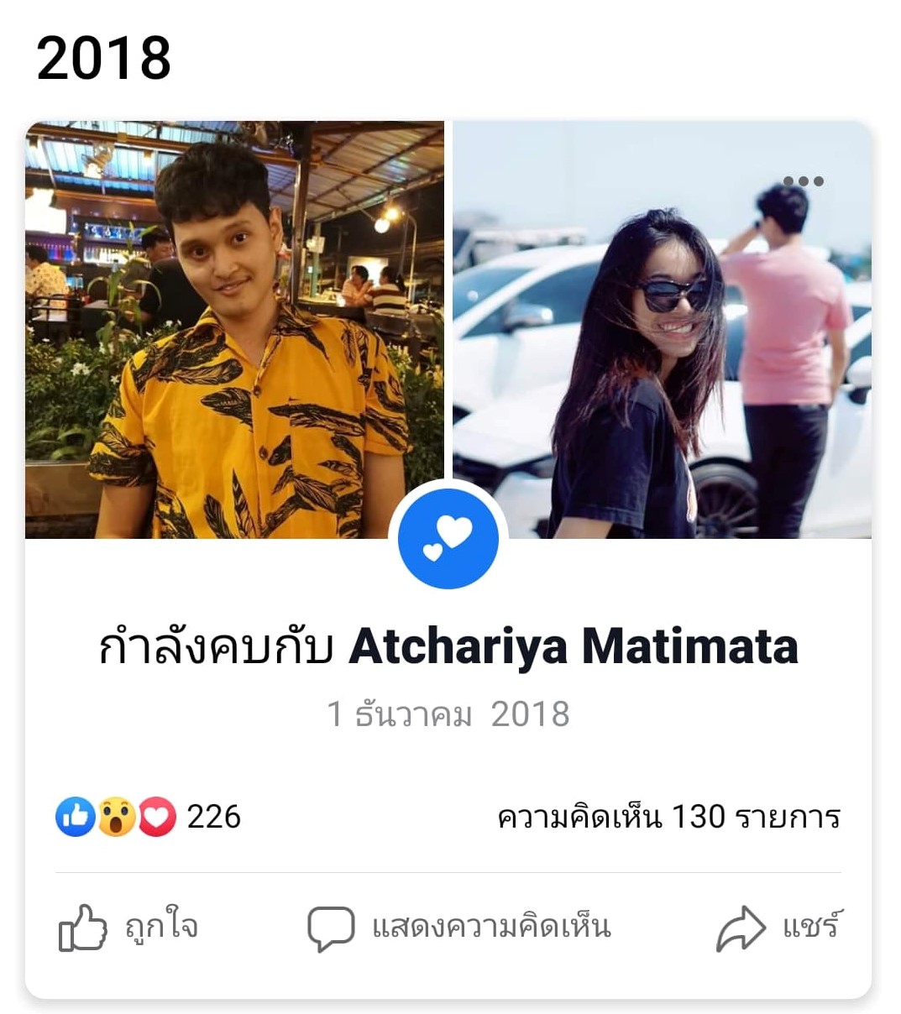
us/image/love.jpg
