AtchariyaM/LoRa-Technology-for-Environmental/us/image/muine.jpg

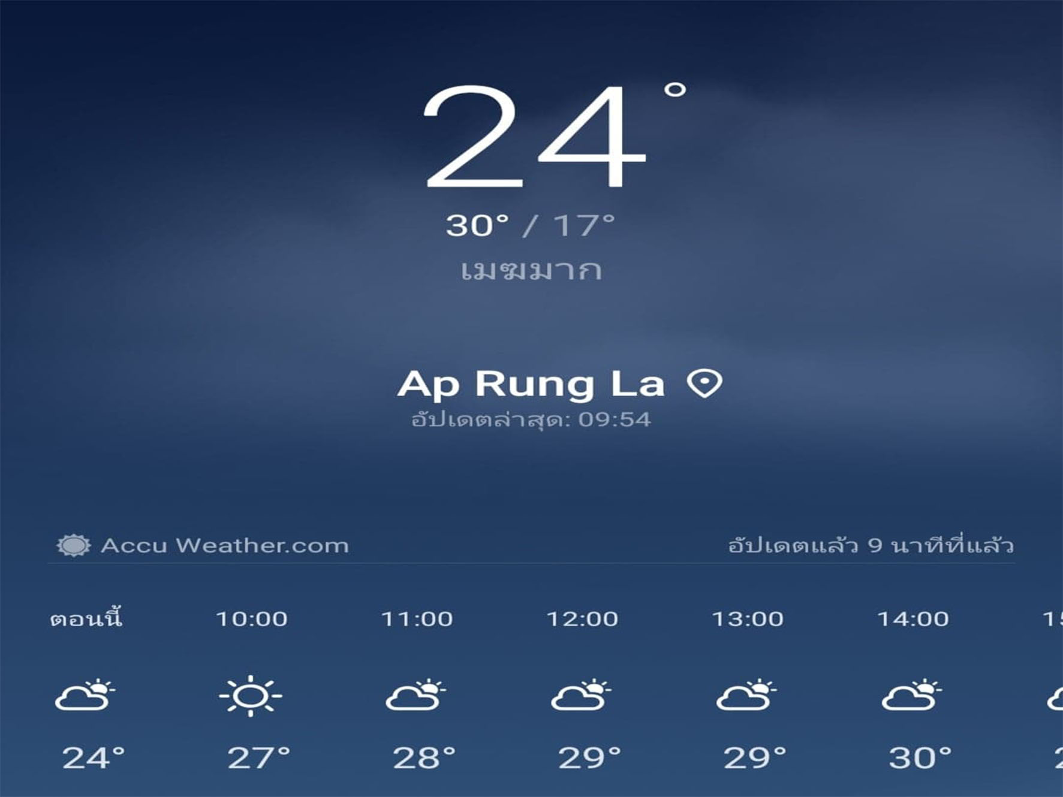
us/image/muine.jpg
