AtchariyaM/LoRa-Technology-for-Environmental/us/image/n.jpg

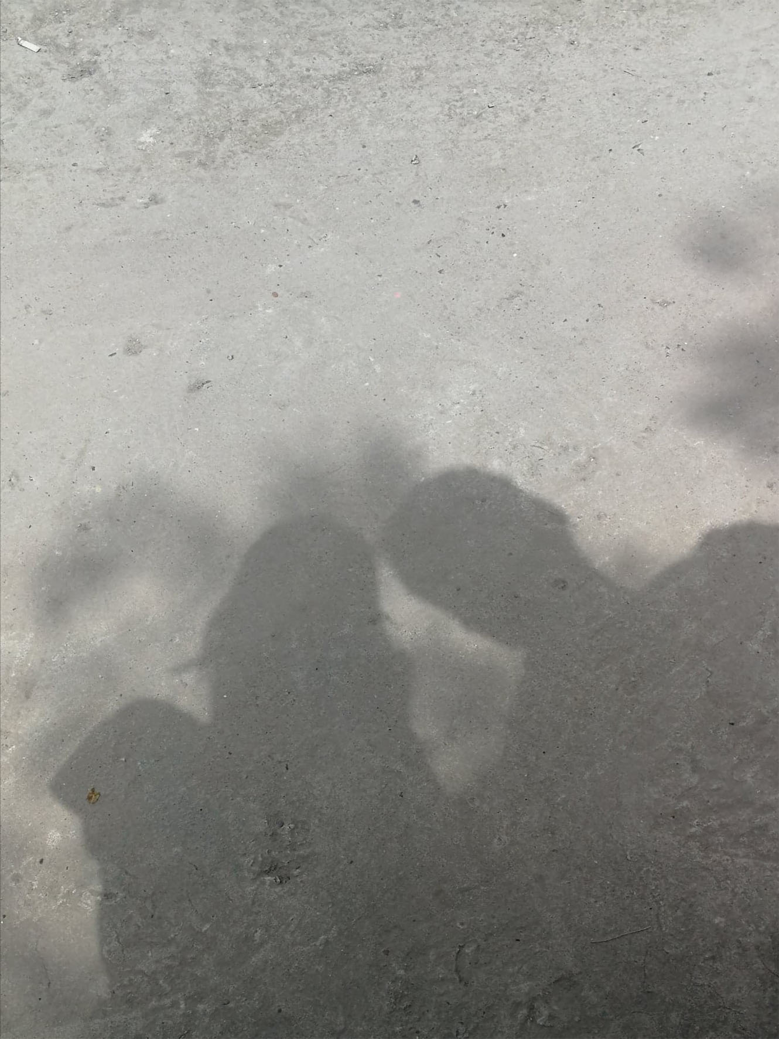
us/image/n.jpg
