AtchariyaM/LoRa-Technology-for-Environmental/us/image/Untitled.jpg

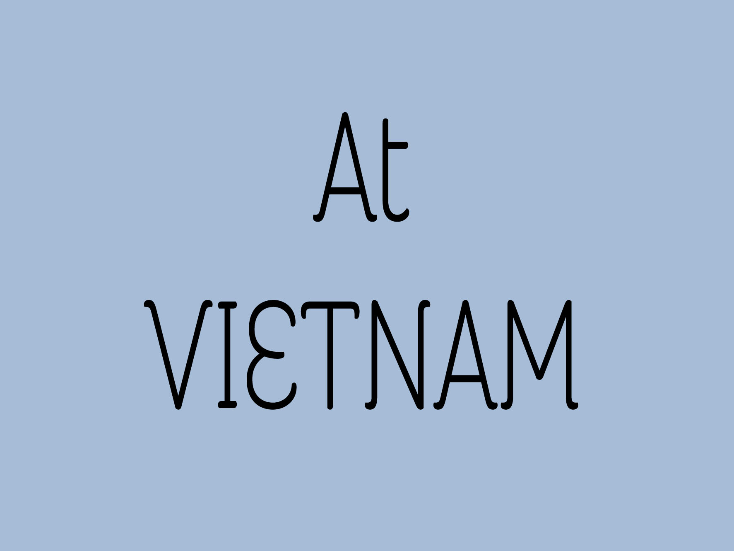
us/image/Untitled.jpg
